Tyrsz/Audio_Processor/Thesis/Report/Figures/Pictures/Aellö Front w.jpg

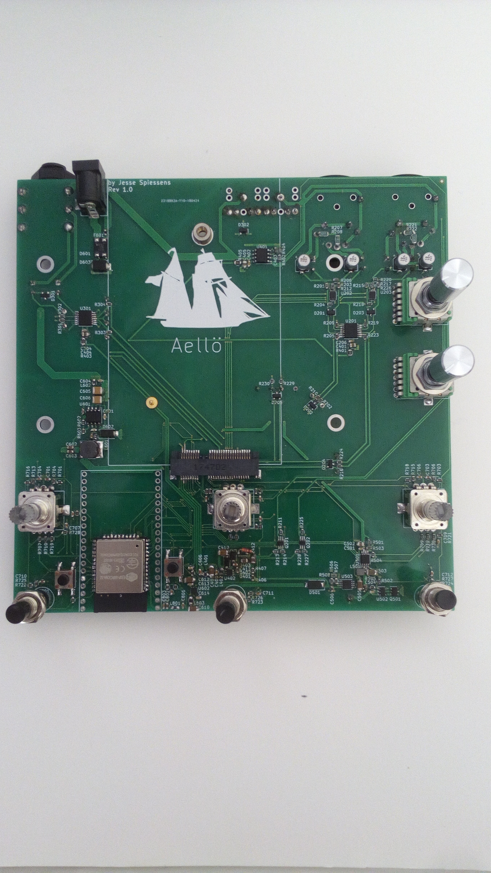
Thesis/Report/Figures/Pictures/Aellö Front w.jpg
