Tyrsz/Audio_Processor/Thesis/Report/Figures/Pictures/MCU.jpg

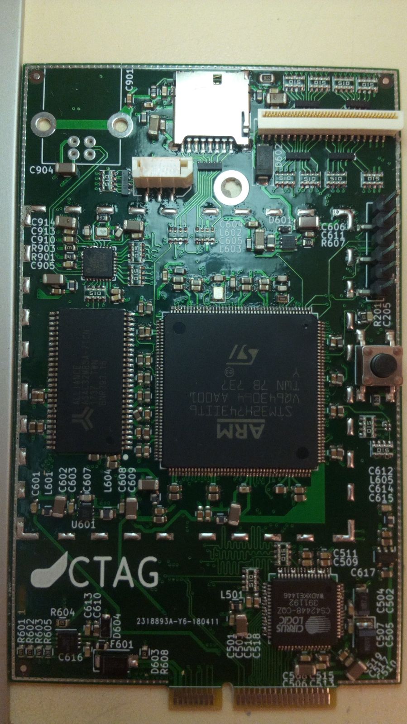
Thesis/Report/Figures/Pictures/MCU.jpg
