Tyrsz/Audio_Processor/Thesis/Report/titelblad eindwerk 2017-2018.docx

Modular Audio Effects Pedal
Door: Jesse Spiessens Promotor hogeschool: Dirk Van Merode Promotor bedrijf: Robert Manzke | Bachelor Electronica-ICT Embedded ICT
| Eindwerk voorgedragen tot het behalen van de graad en het diploma van bachelor Electronica-ICT
| Academiejaar 2017-2018 Campus De Nayer, Jan De Nayerlaan 5, BE-2860 Sint-Katelijne-Waver

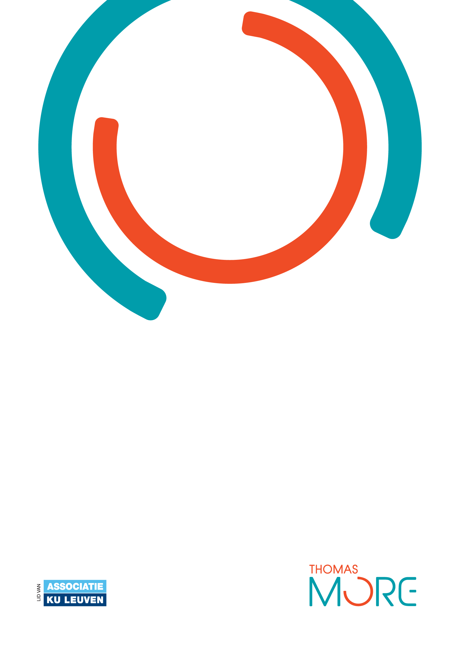
[picture p29: figure]
