Tyrsz/Audio_Processor/Thesis/Cap'n MaGee datasheet/Artwork/Outline/Outline Back.png

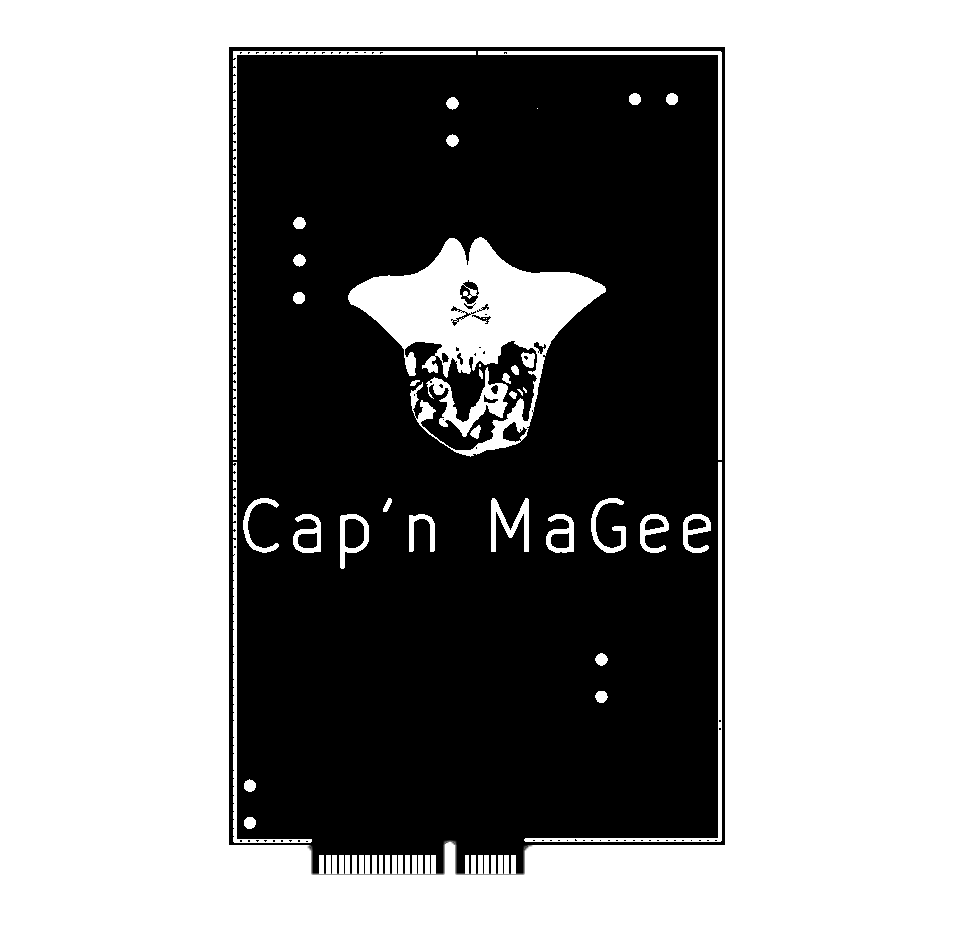
Thesis/Cap'n MaGee datasheet/Artwork/Outline/Outline Back.png
