Tyrsz/Audio_Processor/Thesis/Cap'n MaGee datasheet/Artwork/Outline/Outline Front Connector.png

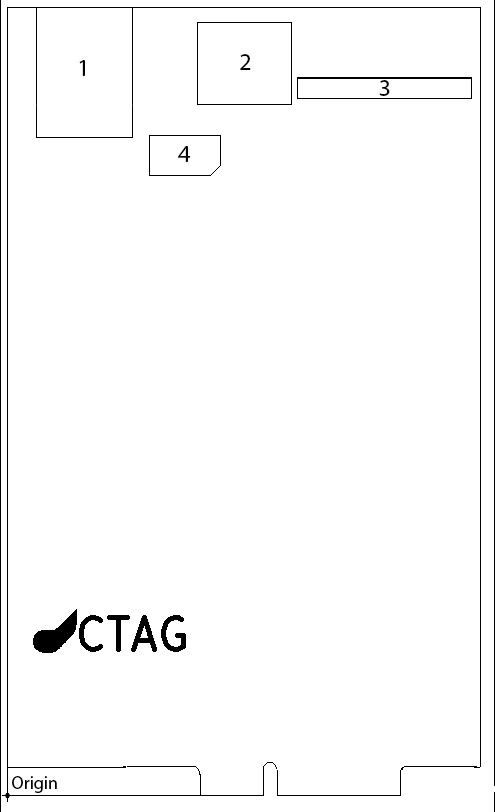
Thesis/Cap'n MaGee datasheet/Artwork/Outline/Outline Front Connector.png
