Tyrsz/Audio_Processor/Thesis/Cap'n MaGee datasheet/Artwork/Outline/Outline Front Dimensions.png

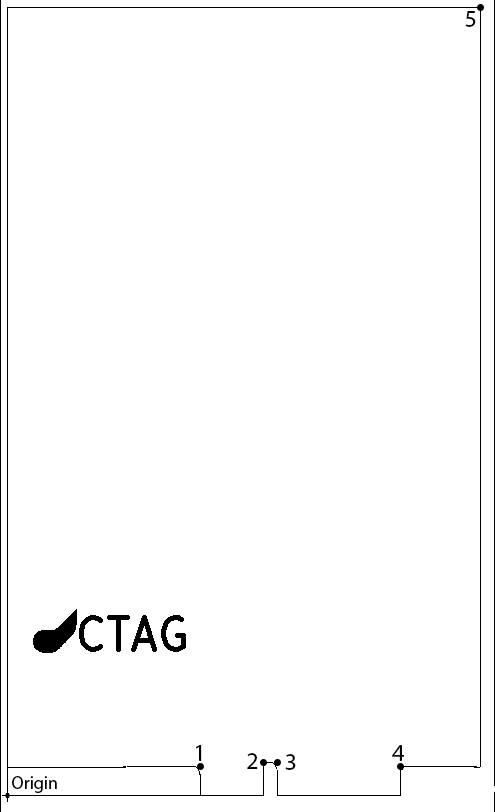
Thesis/Cap'n MaGee datasheet/Artwork/Outline/Outline Front Dimensions.png
