Tyrsz/Audio_Processor/Thesis/Cap'n MaGee datasheet/Artwork/Outline/Outline Front.png

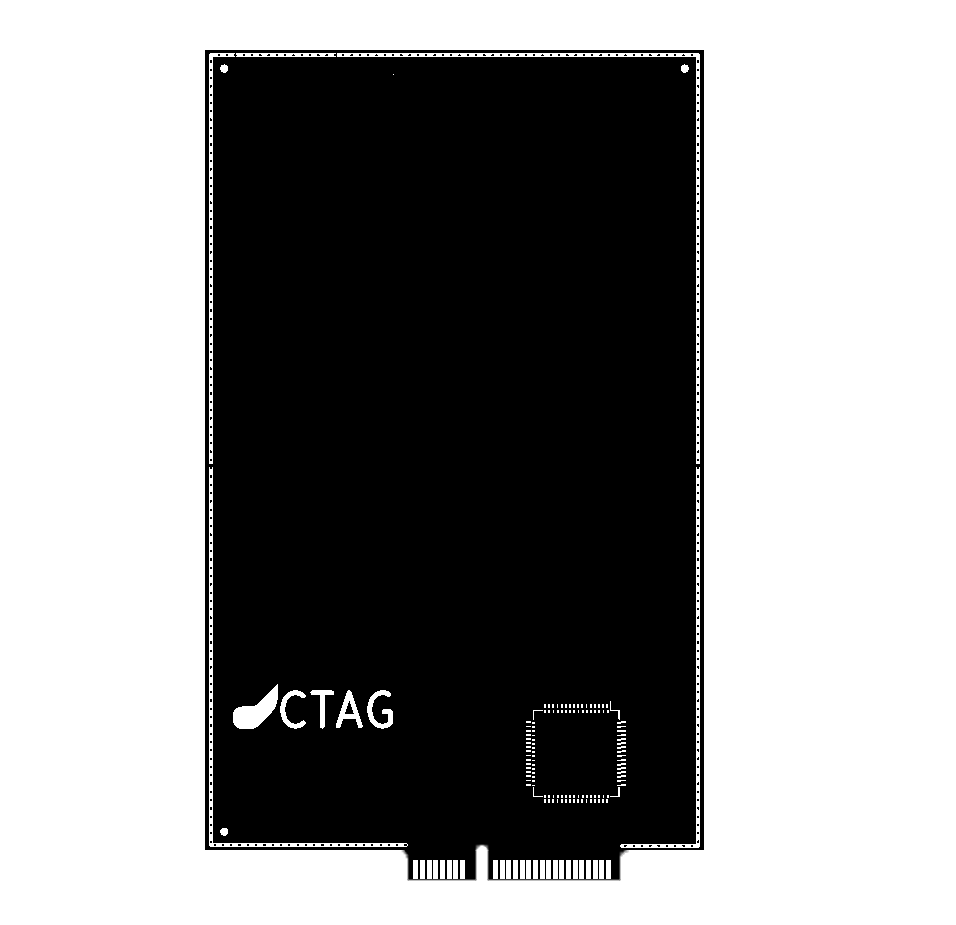
Thesis/Cap'n MaGee datasheet/Artwork/Outline/Outline Front.png
