Tyrsz/Audio_Processor/Thesis/Cap'n MaGee datasheet/Notes/foto's/NewFile1.png

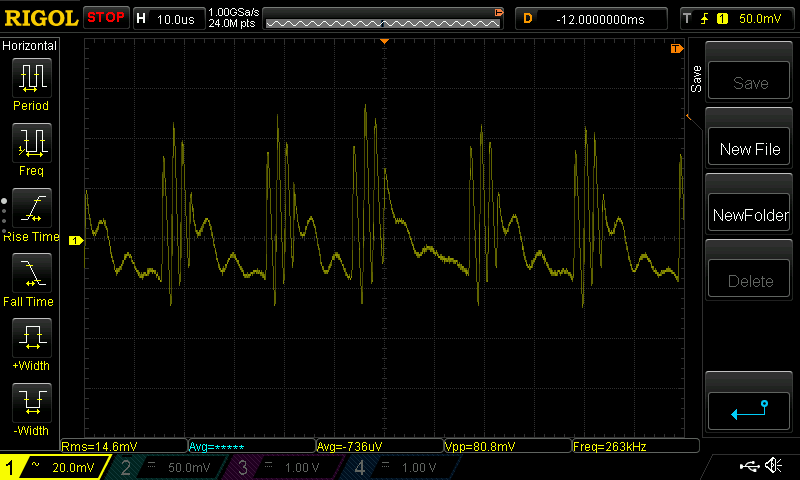
Thesis/Cap'n MaGee datasheet/Notes/foto's/NewFile1.png
