Tyrsz/Audio_Processor/Thesis/Cap'n MaGee datasheet/Notes/foto's/NewFile2.png

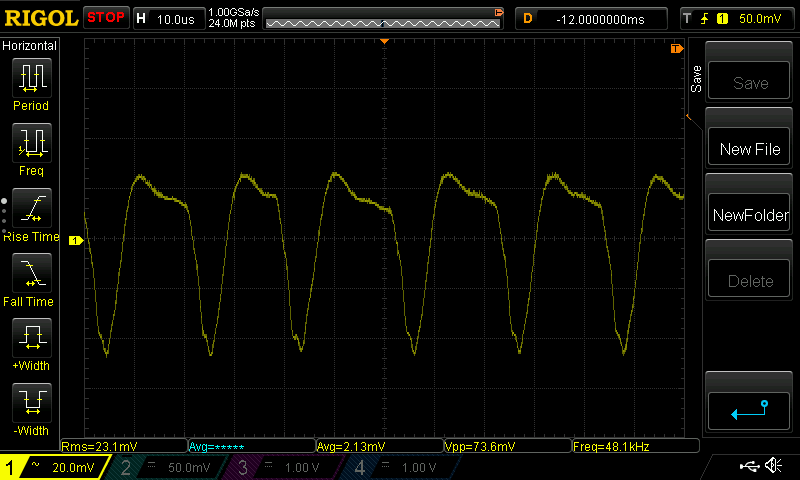
Thesis/Cap'n MaGee datasheet/Notes/foto's/NewFile2.png
