Tyrsz/Audio_Processor/Thesis/Cap'n MaGee datasheet/Notes/foto's/NewFile5.png

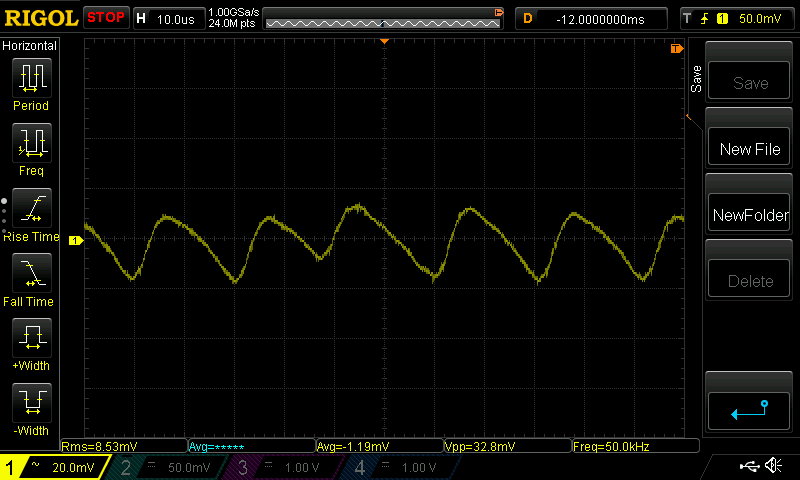
Thesis/Cap'n MaGee datasheet/Notes/foto's/NewFile5.png
