Tyrsz/Audio_Processor/Thesis/Cap'n MaGee datasheet/Notes/foto's/NewFile7.png

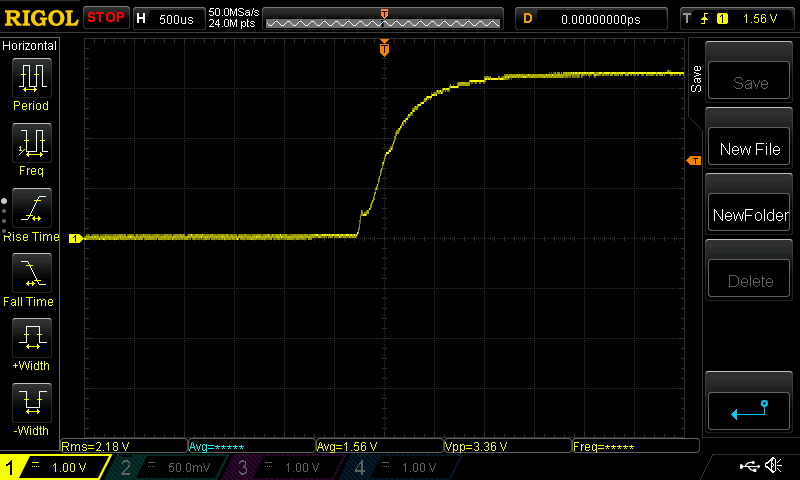
Thesis/Cap'n MaGee datasheet/Notes/foto's/NewFile7.png
