Tyrsz/Audio_Processor/Thesis/Cap'n MaGee datasheet/Notes/foto's/NewFile8.png

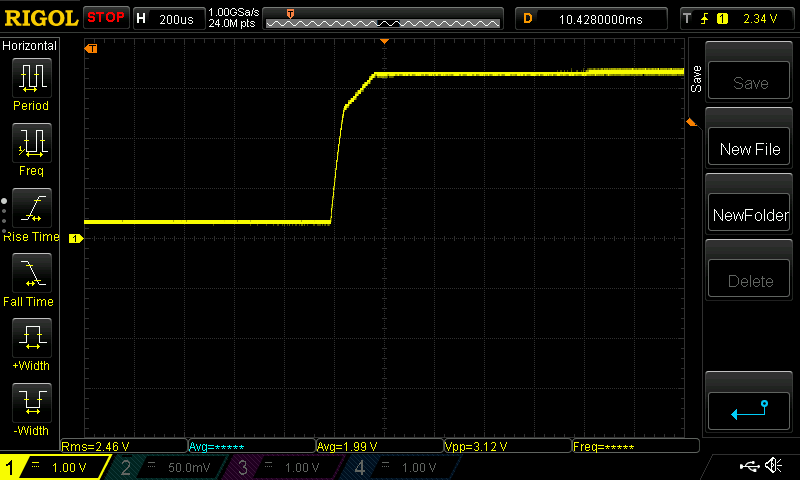
Thesis/Cap'n MaGee datasheet/Notes/foto's/NewFile8.png
