Tyrsz/Audio_Processor/Thesis/Cap'n MaGee datasheet/Notes/foto's/NewFile9.png

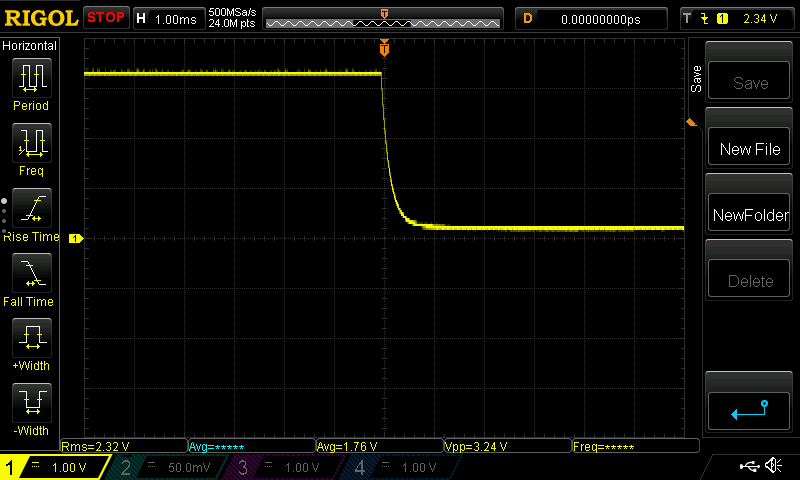
Thesis/Cap'n MaGee datasheet/Notes/foto's/NewFile9.png
