Tyrsz/Audio_Processor/Thesis/Cap'n MaGee datasheet/Notes/foto's/NewFile10.png

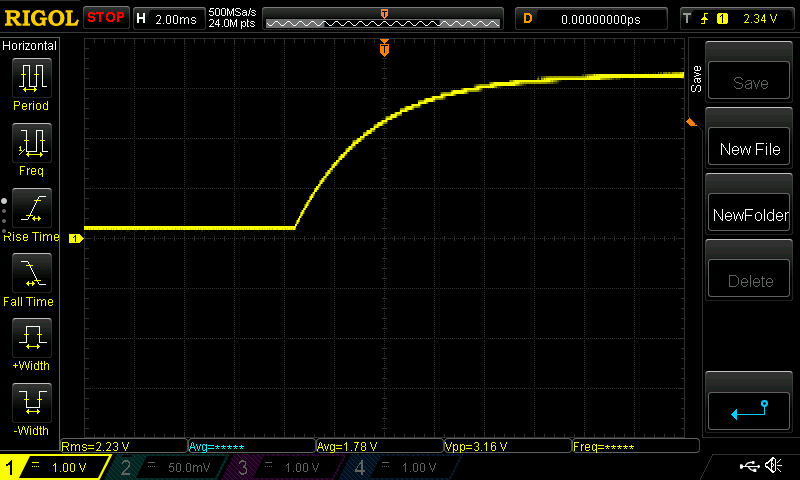
Thesis/Cap'n MaGee datasheet/Notes/foto's/NewFile10.png
