Tyrsz/Audio_Processor/Thesis/Report/Figures/bouncing.png

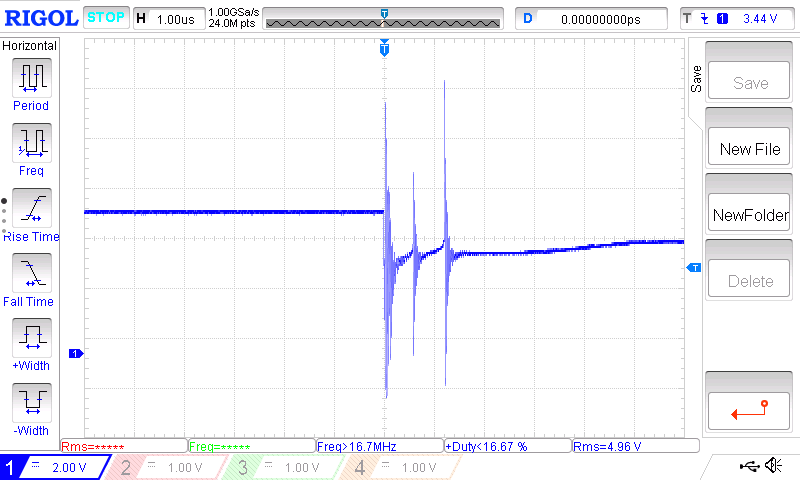
Thesis/Report/Figures/bouncing.png
