Tyrsz/Audio_Processor/Thesis/Report/Figures/Cap'n Magee.jpg

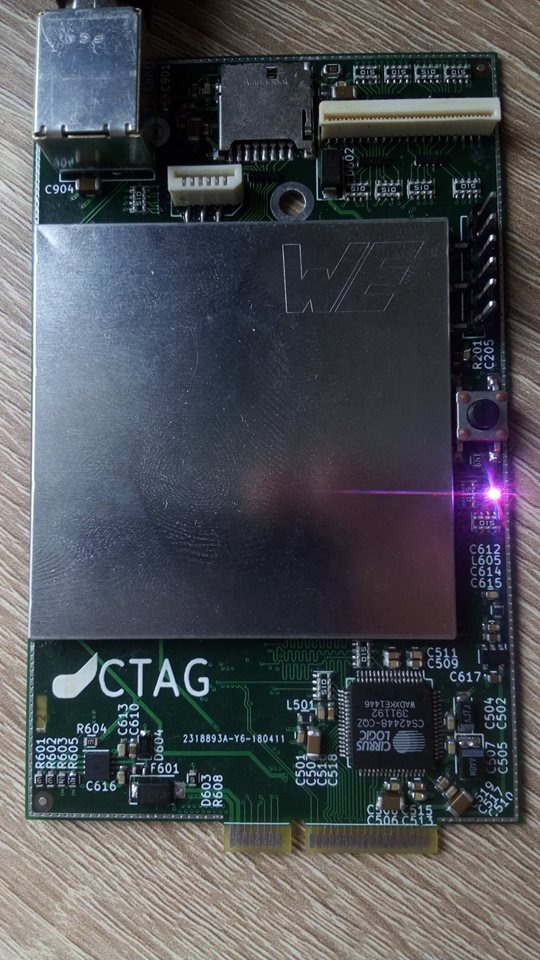
Thesis/Report/Figures/Cap'n Magee.jpg
