Tyrsz/Audio_Processor/Thesis/Report/Figures/Pictures/Cap'n Magee Front.jpg

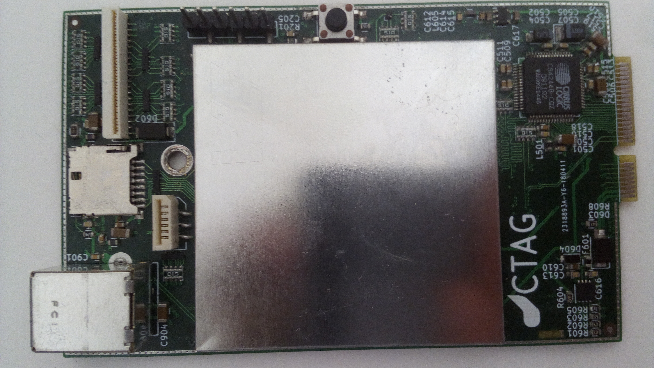
Thesis/Report/Figures/Pictures/Cap'n Magee Front.jpg
