Tyrsz/Audio_Processor/Thesis/Report/Figures/Pictures/IMG_20180526_105409.jpg

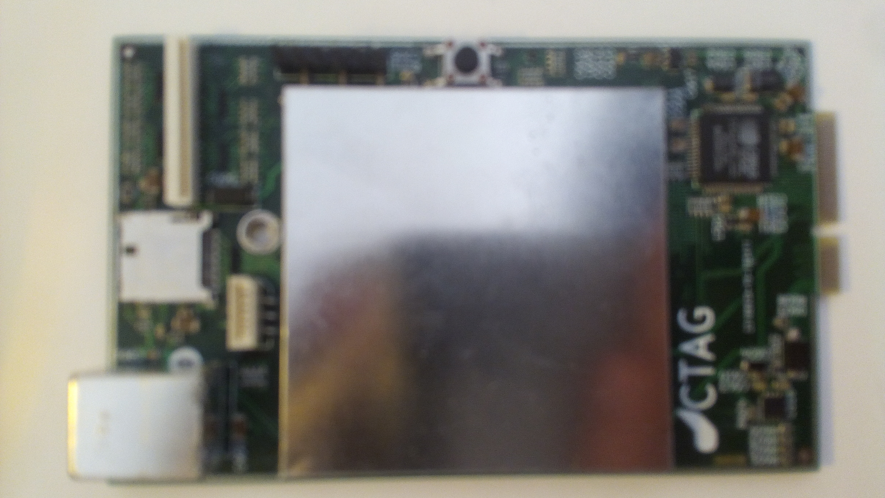
Thesis/Report/Figures/Pictures/IMG_20180526_105409.jpg
