Tyrsz/Audio_Processor/Thesis/Report/Figures/Pictures/IMG_20180526_105412.jpg

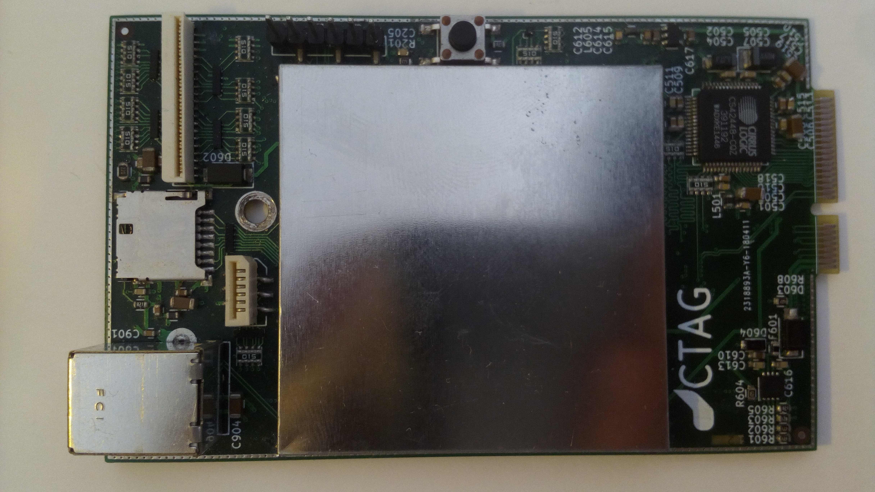
Thesis/Report/Figures/Pictures/IMG_20180526_105412.jpg
