Tyrsz/Audio_Processor/Thesis/Report/Figures/Pictures/IMG_20180526_110501.jpg

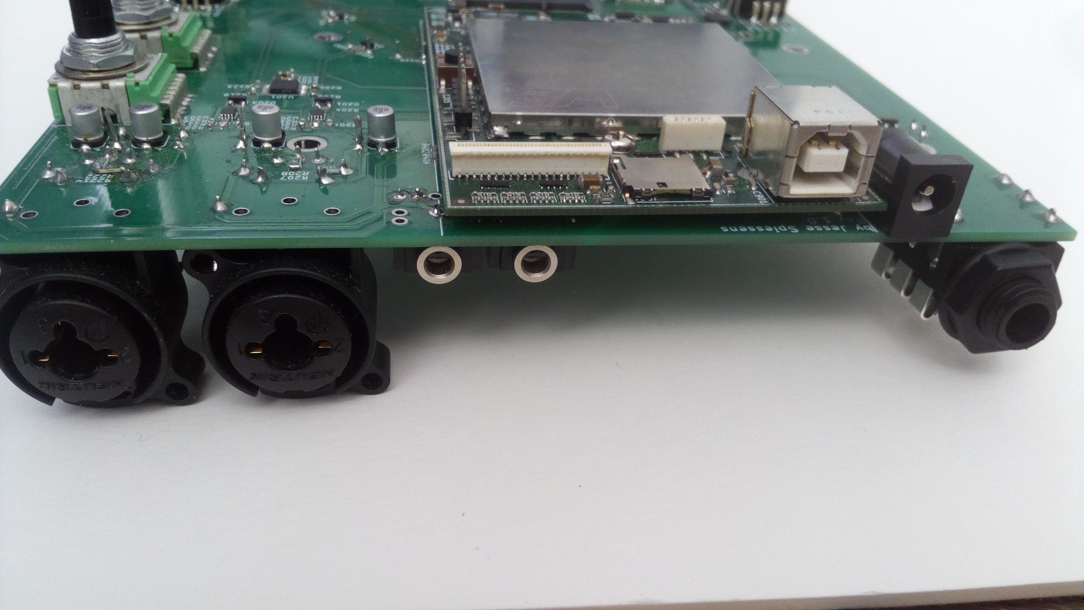
Thesis/Report/Figures/Pictures/IMG_20180526_110501.jpg
