Tyrsz/Audio_Processor/Thesis/Report/Figures/Pictures/IMG_20180526_151601.jpg

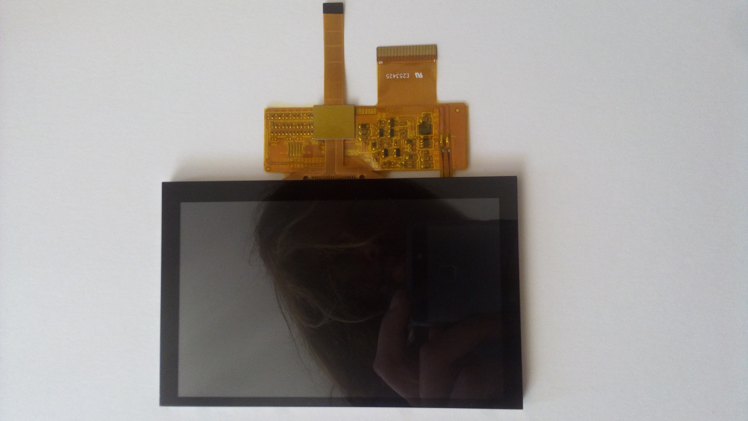
Thesis/Report/Figures/Pictures/IMG_20180526_151601.jpg
