Tyrsz/Audio_Processor/Thesis/Report/Figures/Pictures/Joint connector.jpg

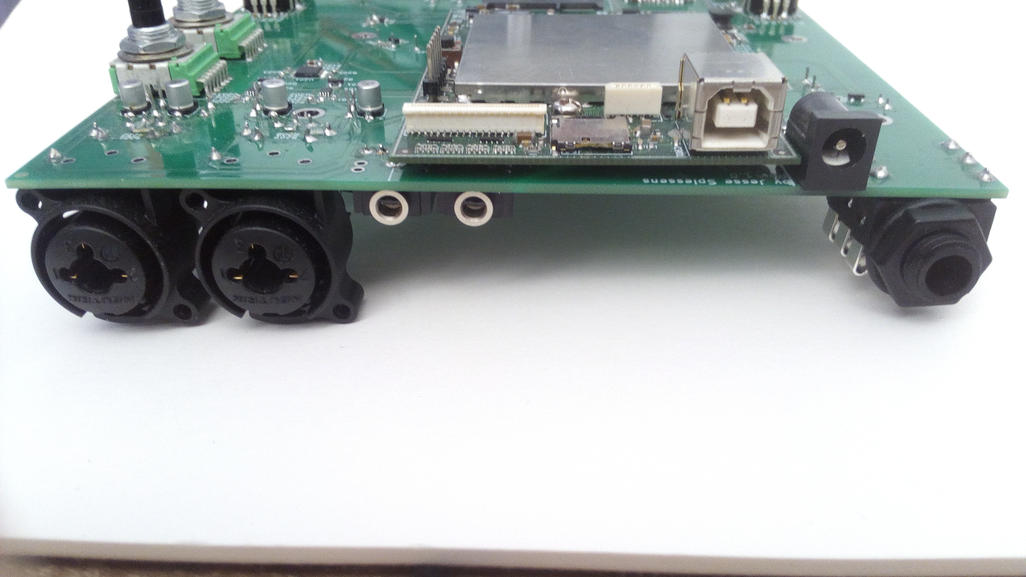
Thesis/Report/Figures/Pictures/Joint connector.jpg
