Tyrsz/Audio_Processor/Thesis/Report/Figures/Pictures/Screen.jpg

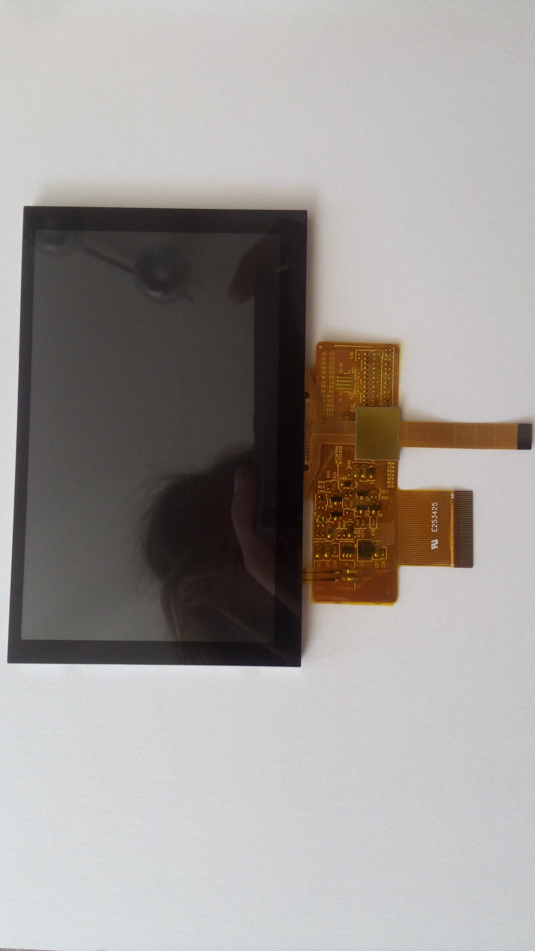
Thesis/Report/Figures/Pictures/Screen.jpg
