Tyrsz/Audio_Processor/Thesis/Report/Figures/program structure (1).png

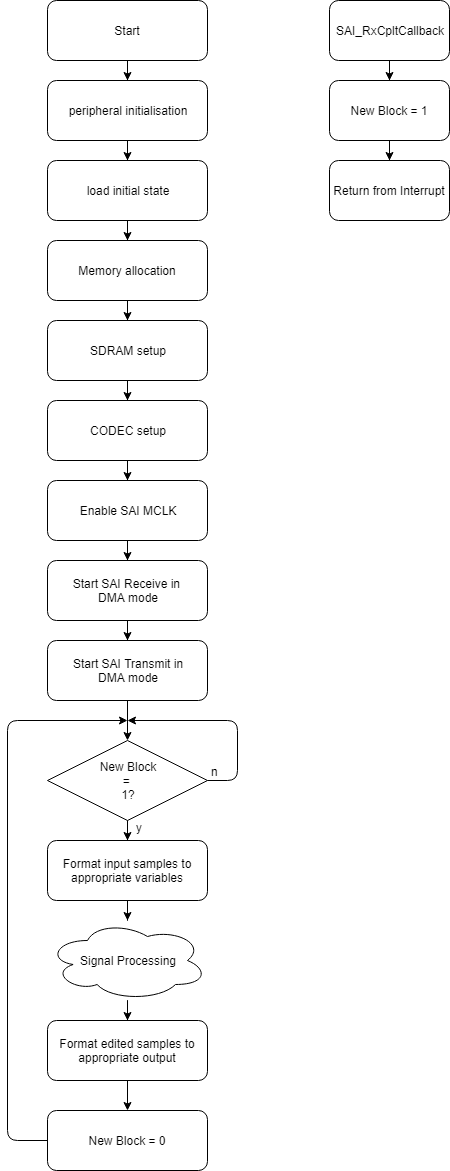
Thesis/Report/Figures/program structure (1).png
