Tyrsz/Audio_Processor/Thesis/Report/Figures/Ringing.png

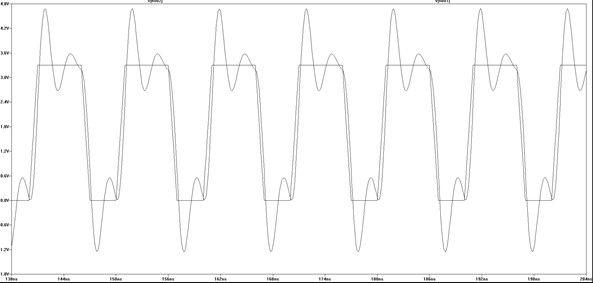
Thesis/Report/Figures/Ringing.png
