Tyrsz/Audio_Processor/PCB/DSP board/BOM/Bachelor PCB.ods

Description | package | Name | Amount | Price | Order number | Link
MCU | LQFP-176 | STM32H743IIT6 | 0 | 0 | 511-STM32H743IIT6 | https://www.mouser.be/ProductDetail/STMicroelectronics/STM32H743IIT6
SDRAM 32MByte | TSSOP-54 | AS4C32M8SA-7TCN | 1 | 3,12 | 913-AS4C32M8SA7TCN | https://www.mouser.be/ProductDetail/Alliance-Memory/AS4C32M8SA-7TCN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
CODEC | LQFP-64 | CS42448-CQZ | 1 | 9,42 | 777-CS42448-CQZ | https://www.mouser.be/ProductDetail/Cirrus-Logic/CS42448-CQZ?qs=sGAEpiMZZMuYaq4aOfOV%252bIuNLgj4vBkq
USB Phy | QFN-32 | USB3300-EZK-TR | 1 | 1,22 | 886-USB3300-EZK-TR | https://www.mouser.be/ProductDetail/Microchip-Technology/USB3300-EZK-TR
Power mux | SON-8 | TPS2113ADRBR | 1 | 1,6 | 595-TPS2113ADRBR | https://www.mouser.be/ProductDetail/Texas-Instruments/TPS2113ADRBR?qs=sGAEpiMZZMsIeRsI8taJiut%252bTnXQ%252bmOX
Buck | MLF-8 | MIC23050-SYML-TR | 1 | 0,385 | 998-MIC23050-SYMLTR | https://www.mouser.be/ProductDetail/Microchip-Technology-Micrel/MIC23050-SYML-TR
low noise LDO | TSOT-5 | ADP150AUJZ-3.3-R7 | 1 |  | 584-ADP150AUJZ-3.3R7 | https://www.mouser.be/ProductDetail/Analog-Devices/ADP150AUJZ-33-R7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
 |  | ADP151AUJZ-3.3-R7 | 1 | 0,877 | 584-ADP151AUJZ-3.3R7 | https://www.mouser.be/ProductDetail/Analog-Devices/ADP151AUJZ-33-R7
Boost | WSON-6 | TPS61170DRVR | 1 | 1,71 | 595-TPS61170DRVR | https://www.mouser.be/productdetail/texas-instruments/tps61170drvr
6 pin header | 2.54mm SMD | M20-8770646 | 1 | 0,361 | 855-M20-8770646 | https://www.mouser.be/ProductDetail/Harwin/M20-8770646
40 pin 0.5mm | 0.5mm vertical | 78127-1408 | 1 | 1,94 | 538-78127-1408 | https://www.mouser.be/ProductDetail/Molex/78127-1408
6 pin 1mm | 1mm vertical | 52808-0671 | 1 | 0,484 | 538-52808-0671 | https://www.mouser.be/ProductDetail/Molex/52808-0671?qs=sGAEpiMZZMs7i6cT6ogu4152O94naRbpkoChlag4gQ4=
SD Holder | 1140084168 | SMD | 1 | 1,23 | 523-114-00841-68 | https://www.mouser.be/ProductDetail/Amphenol-Commercial-Products/1140084168
USB connector Mini | UJ2-BH-1-TH | Type B | 1 | 0,525 | 490-UJ2-BH-1-TH | https://www.mouser.be/ProductDetail/CUI/UJ2-BH-1-TH
Button | 6x6mm smd | FSM4JSMATR | 1 | 0,139 | 506-FSM4JSMATR | https://www.mouser.be/ProductDetail/TE-Connectivity-Alcoswitch/FSM4JSMATR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
32KHz crystal | 1.6x1mm | ABS05-32.768KHZ-9-T | 1 | 0,64 | 815-ABS05-32.768K9T | https://www.mouser.be/ProductDetail/ABRACON/ABS05-32768KHZ-9-T
16MHz crystal | 2x1.6mm | CX2016DB16000H0FLJC1 | 1 |  | 581-CX2016DB16000HLJ | https://www.mouser.be/ProductDetail/AVX-Kyocera/CX2016DB16000H0FLJC1
 | 2x1.6mm | FW1600008 | 1 | 1,15 | 729-FW1600008 | https://www.mouser.be/ProductDetail/Diodes-Inc-Pericom/FW1600008?qs=Rp3RbKSfAt3lER%252bb%252byb4eQ%3d%3d
24MHz crystal | 2x1.6mm | XRCGB24M000F1H02R0 | 1 | 0,41 | 81-XRCGB24M000F1H02R | https://www.mouser.be/ProductDetail/Murata-Electronics/XRCGB24M000F1H02R0
1.25A fuse | 0603 | F0603E1R25FSTR | 1 | 0,23 | 581-F0603E1R25FSTR | https://www.mouser.be/ProductDetail/AVX/F0603E1R25FSTR
EMI gasket | 50x50mm | 36103505S | 1 | 1,73 | 710-36103505S | https://www.mouser.be/ProductDetail/Wurth-Electronics/36103505S
EMI hat | 50x50mm | 36003500S | 1 | 1,22 | 710-36003500S | https://www.mouser.be/ProductDetail/Wurth-Electronics/36003500S
3mm mounting screw | 4mm M3-0.5 | 481-0263 | 1 | 0,162 | 481-0263 | https://www.mouser.be/ProductDetail/Eagle-Plastic-Devices/481-0263
Caps
100nF 10V X7R | 0603 | 8,85012E+11 | 26 | 1,04 | 710-885012206020 | https://www.mouser.be/ProductDetail/Wurth-Electronics/885012206020
2.2uF 10V X7R | 0603 | C1608X7R1A225M080AC | 2 | 0,394 | 810-C1608X7R1A225M | https://www.mouser.be/ProductDetail/TDK/C1608X7R1A225M080AC
1uF 25V X7R | 0603 | TMK107B7105MA-T | 28 |  | 963-TMK107B7105MA-T | https://www.mouser.be/ProductDetail/Taiyo-Yuden/TMK107B7105MA-T
10V | 0603 | LMK107B7105MA-T | 28 | 0,588 | 963-LMK107B7105MA-T | https://www.mouser.be/ProductDetail/Taiyo-Yuden/LMK107B7105MA-T
10nF 50V X7R | 0603 | 8,85012E+11 | 38 |  | 710-885012206089 | https://www.mouser.be/ProductDetail/Wurth-Electronics/885012206089
 | 0603 | C0603C103J5RACTU | 38 | 0,608 | 80-C0603C103J5R | https://www.mouser.be/ProductDetail/KEMET/C0603C103J5RACTU?qs=sGAEpiMZZMvsSlwiRhF8quIsB1QHp5lf6wge94WzHBg%3d
4.7uF 10V X7R | 0805 | GRM21BR71A475ME51L | 12 |  | 81-GRM21BR71A475ME1L | https://www.mouser.be/ProductDetail/Murata-Electronics/GRM21BR71A475ME51L
 | 0805 | GRM21BR71A475KE51L | 12 | 1,248 | 81-GRM21BR71A475KE1L | https://www.mouser.be/ProductDetail/Murata-Electronics/GRM21BR71A475KE51L
18pf C0G | 0603 | C0603C180J5GACTU | 6 |  | 80-C0603C180J5G | https://www.mouser.be/ProductDetail/KEMET/C0603C180J5GACTU?qs=sGAEpiMZZMs0AnBnWHyRQJIiGvDVk92VyAyEaQH0tQM%3d
 | 0603 | C0603C180J5GAC7867 | 6 | 0,492 | 80-C0603C180J5G7867 | https://www.mouser.be/ProductDetail/KEMET/C0603C180J5GAC7867
22uF 10V tantalum | 1206 | TMCMA1A226MTRF | 1 | 0,197 | 74-TMCMA1A226MTRF | https://www.mouser.be/ProductDetail/Vishay-Sprague/TMCMA1A226MTRF
100uF 10V tantalum | 1311 | TMCMB1A107MTRF | 1 | 0,41 | 74-TMCMB1A107MTRF | https://www.mouser.be/ProductDetail/Vishay-Sprague/TMCMB1A107MTRF
560pF C0G | 0603 | VJ0603A561GXXCW1BC | 1 | 0,082 | 77-VJ0603A561GXXCBC | https://www.mouser.be/ProductDetail/Vishay-Vitramon/VJ0603A561GXXCW1BC
4.7uF 50V X7R | 1206 | UMK316AB7475ML-T | 1 |  | 963-UMK316AB7475ML-T | https://www.mouser.be/ProductDetail/Taiyo-Yuden/UMK316AB7475ML-T
 | 1206 | C3216X7R1H475M160AE | 1 | 0,689 | 810-C3216X7R1H475M1E | https://www.mouser.be/ProductDetail/TDK/C3216X7R1H475M160AE
Ferrites & inductors
220R ferrite 2.2A | 0603 | KPZ1608SHR221ATD25 | 7 | 0,805 | 810-KPZ1608SHR221ATD | https://www.mouser.be/ProductDetail/TDK/KPZ1608SHR221ATD25
1k ferrite 400mA | 0603 | MMZ1608S102ATD25 | 3 | 0,246 | 810-MMZ1608S102ATD25 | https://www.mouser.be/ProductDetail/TDK/MMZ1608S102ATD25
1uH 1.15A | 0805 | MLZ2012N1R0L | 1 | 0,107 | 810-MLZ2012N1R0L | https://www.mouser.be/ProductDetail/TDK/MLZ2012N1R0L
15uH 350mA | 0805 | MLZ2012N150L | 1 | 0,107 | 810-MLZ2012N150L | https://www.mouser.be/ProductDetail/TDK/MLZ2012N150L
Resistors
12k | 0603 | CR0603-FX-1202ELF | 6 | 0,492 | 652-CR0603FX-1202ELF | https://www.mouser.be/ProductDetail/Bourns/CR0603-FX-1202ELF
820R | 0603 | RC0603FR-07820RL | 5 | 0,41 | 603-RC0603FR-07820RL | https://www.mouser.be/ProductDetail/Yageo/RC0603FR-07820RL?qs=sGAEpiMZZMvdGkrng054t8AJgcdMkx7x9jKvOIkYsDs%3d
51R 4x network | 0603 | 742C083510JP | 25 | 1,6 | 774-742C083510JP | https://www.mouser.be/ProductDetail/CTS-Electronic-Components/742C083510JP
22R | 0805 | ESR10EZPJ220 | 1 | 0,082 | 755-ESR10EZPJ220 | https://www.mouser.be/ProductDetail/ROHM-Semiconductor/ESR10EZPJ220
1Meg | 0603 | RC0603FR-071ML | 1 | 0,082 | 603-RC0603FR-071ML | https://www.mouser.be/ProductDetail/Yageo/RC0603FR-071ML
Discrete Semi
50V 3A diode | DO-221AC-2 | VSSAF3N50-M3/6A | 1 | 0,451 | 78-VSSAF3N50-M36A | https://www.mouser.be/ProductDetail/Vishay-Semiconductors/VSSAF3N50-M3-6A
5V 30KV 15A TVS | SOD-323F-2 | CPDF5V0U | 1 | 0,328 | 750-CPDF5V0U | https://www.mouser.be/ProductDetail/Comchip-Technology/CPDF5V0U
30V 0.2A diode | SOD-523 | RB521S30T1G | 1 | 0,148 | 863-RB521S30T1G | https://www.mouser.be/ProductDetail/ON-Semiconductor/RB521S30T1G
22V zener | DO214AC-2 | SMAJ5933B-TP | 1 | 0,344 | 833-SMAJ5933B-TP | https://www.mouser.be/ProductDetail/Micro-Commercial-Components-MCC/SMAJ5933B-TP
3V3 ESD 8 channel | 3.8x1mm | DT1240A-08LP3810-7 | 6 | 1,872 | 621-DT1240A08LP38107 | https://www.mouser.be/ProductDetail/Diodes-Incorporated/DT1240A-08LP3810-7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
RGB led | PLCC-4 | UHD1110-FKA | 1 | 0,082 | 941-UHD0FKAC11BQFMF3 | https://www.mouser.be/ProductDetail/Cree-Inc/UHD1110-FKA-CL1A13r3q1BBQFMF3
 |  |  |  | 41,457
