Tyrsz/Audio_Processor/PCB/DSP board/Main board.pdf

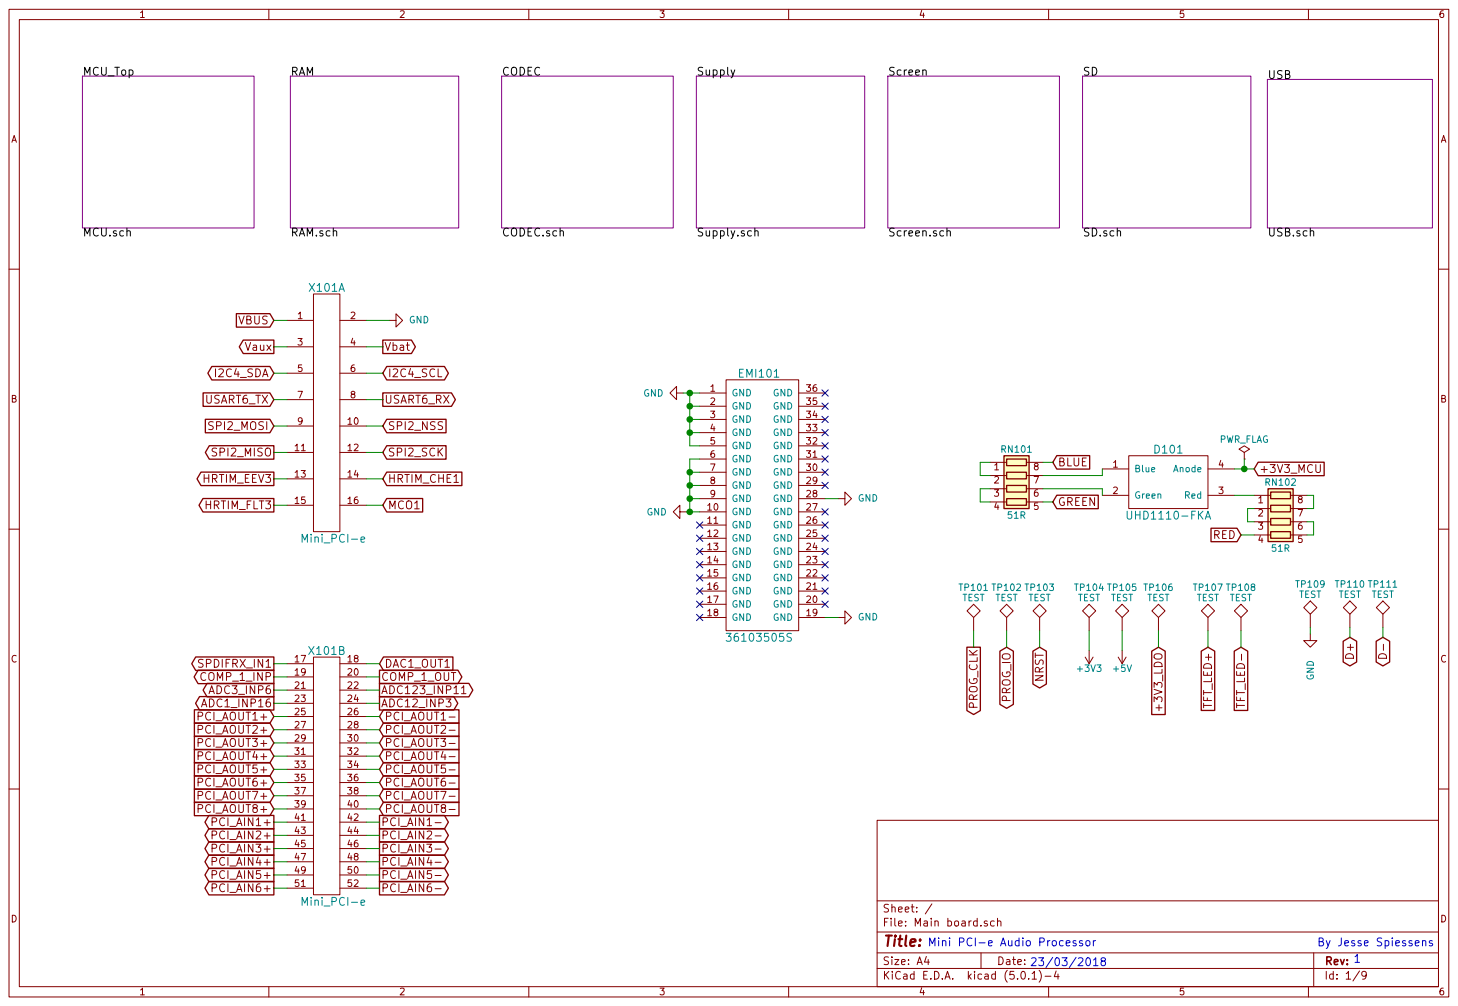
[picture p61: page 1]

Id: 1/9 Title: File: Main board.sch Sheet: /

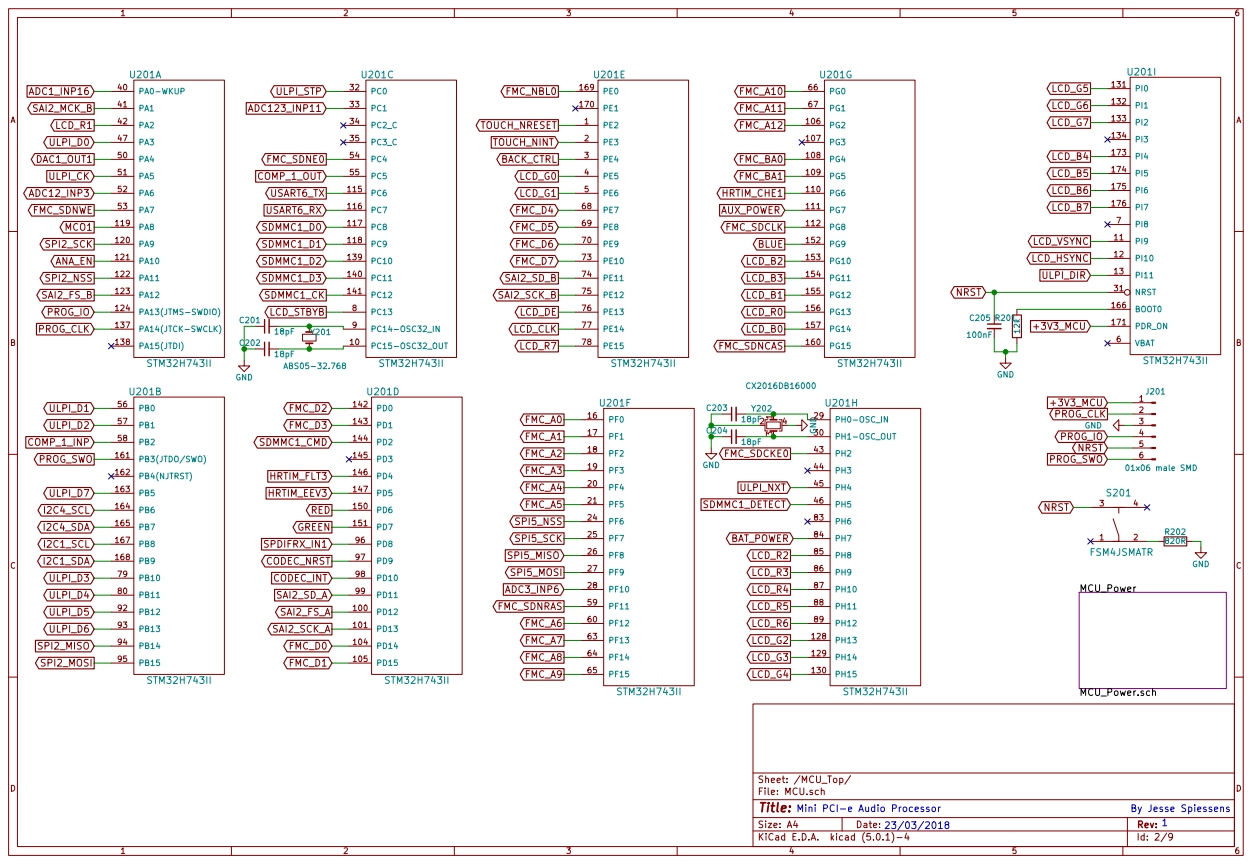
[picture p62: page 2]

Id: 2/9 Title: File: MCU.sch Sheet: /MCU_Top/

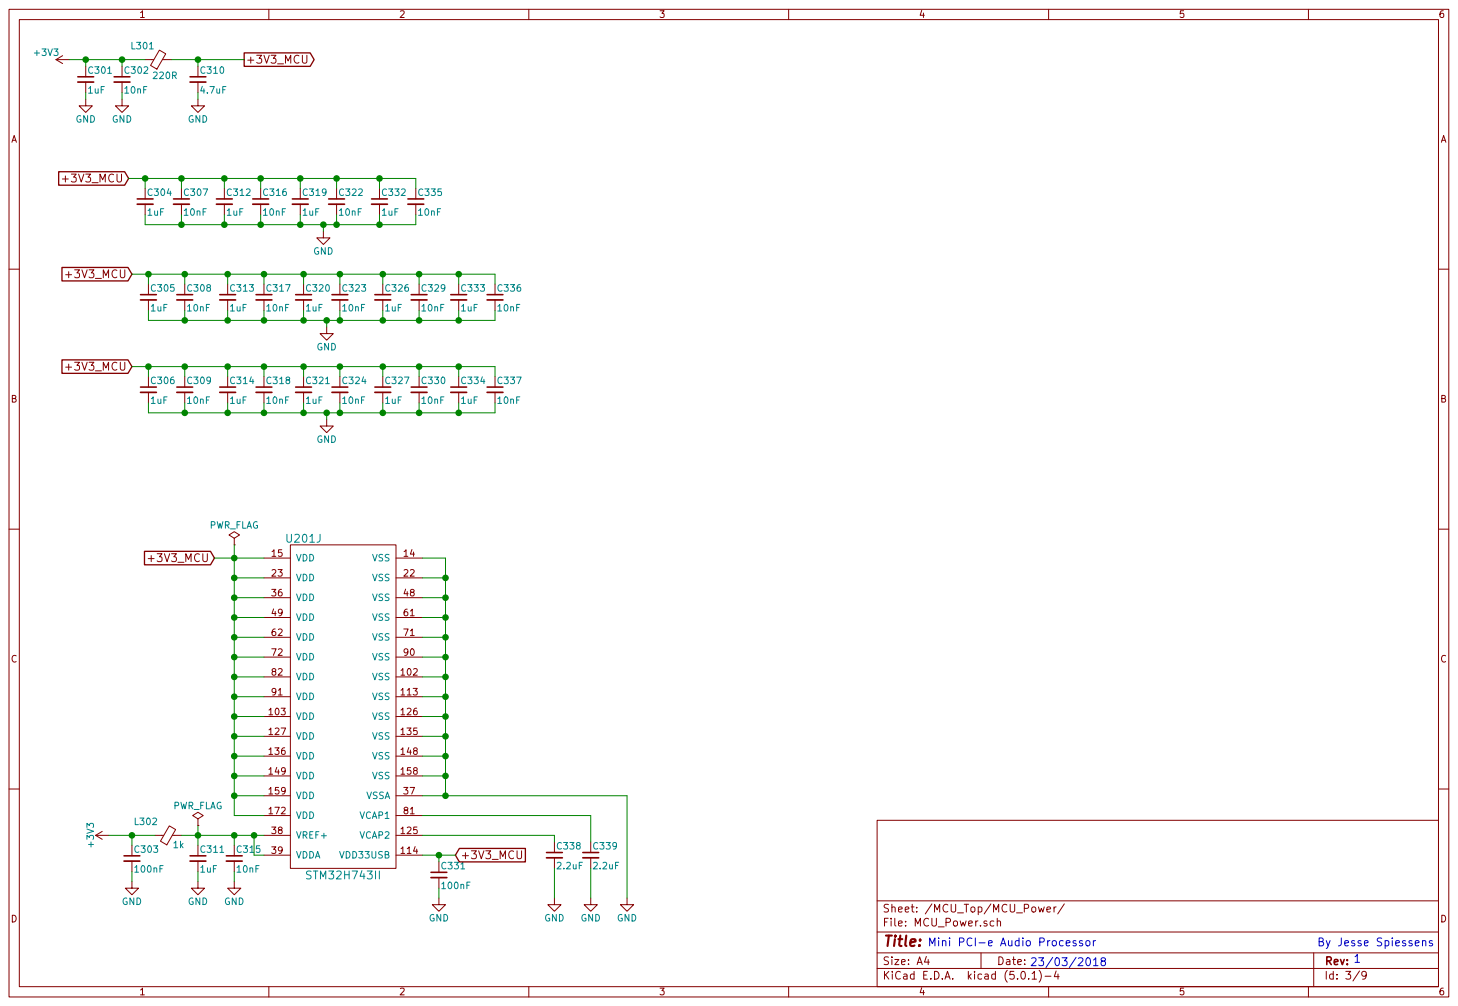
[picture p63: page 3]

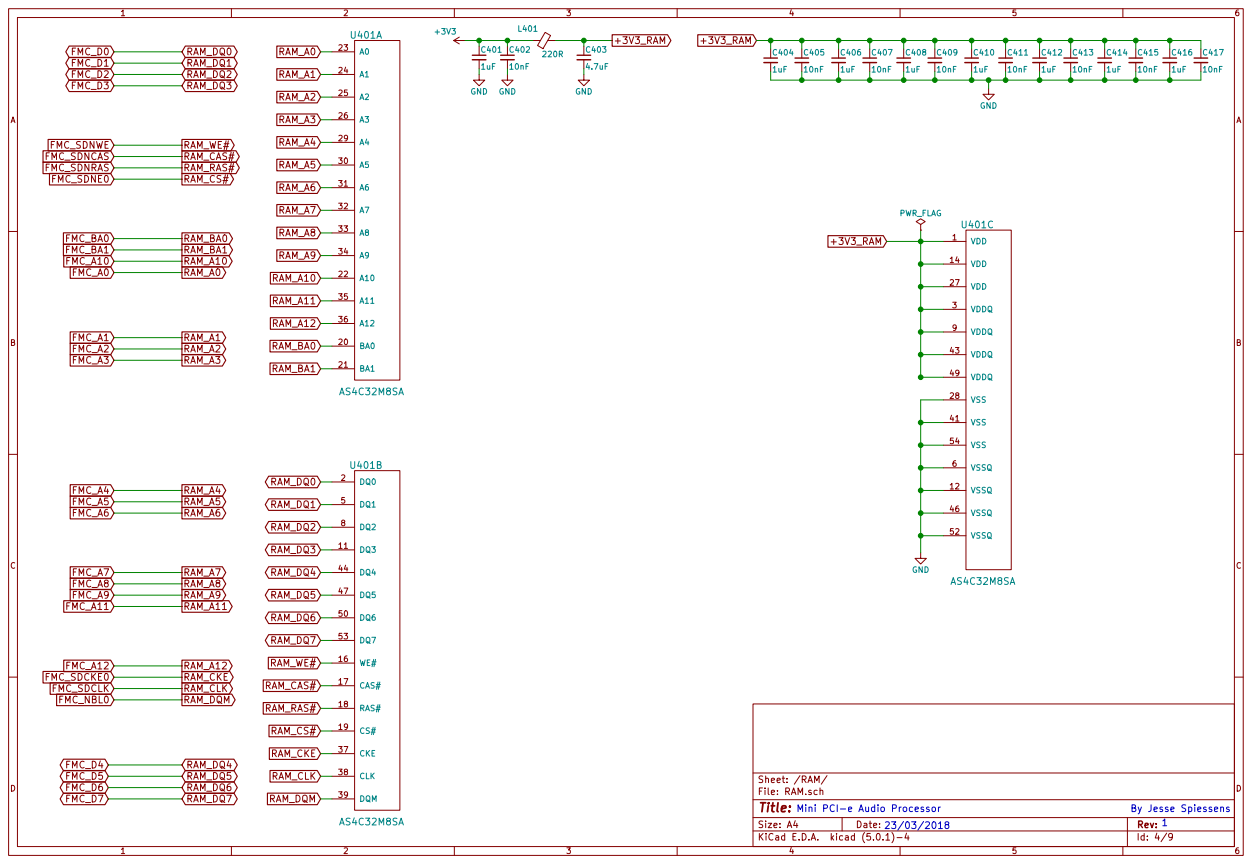
[picture p64: page 4]

Id: 4/9 Title: File: RAM.sch Sheet: /RAM/

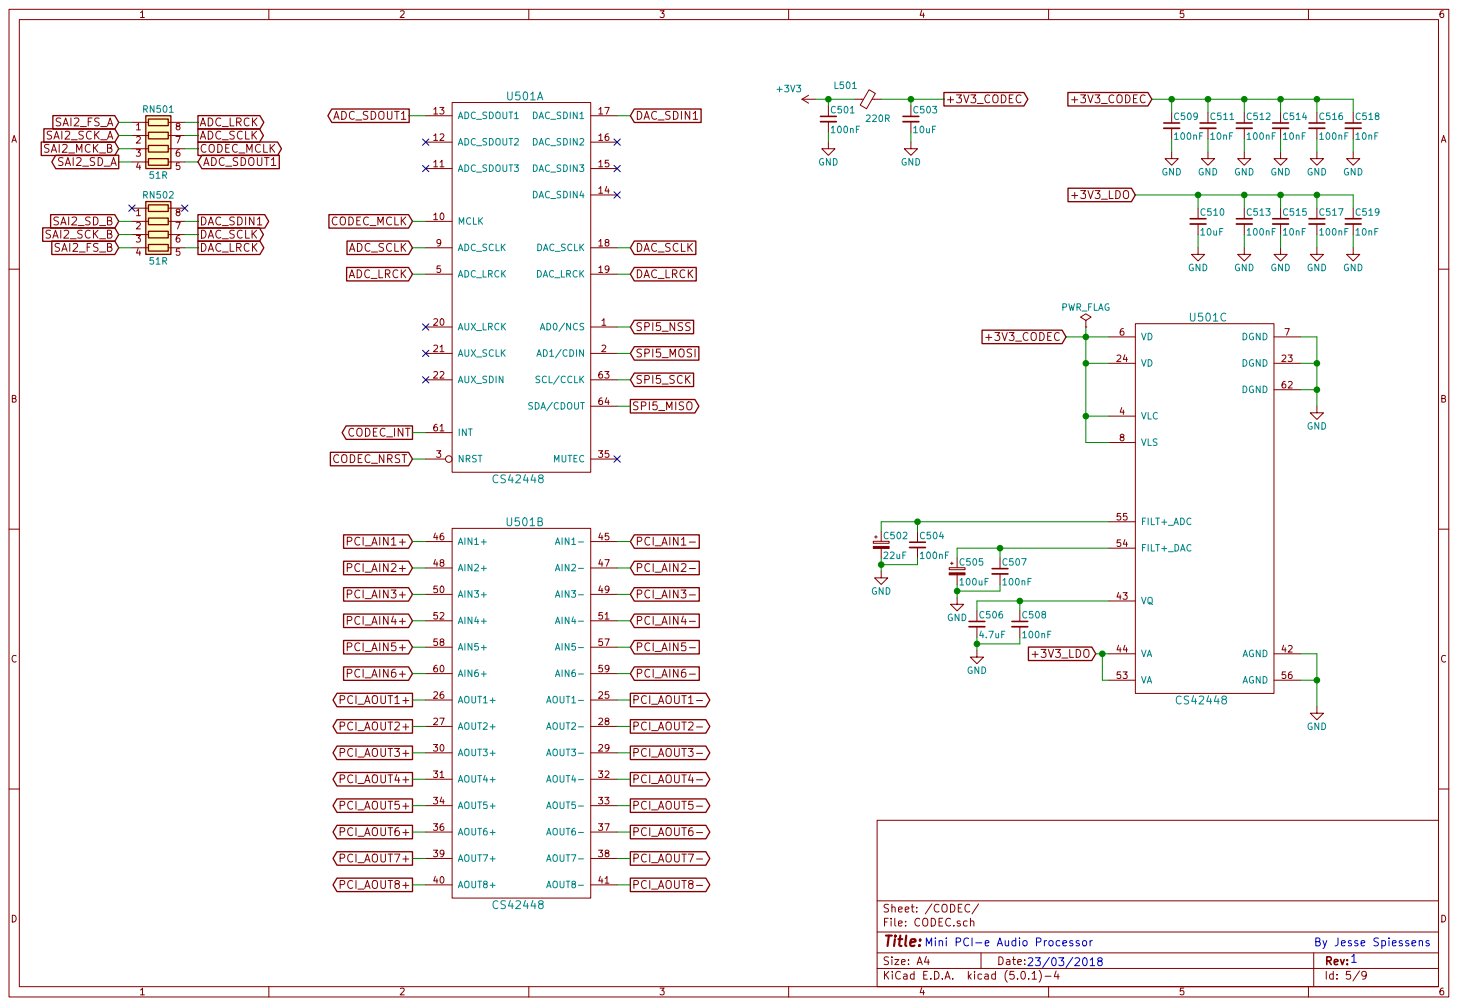
[picture p65: page 5]

Id: 5/9 Title: File: CODEC.sch Sheet: /CODEC/

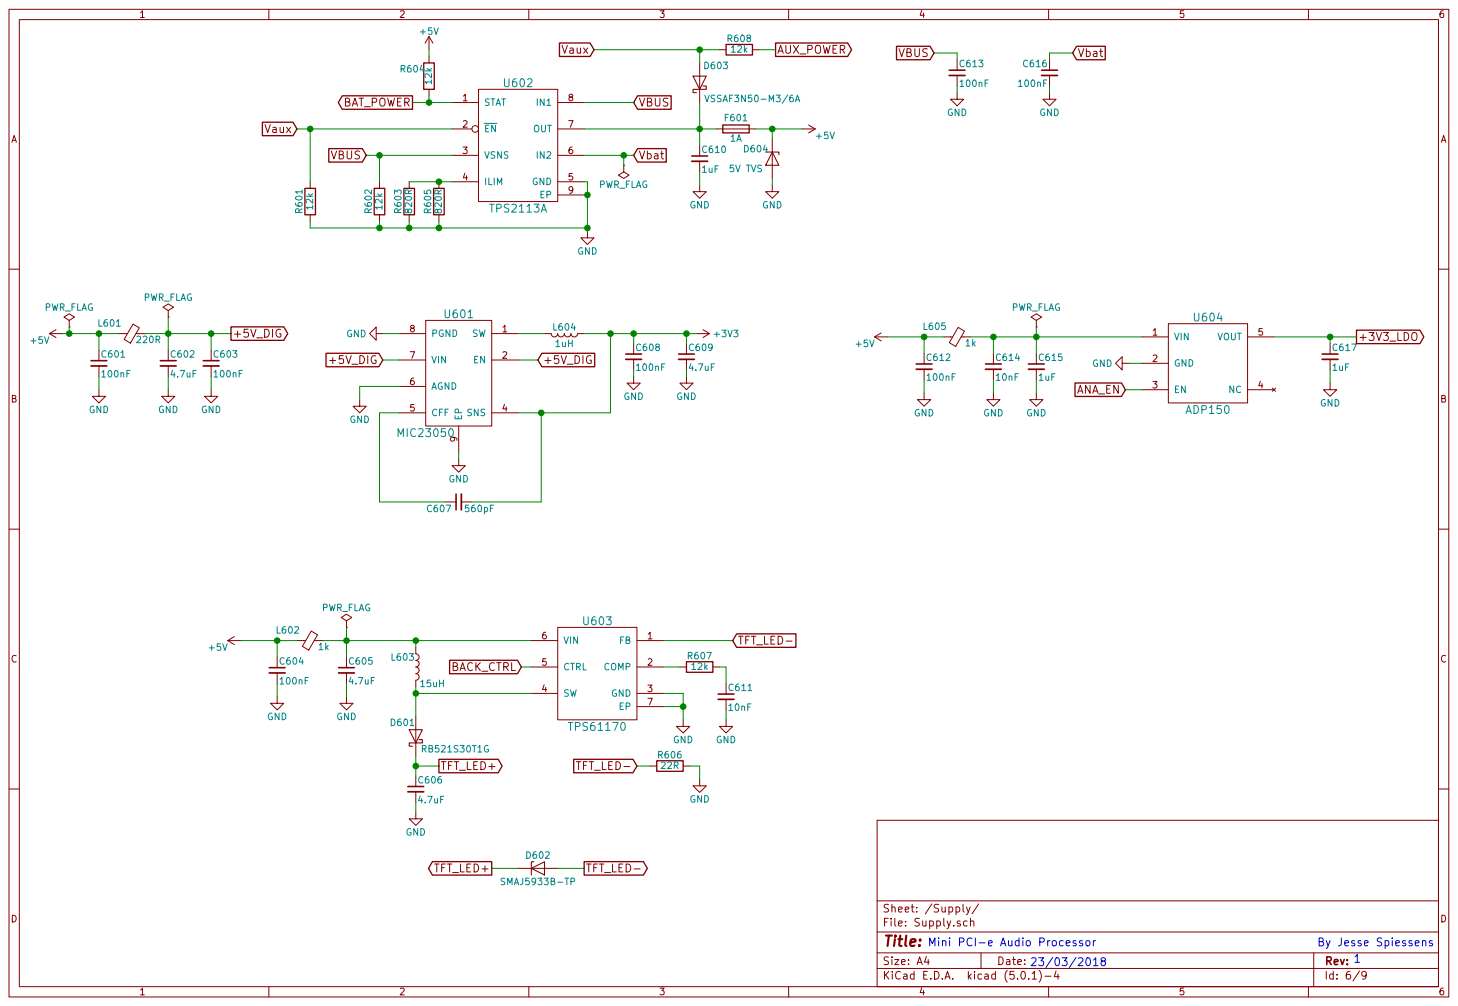
[picture p66: page 6]

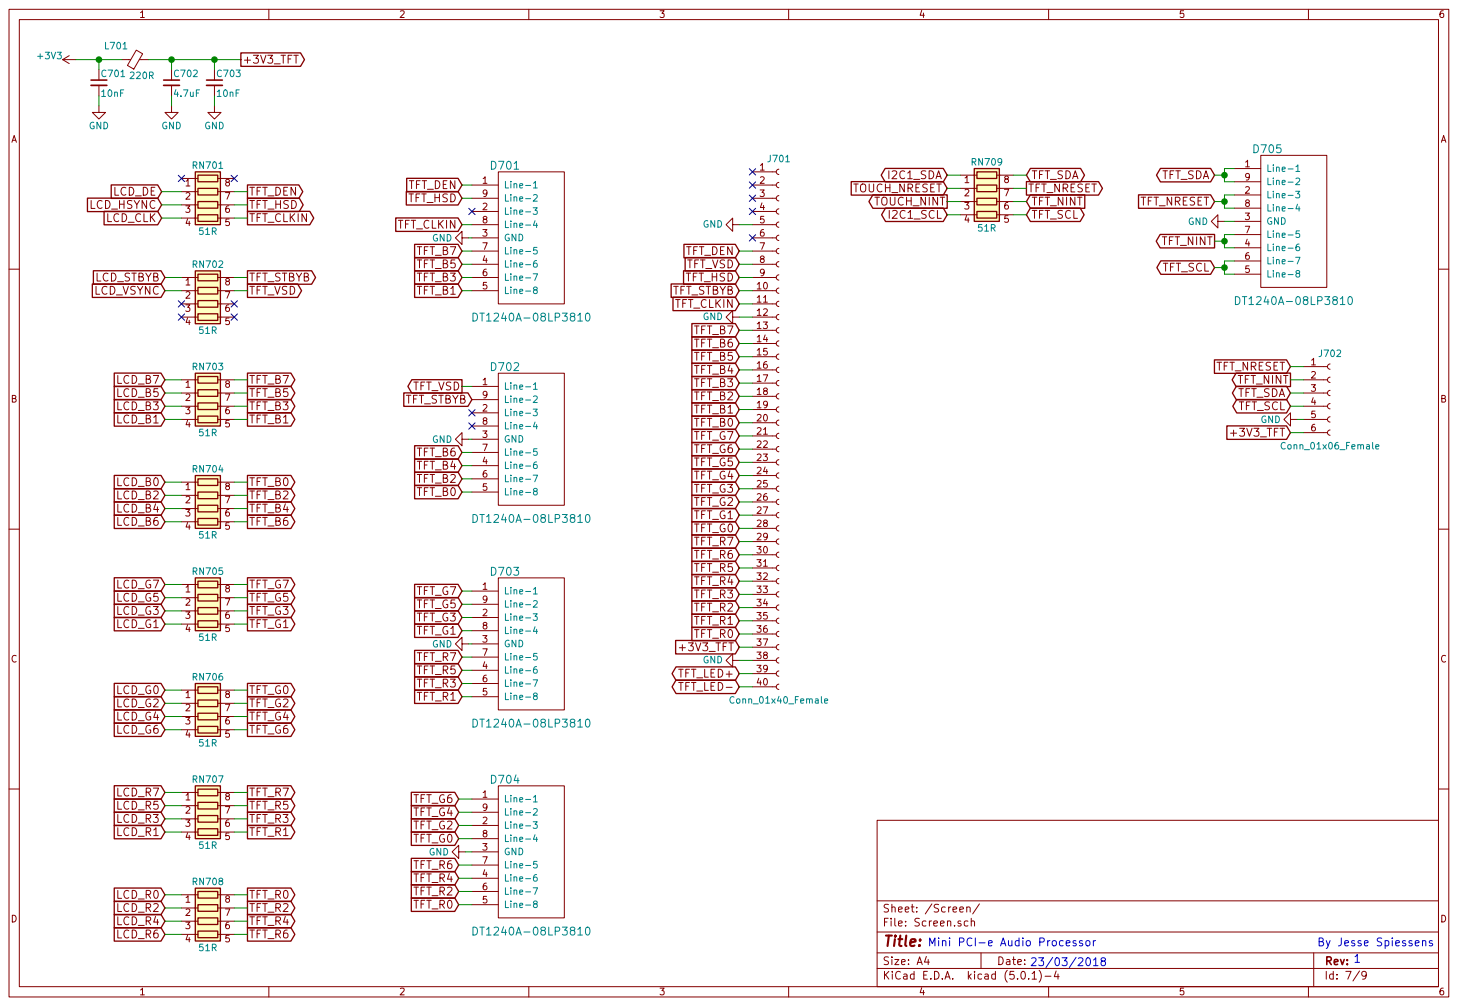
[picture p67: page 7]

Id: 7/9 Title: File: Screen.sch Sheet: /Screen/ 123456789

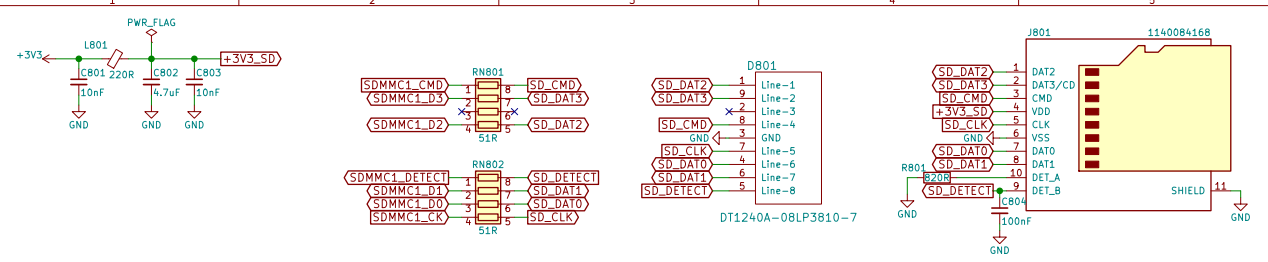
[picture p68: page 8]

Id: 8/9 Title: File: SD.sch Sheet: /SD/

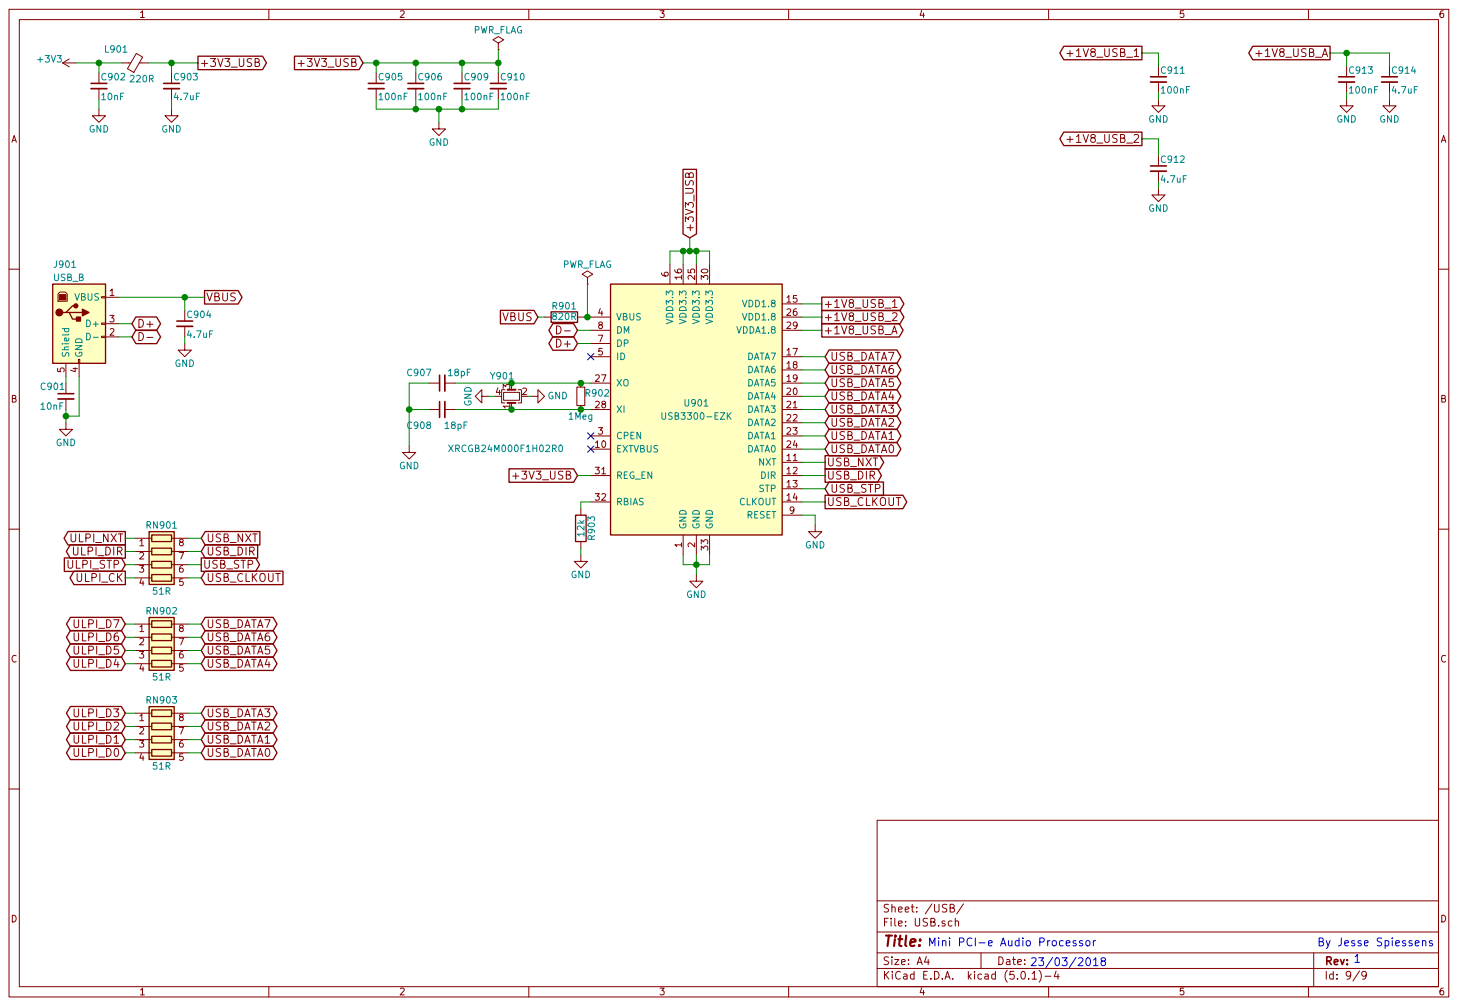
[picture p69: page 9]

6 DP 7 DM 8 RESET 9 EXTVBUS 10 DATA4 20 VDD3.3 30 NXT 11 DATA3 21 REG_EN 31 DIR 12 DATA2 22 RBIAS 32 STP 13 DATA1 23 GND 33 CLKOUT 14 DATA0 24 VDD1.8 15 VDD3.3 25 VDD3.3 16 VDD1.8 26 DATA7 17 XO 27 DATA6 18 XI 28 DATA5 19 VDDA1.8 29 U901 USB3300-EZK

Id: 9/9 Title: File: USB.sch Sheet: /USB/ GND
