Tyrsz/Audio_Processor/PCB/IO board/Audio board.pdf

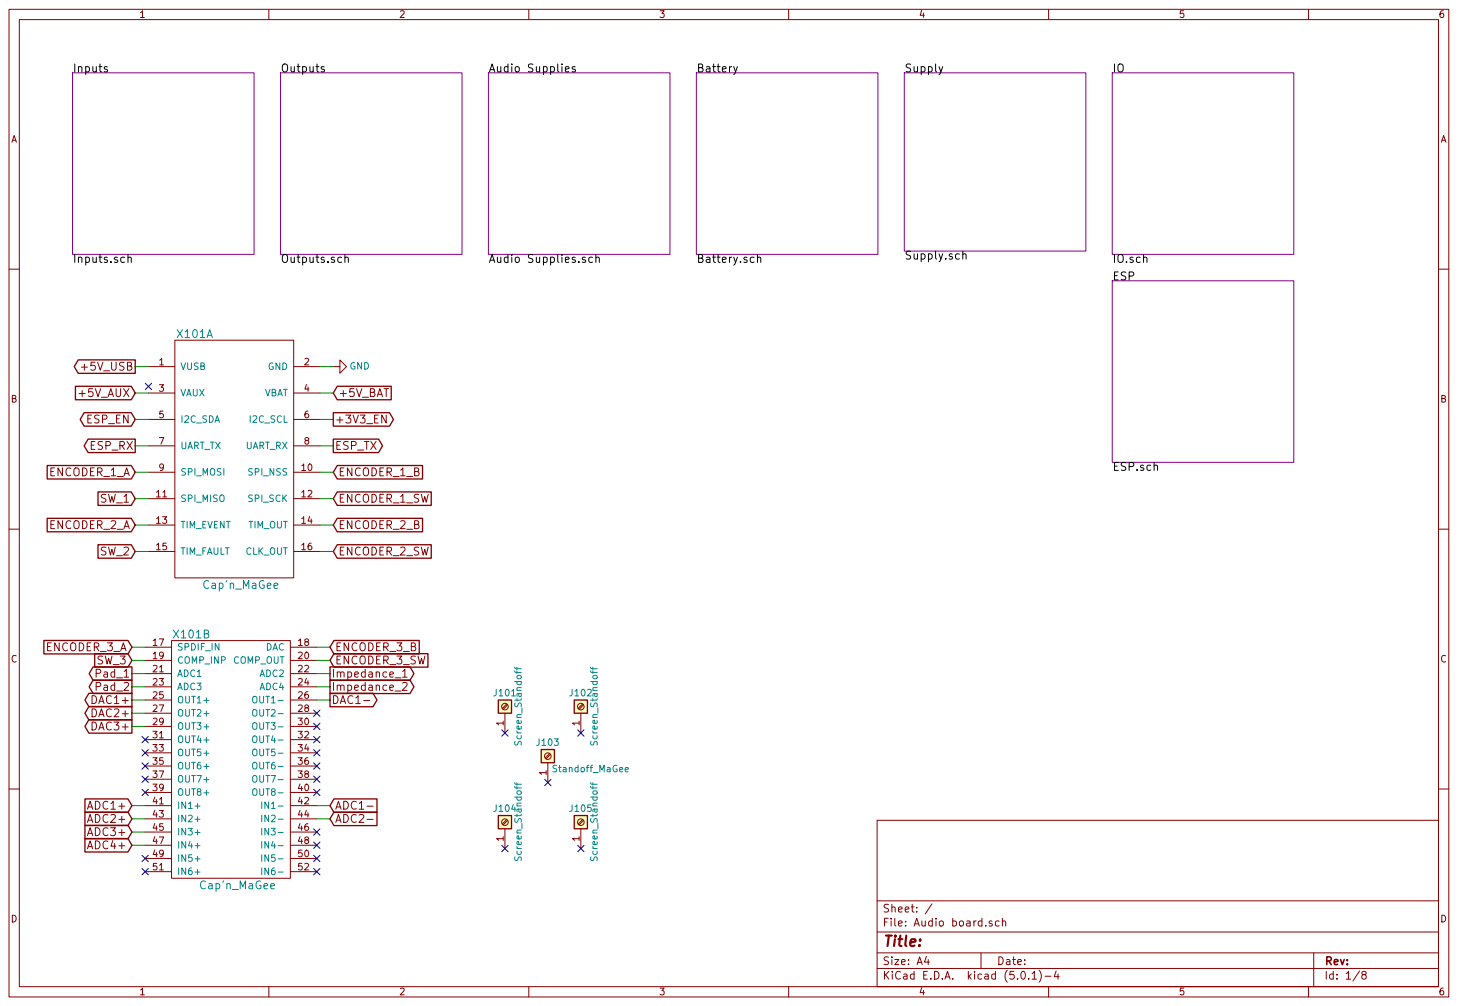
[picture p70: page 1]

Id: 1/8 Title: File: Audio board.sch Sheet: /

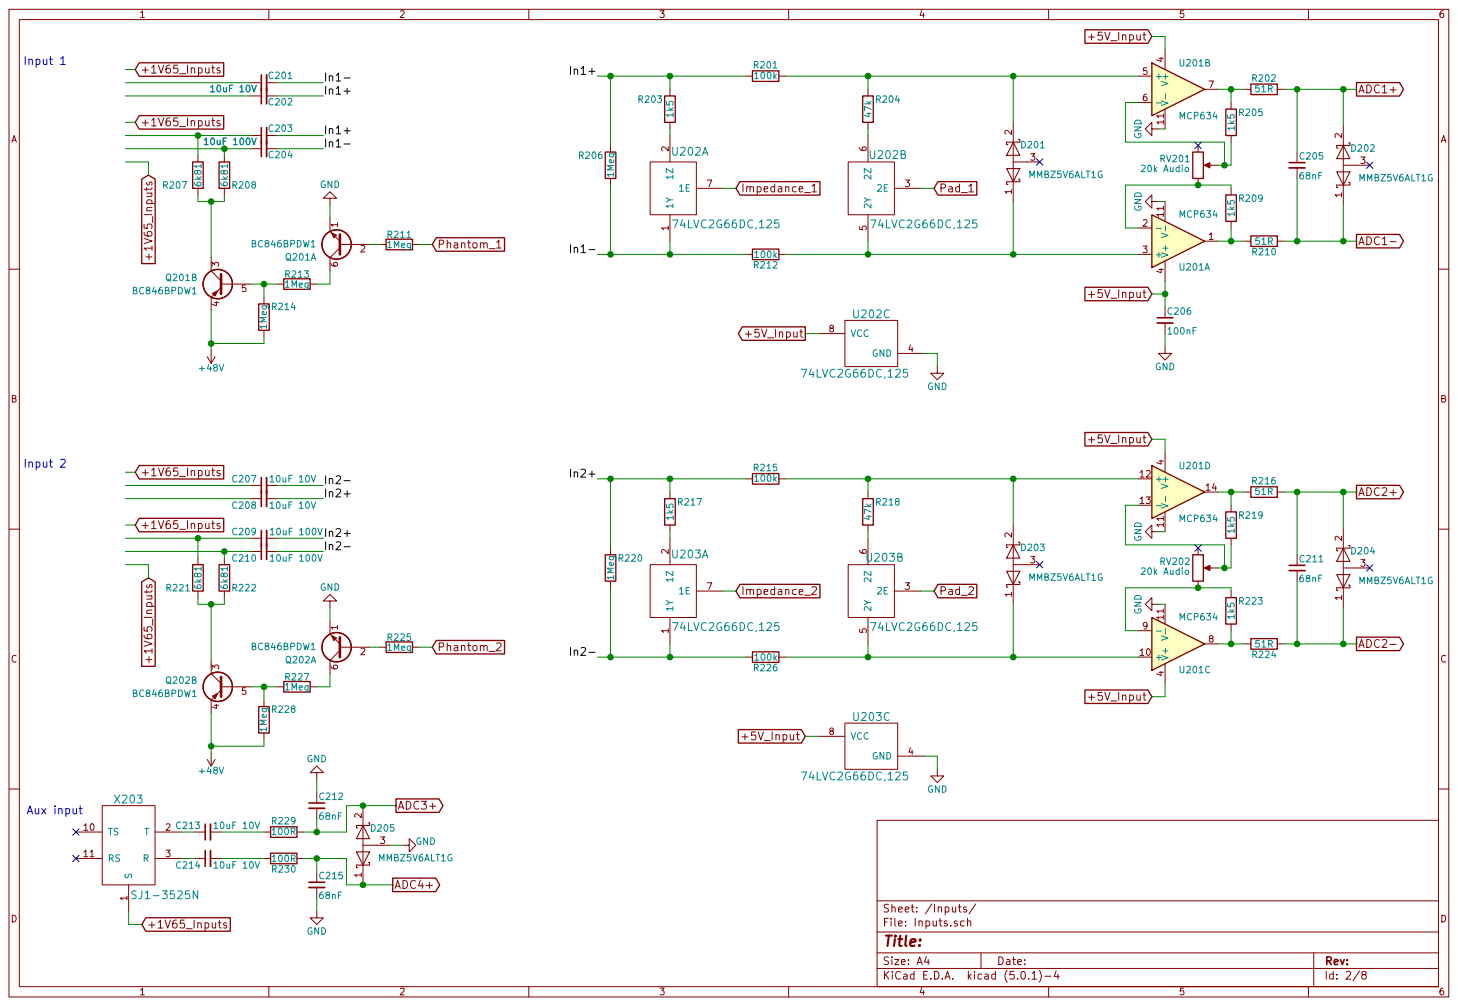
[picture p71: page 2]

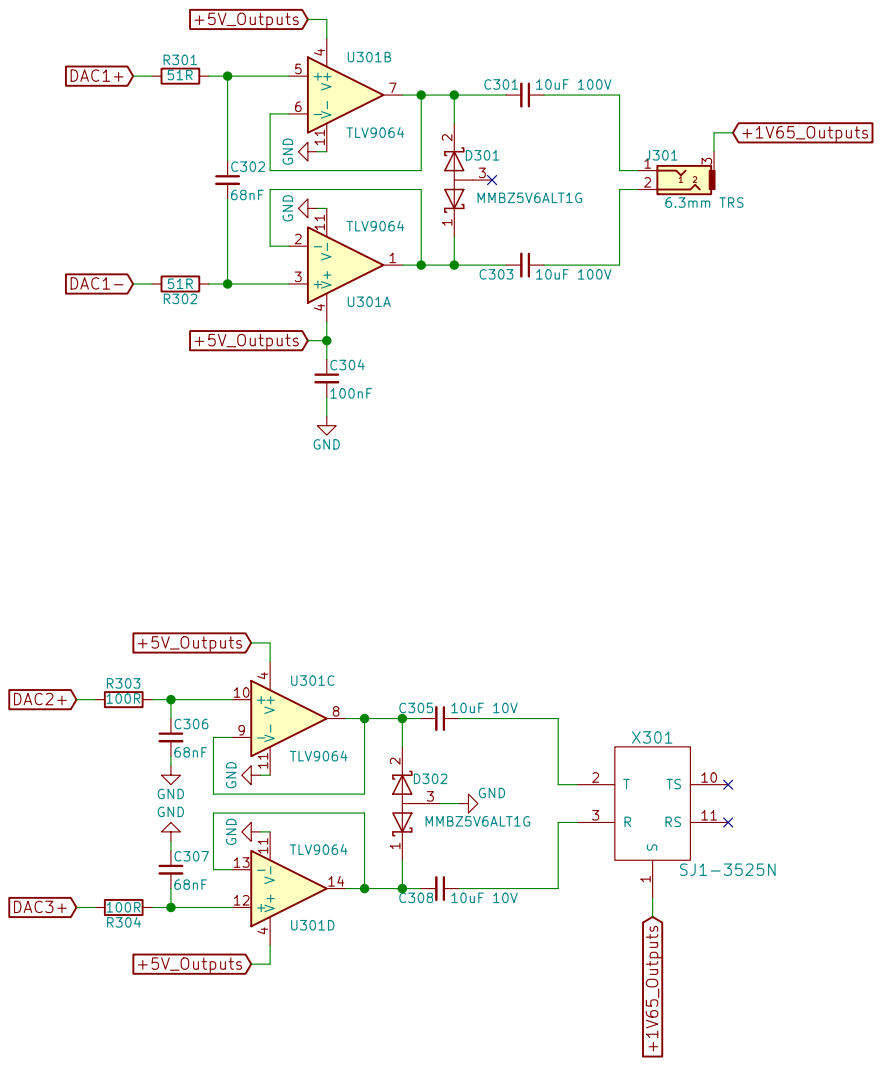
[picture p72: page 3]

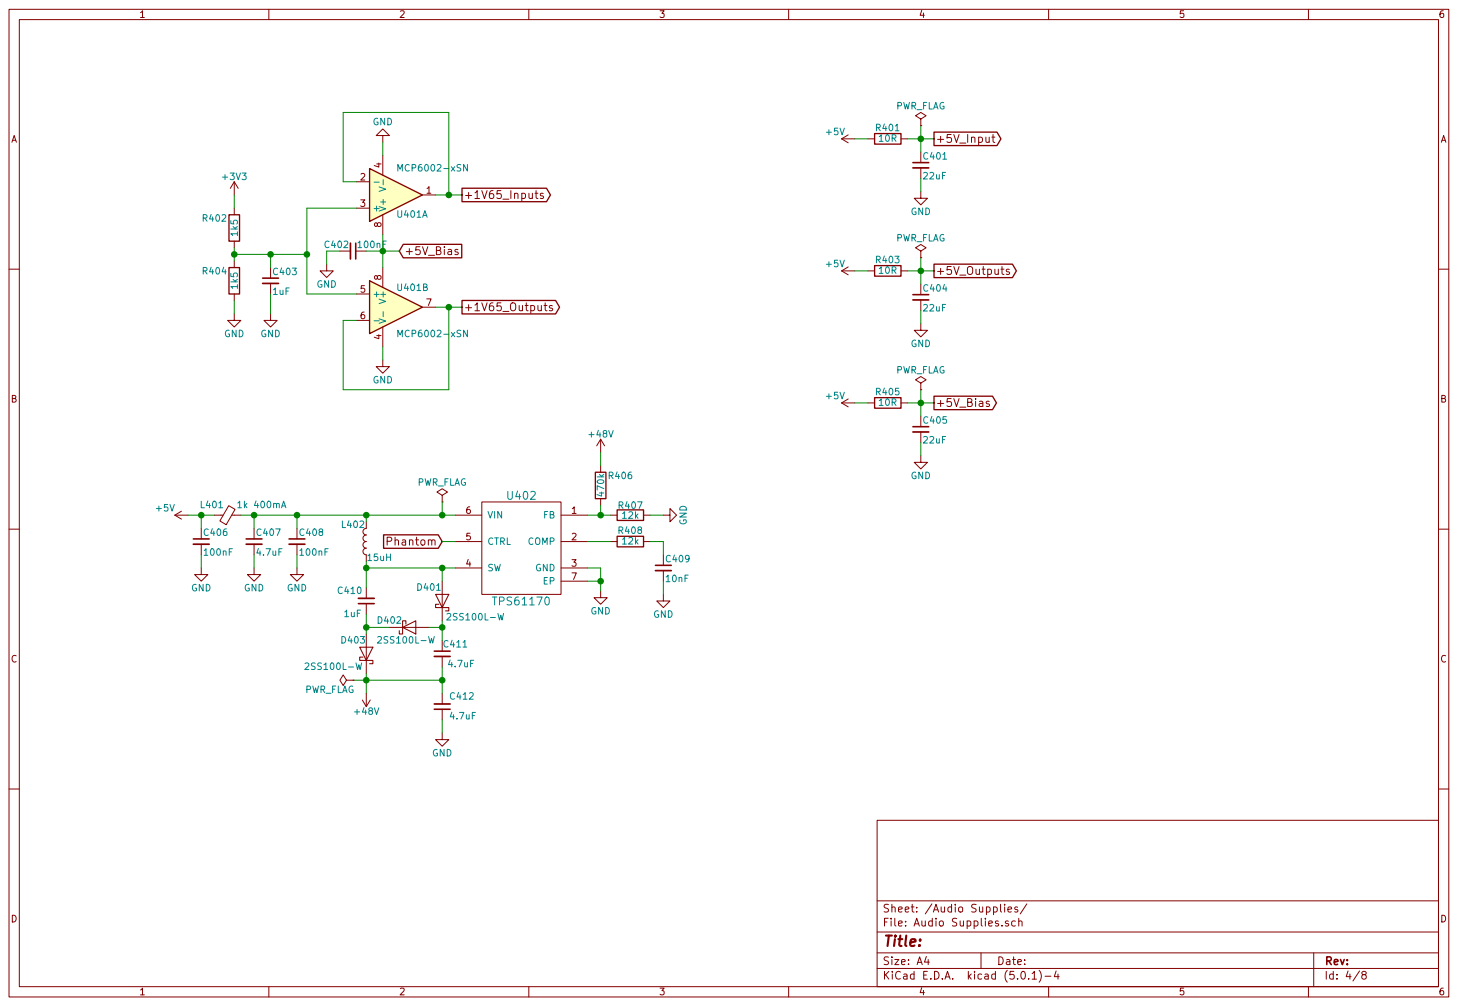
[picture p73: page 4]

File: Audio Supplies.sch
Id: 4/8 Title:

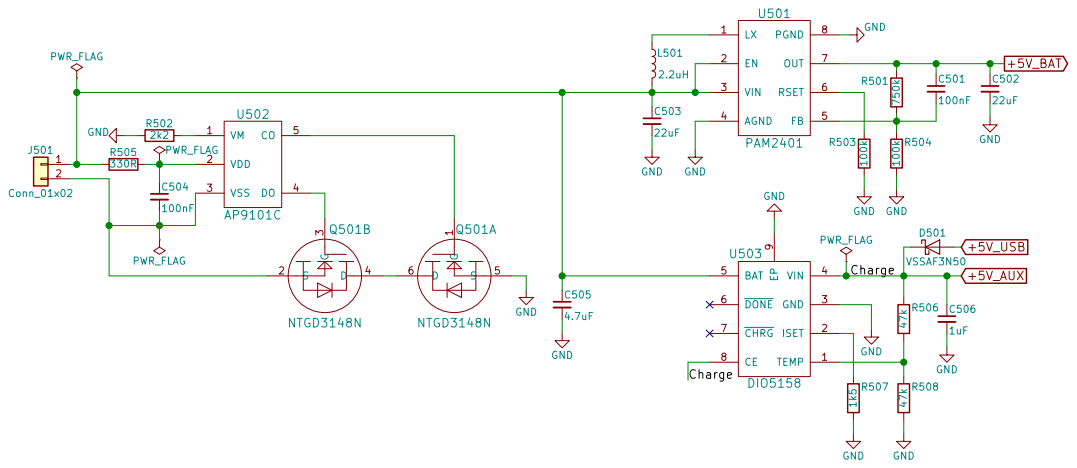
[picture p74: page 5]

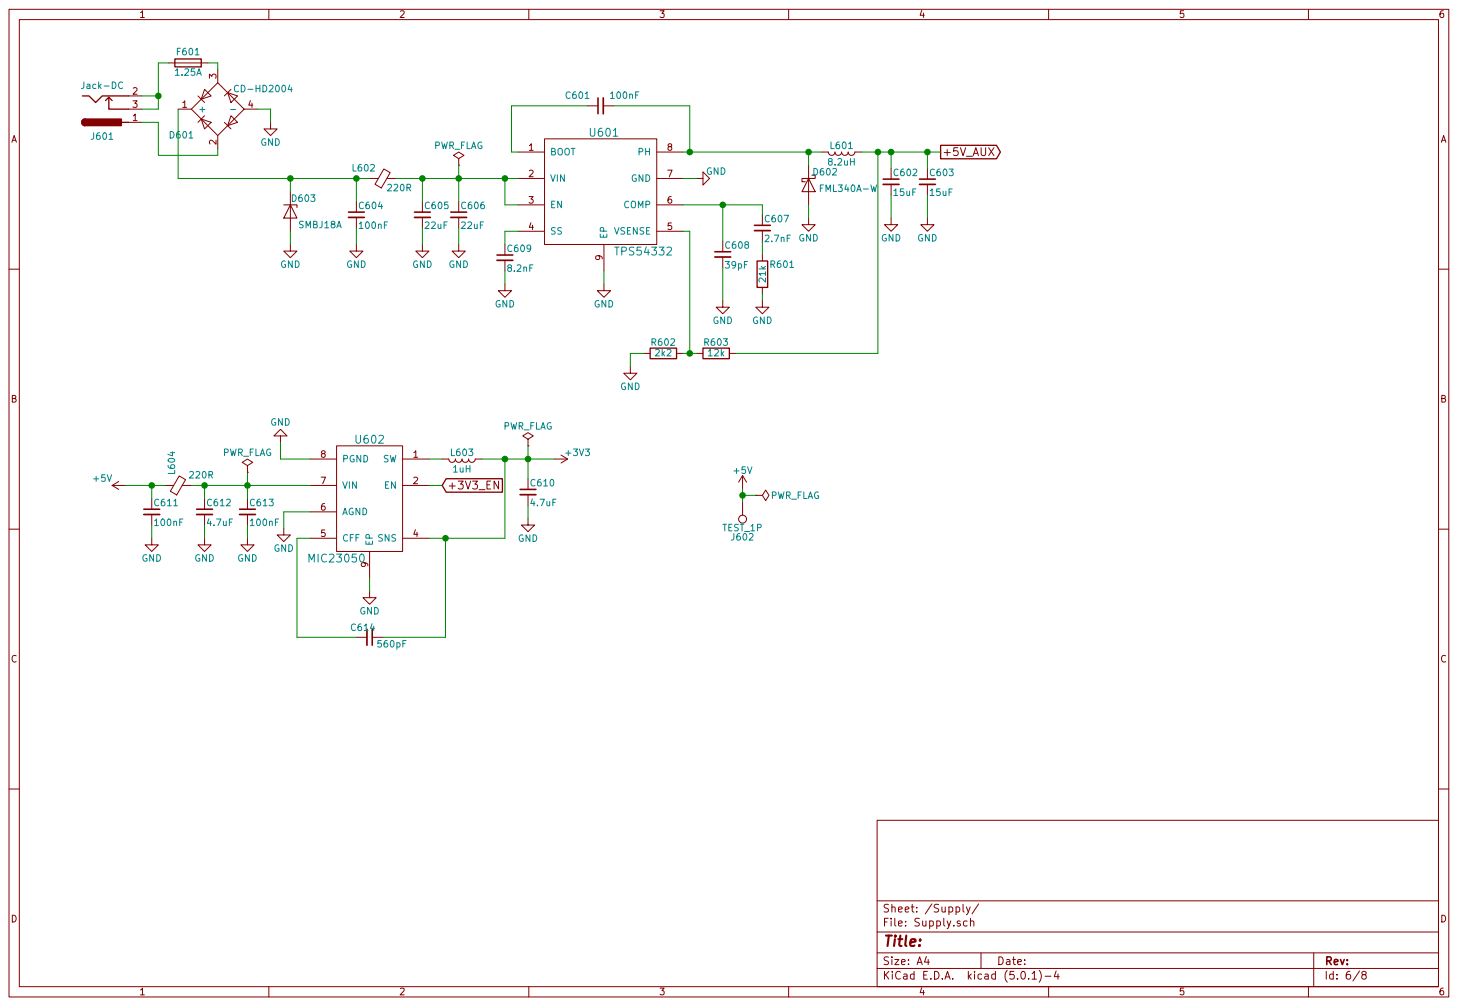
[picture p75: page 6]

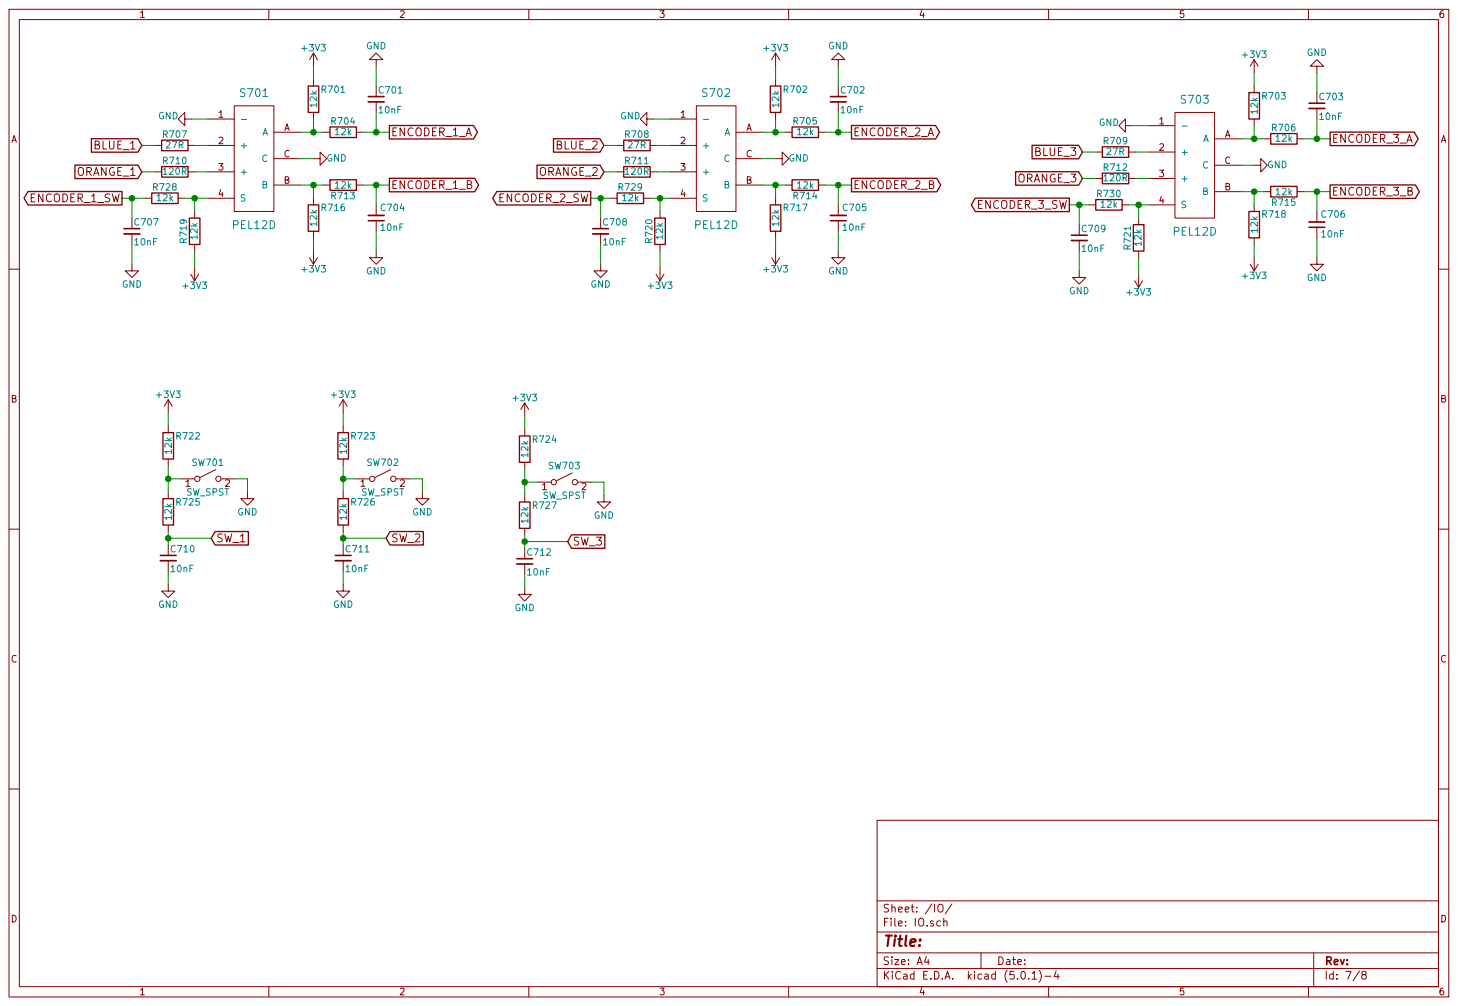
[picture p76: page 7]

Id: 7/8 Title: File: IO.sch Sheet: /IO/

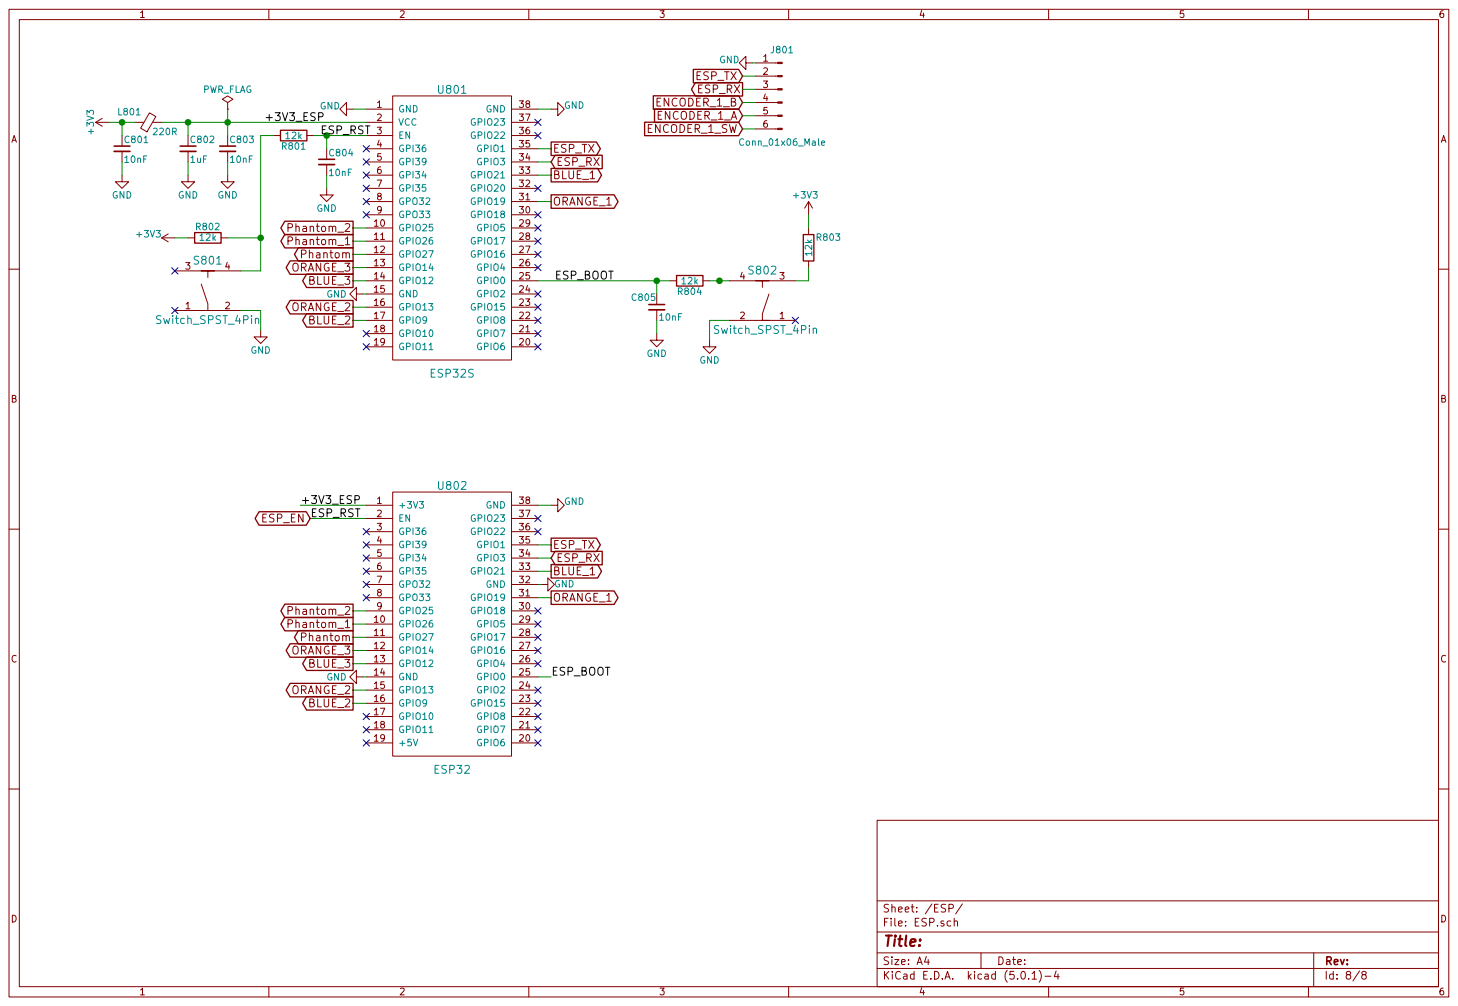
[picture p77: page 8]

Id: 8/8 Title: File: ESP.sch Sheet: /ESP/
