Tyrsz/Audio_Processor/PCB/DSP board/Schematic.pdf

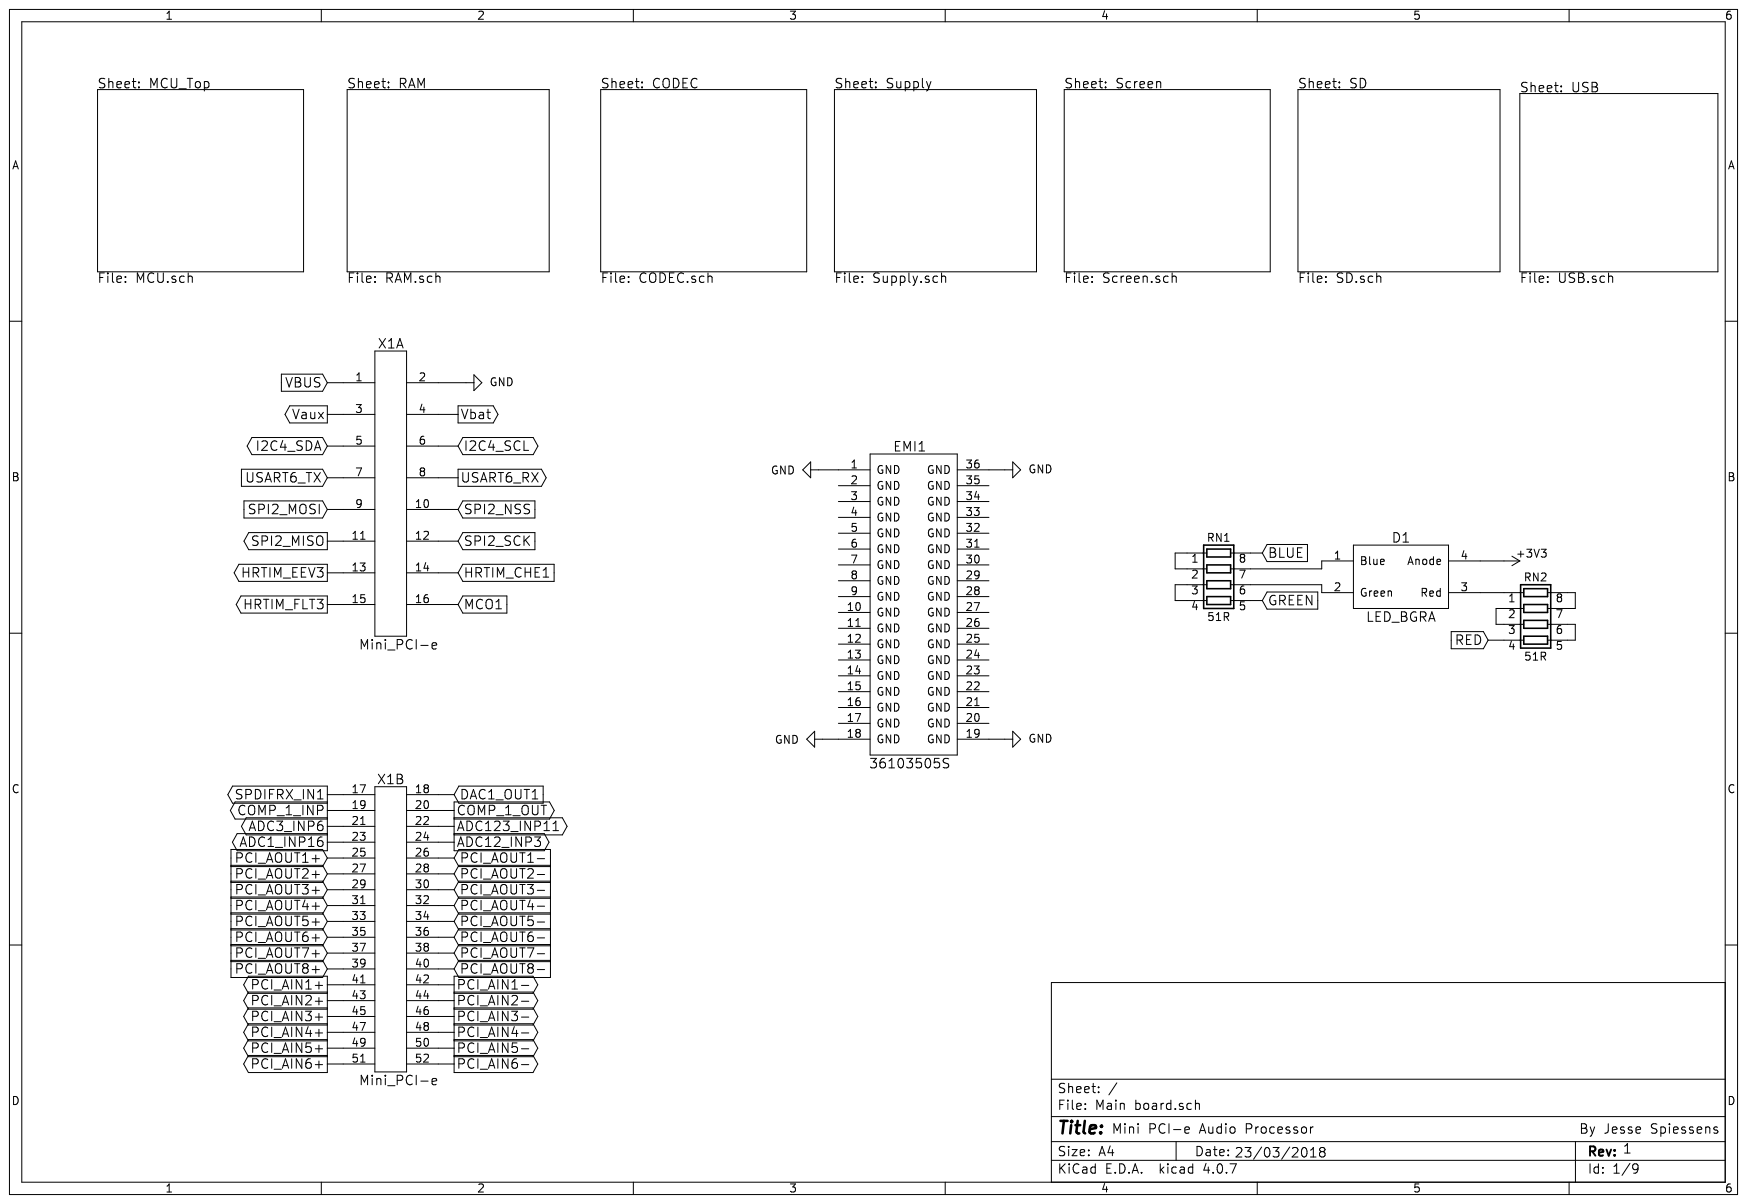
[picture p85: page 1]

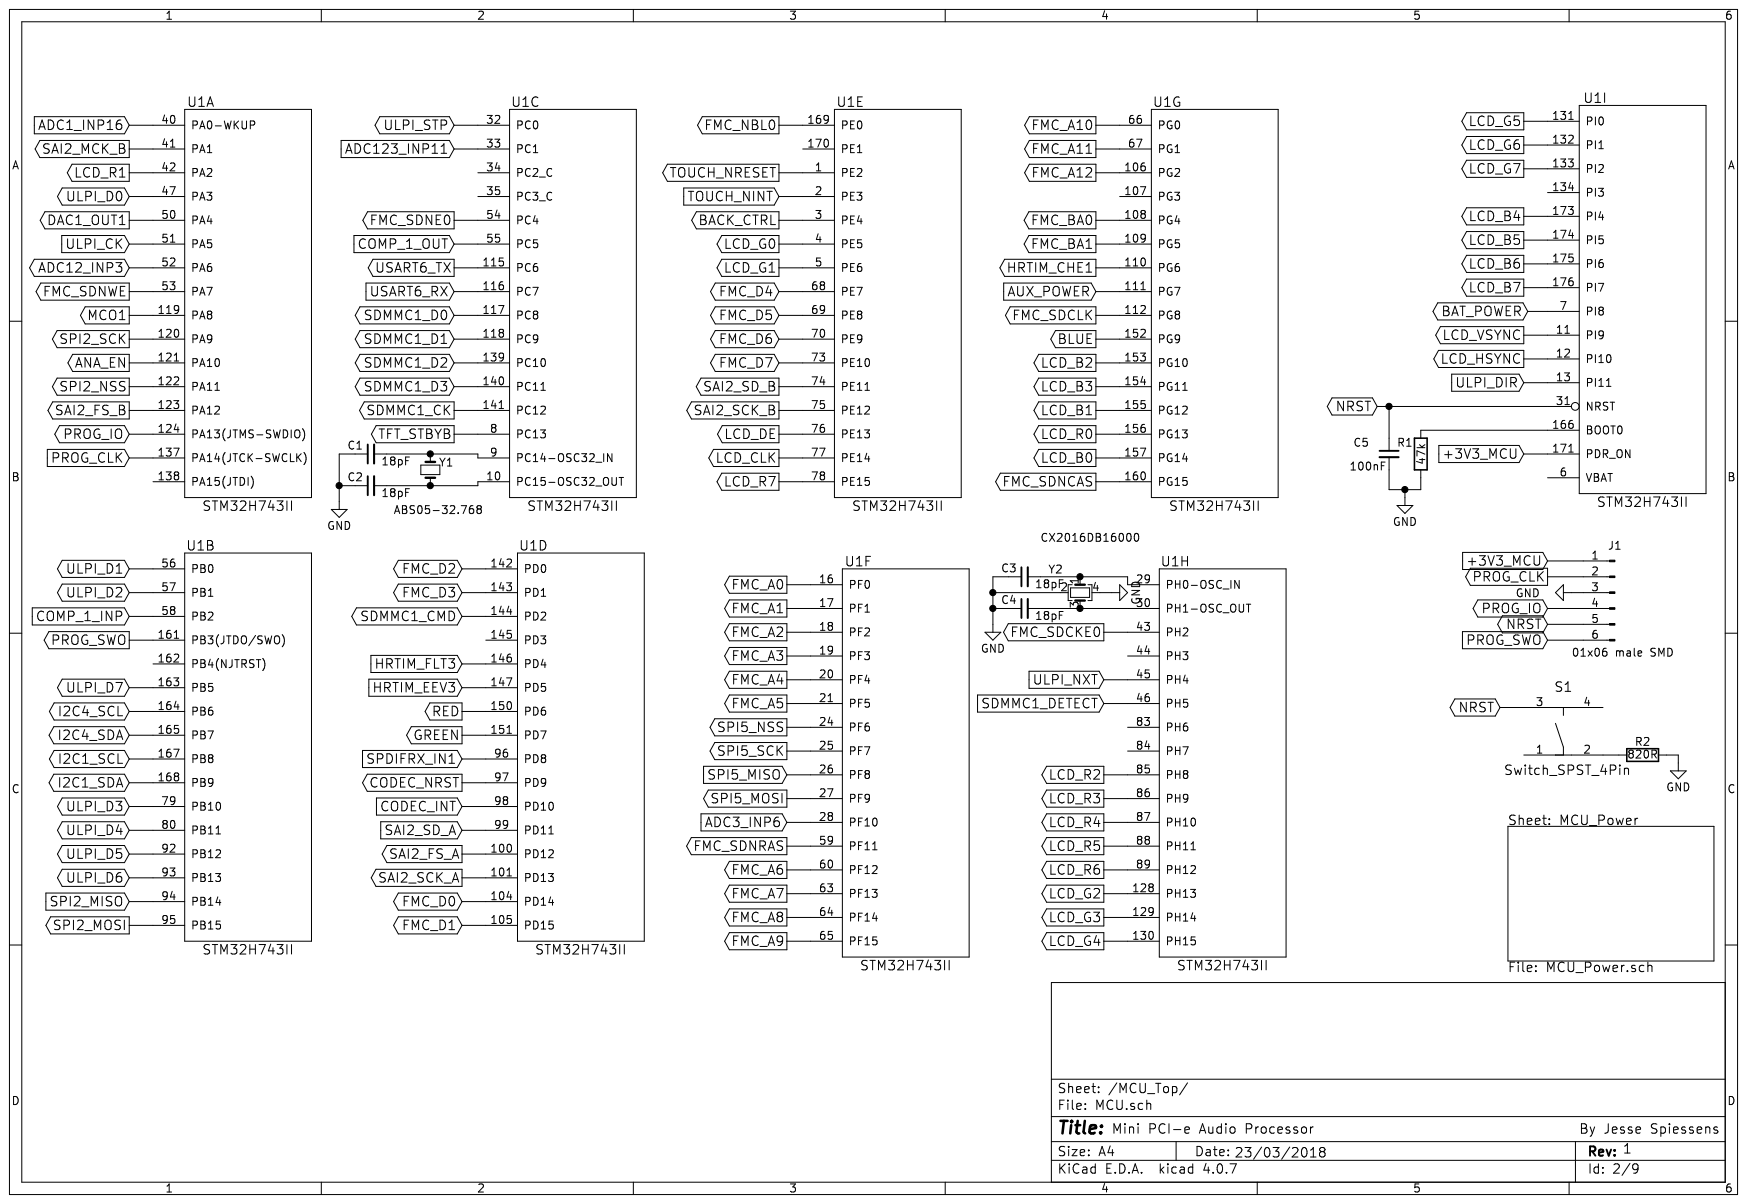
[picture p86: page 2]

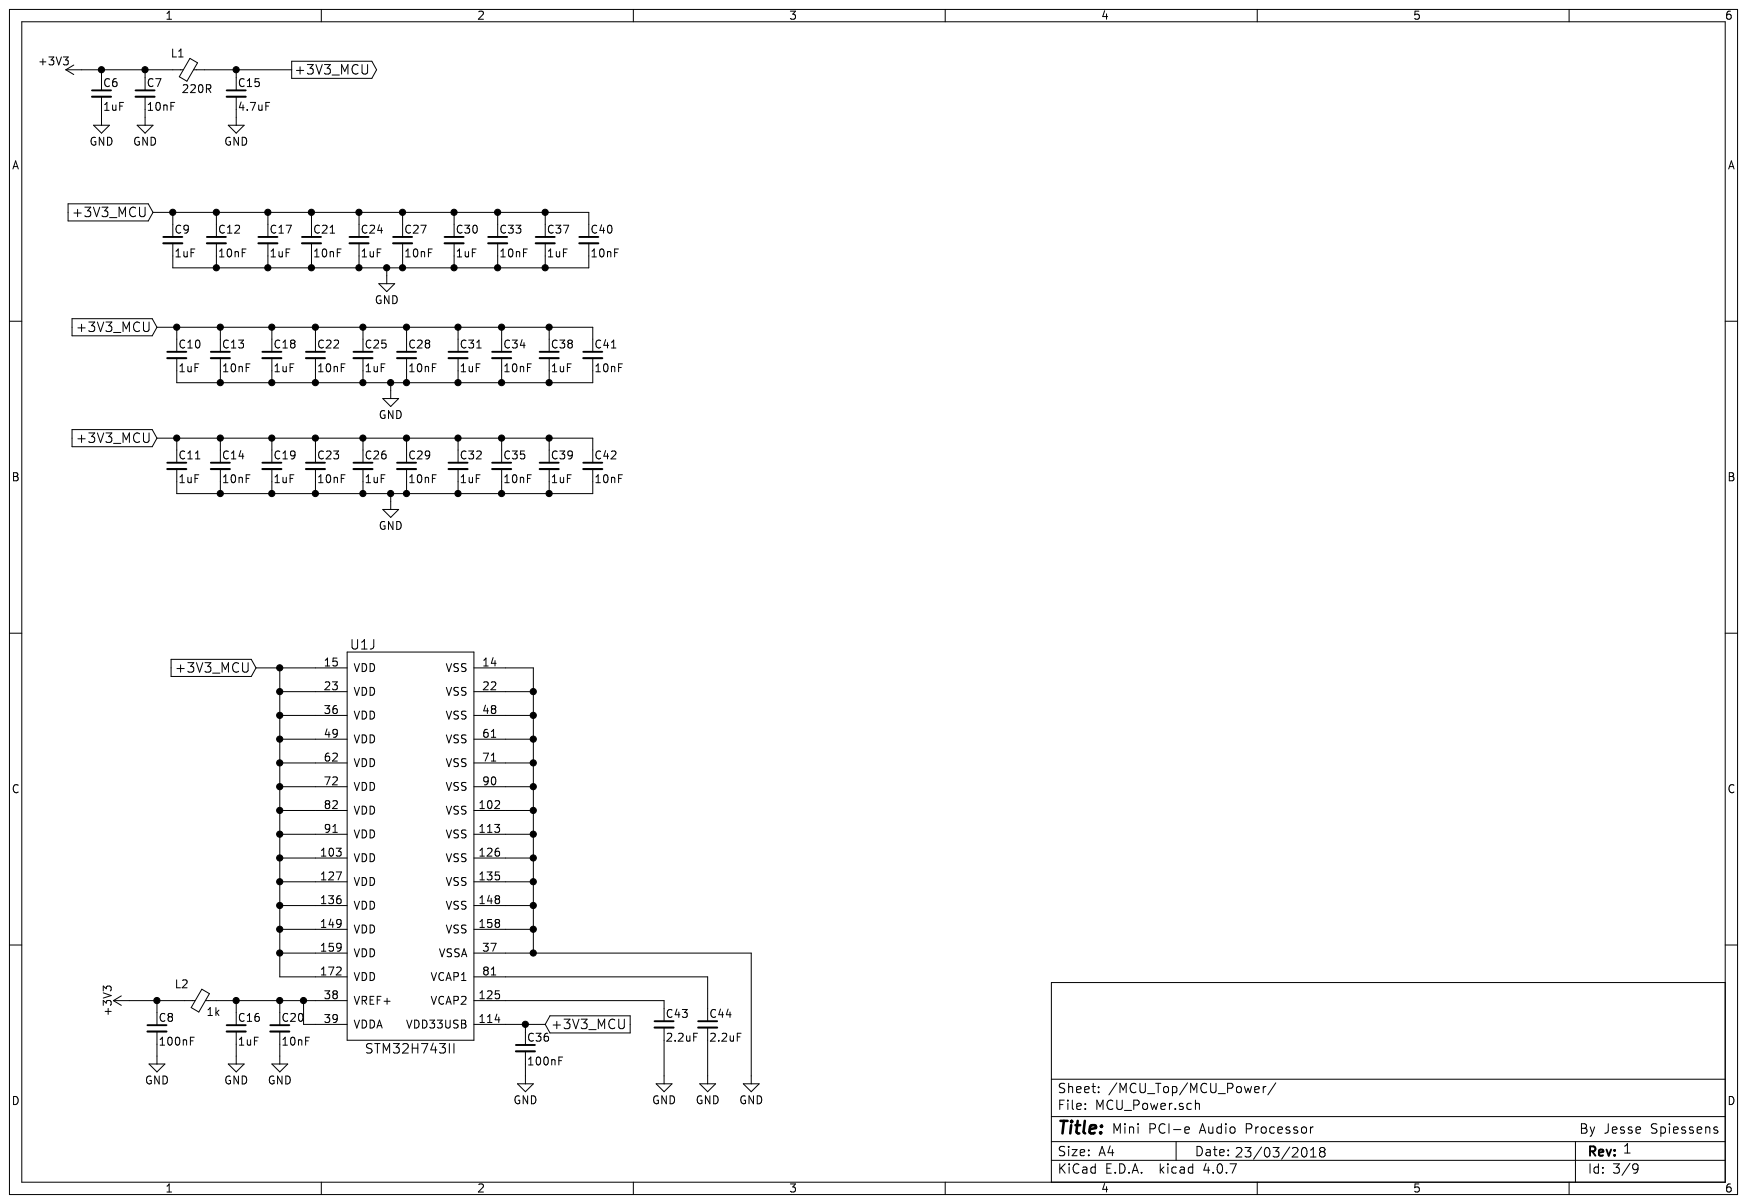
[picture p87: page 3]

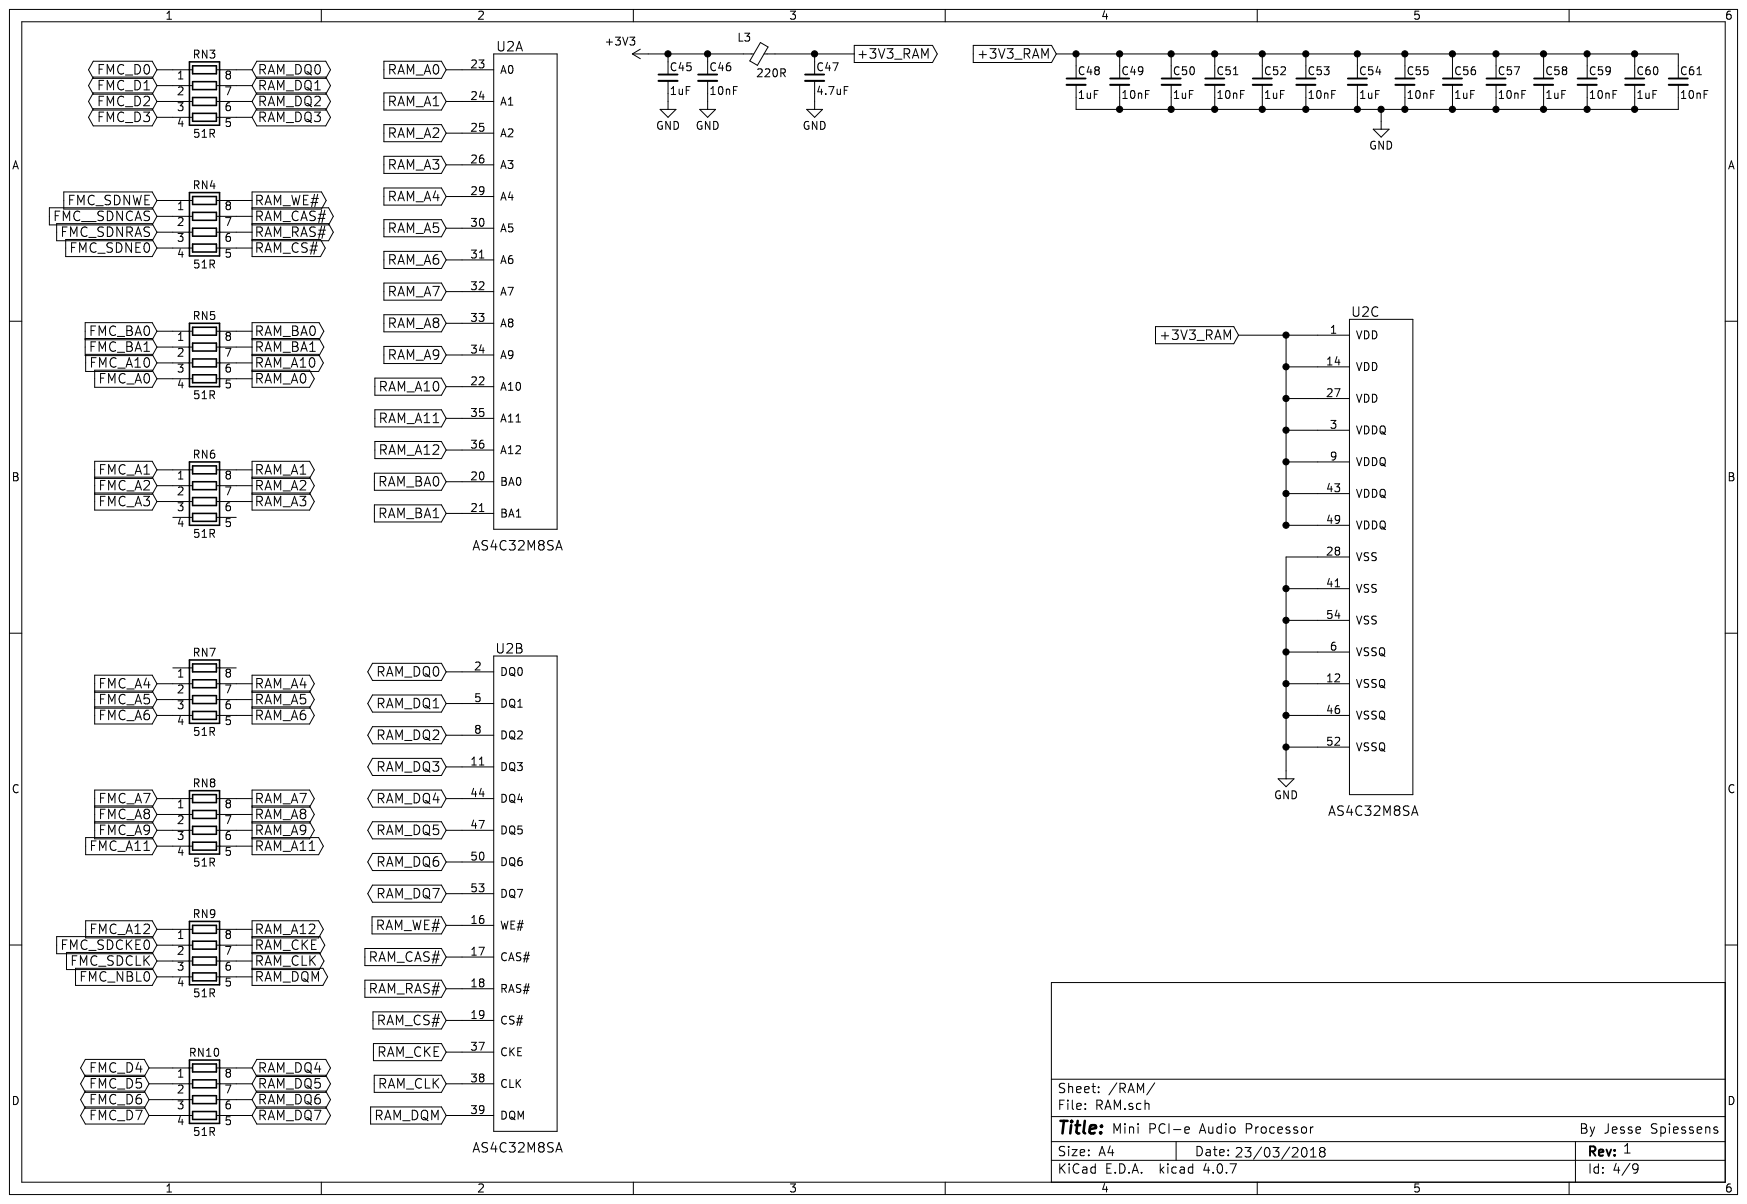
[picture p88: page 4]

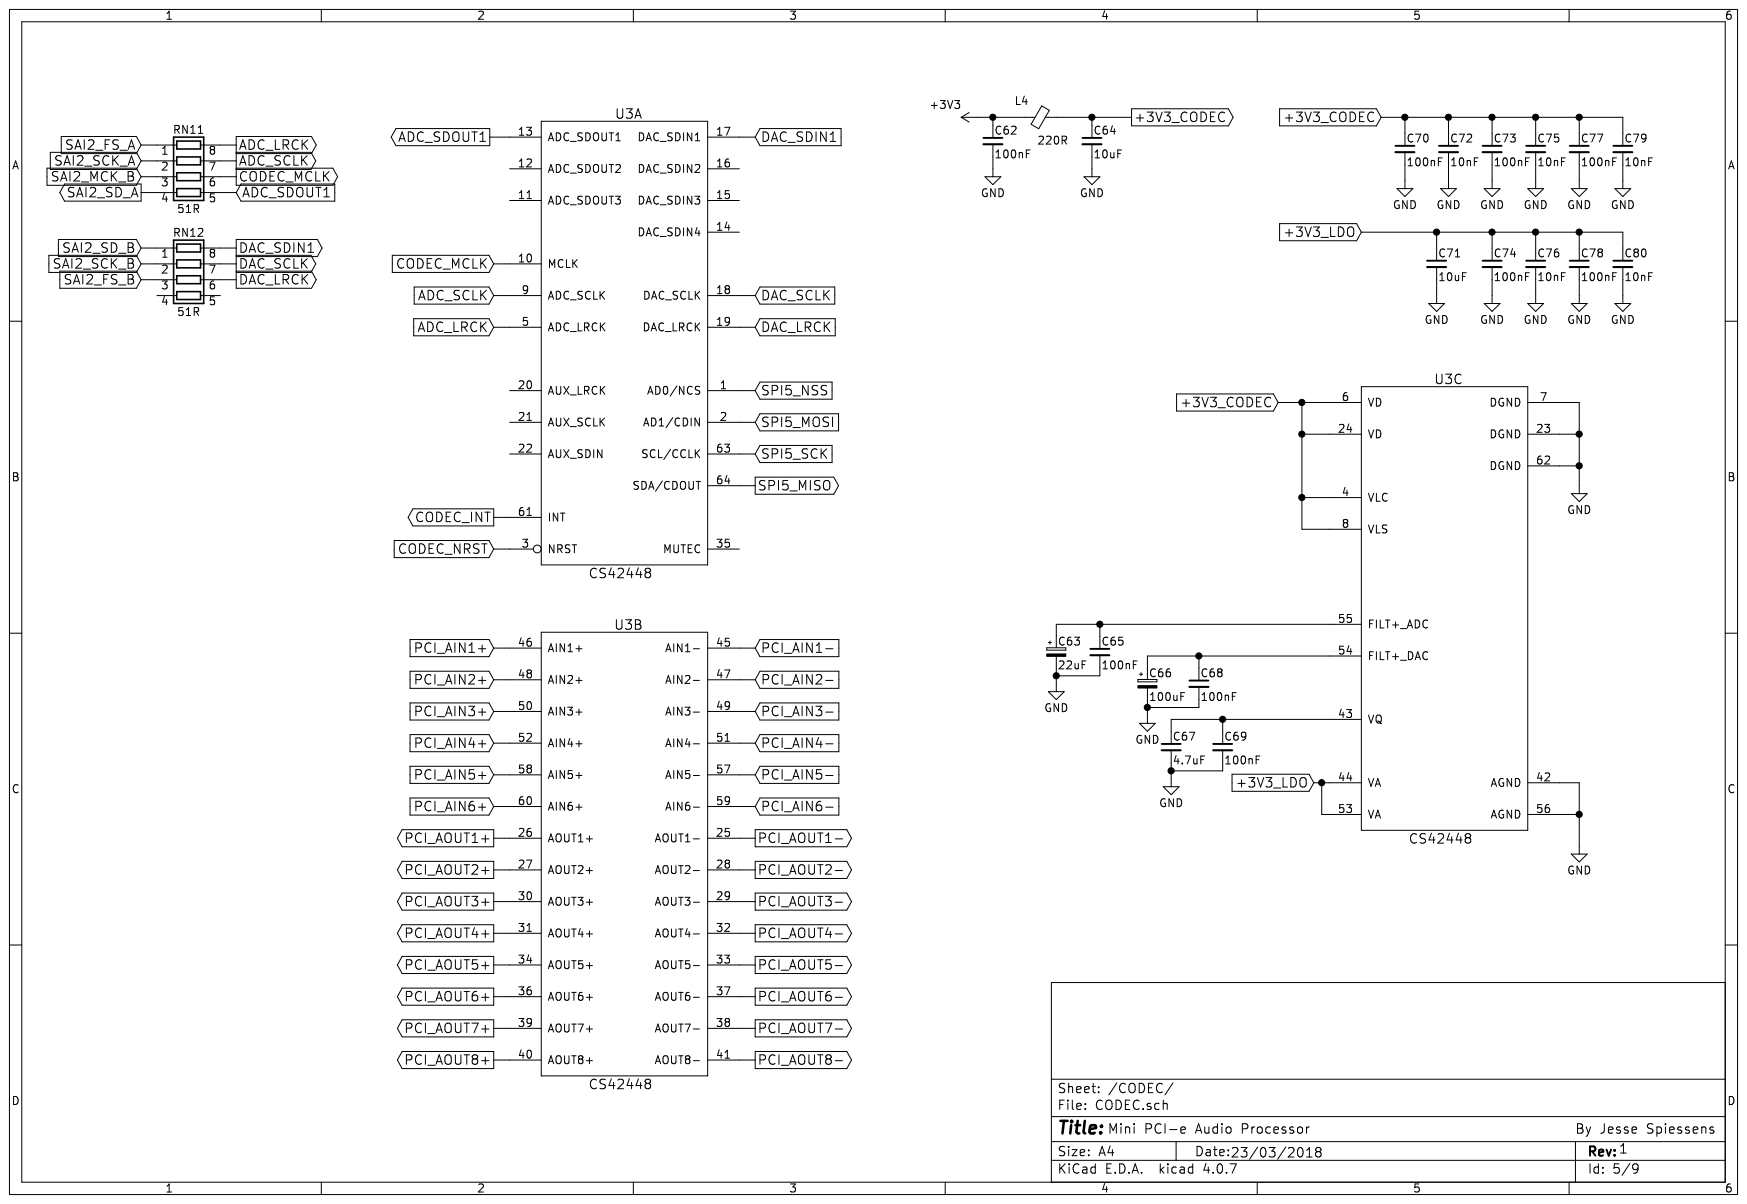
[picture p89: page 5]

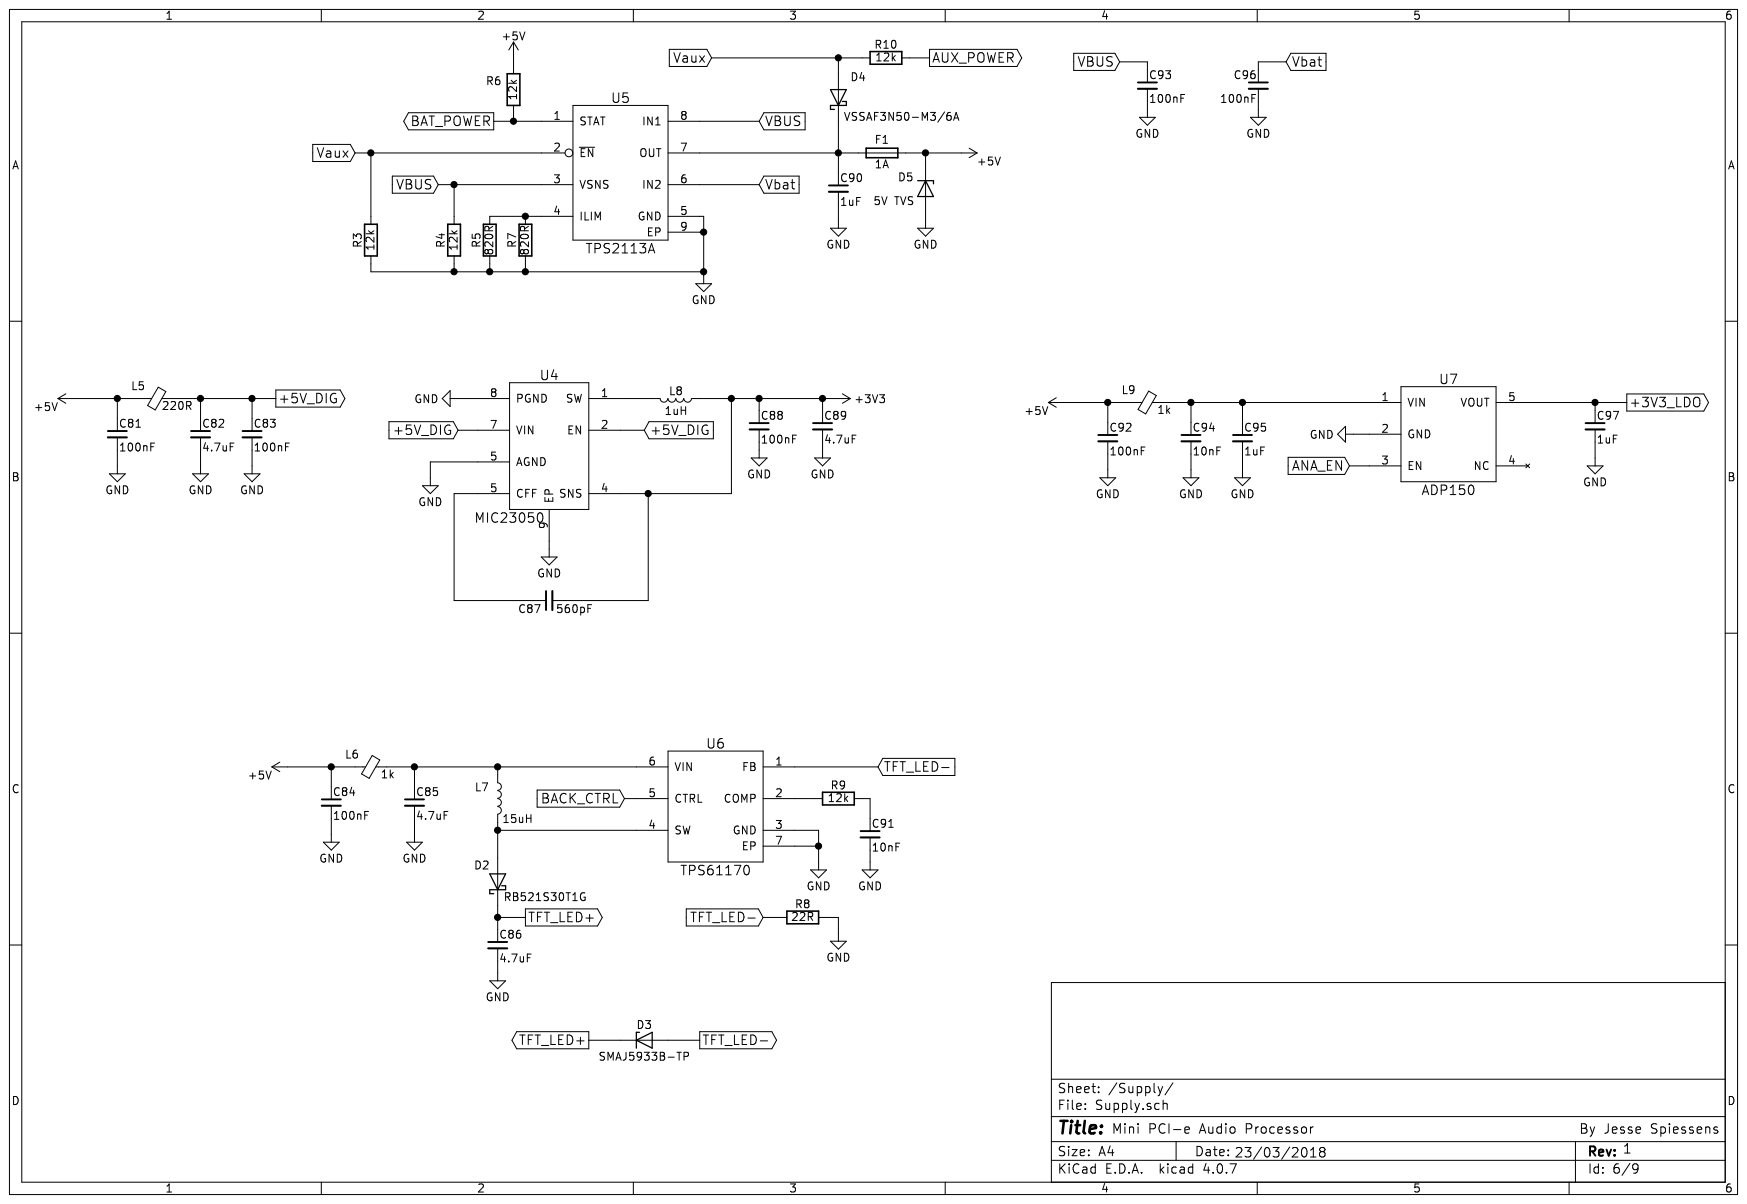
[picture p90: page 6]

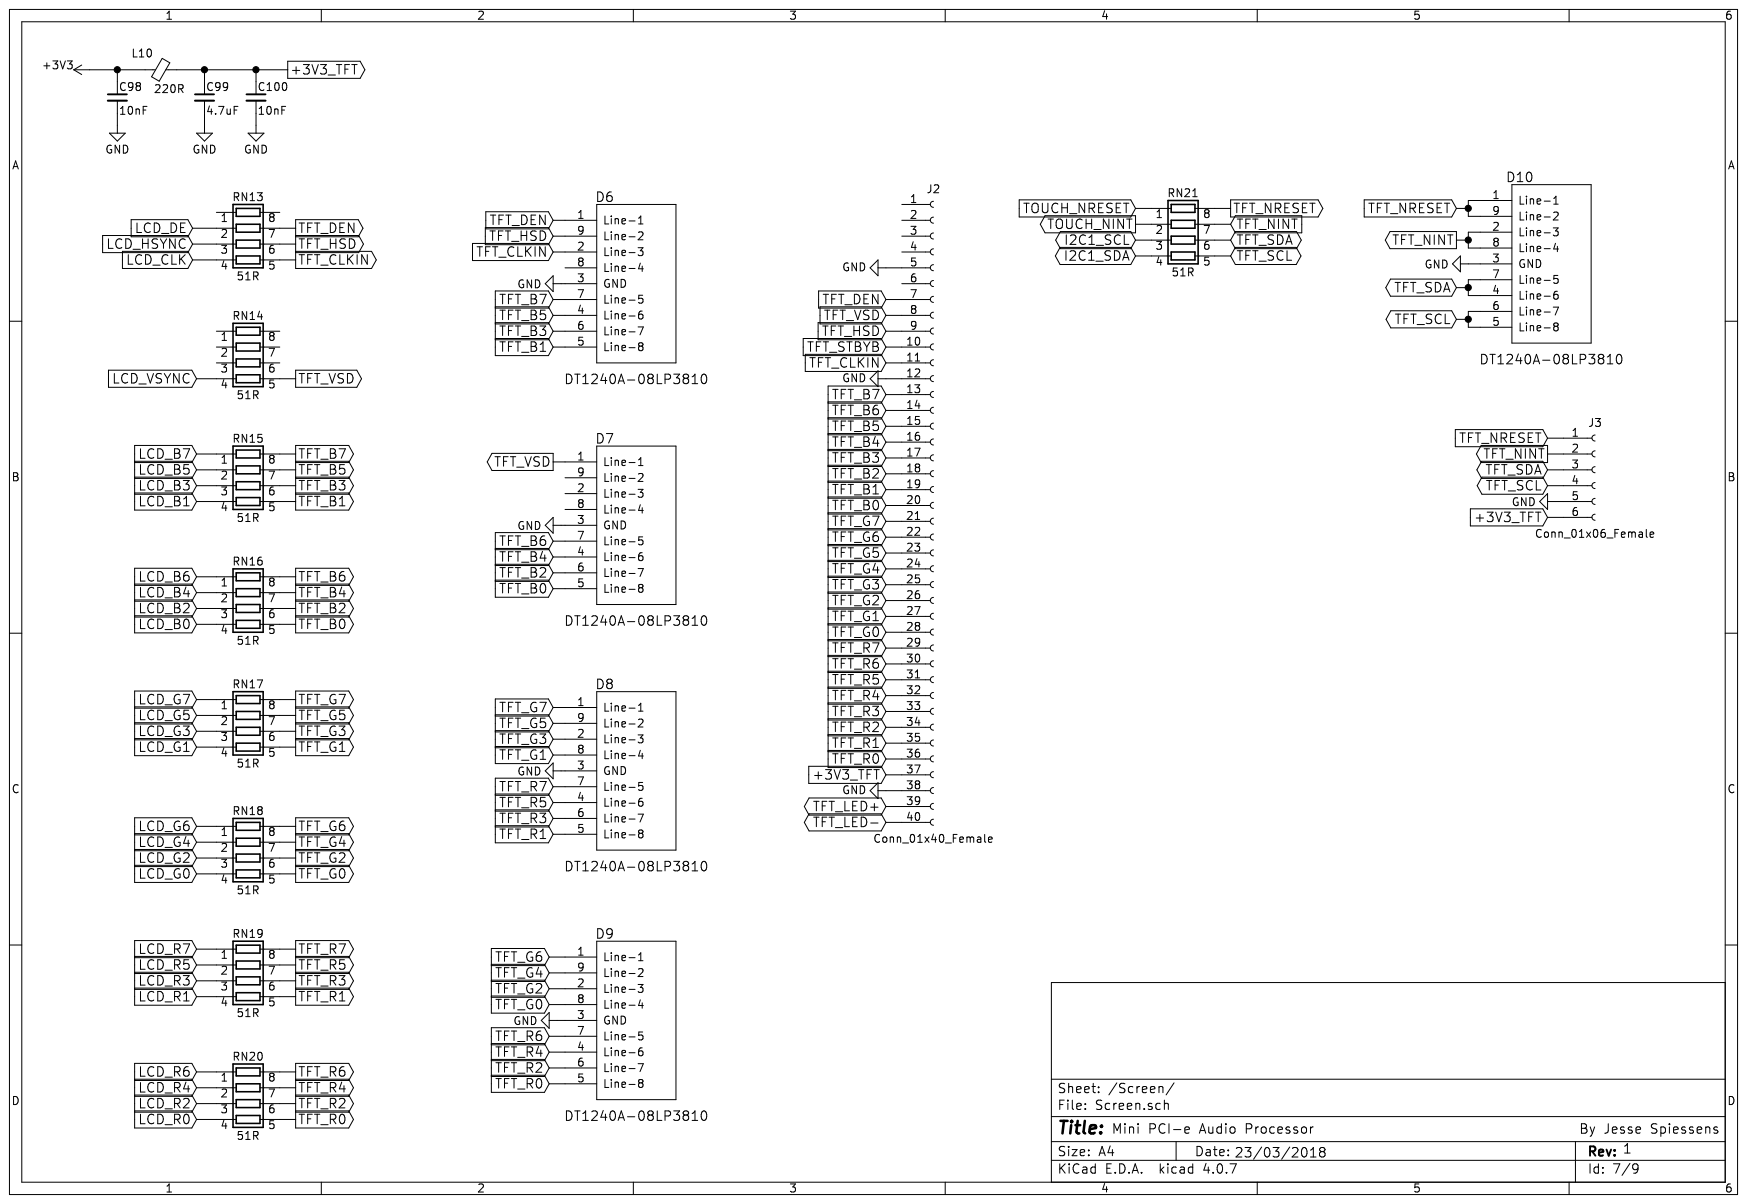
[picture p91: page 7]

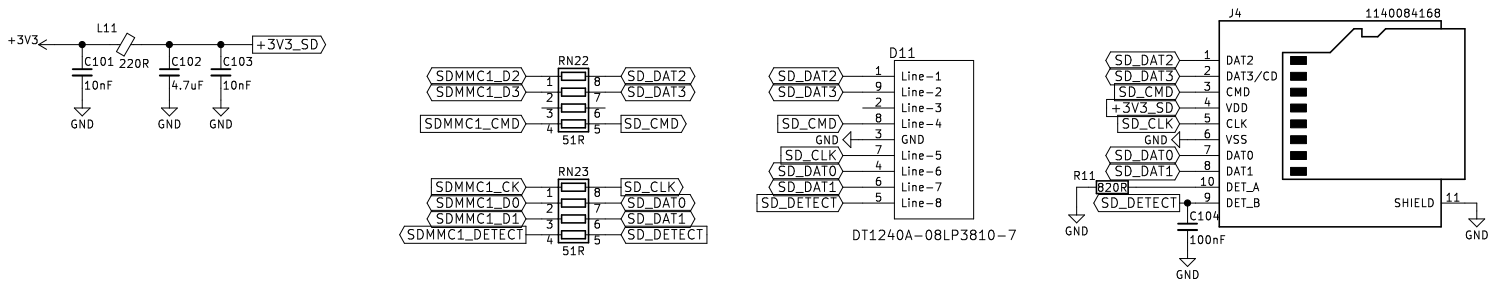
[picture p92: page 8]

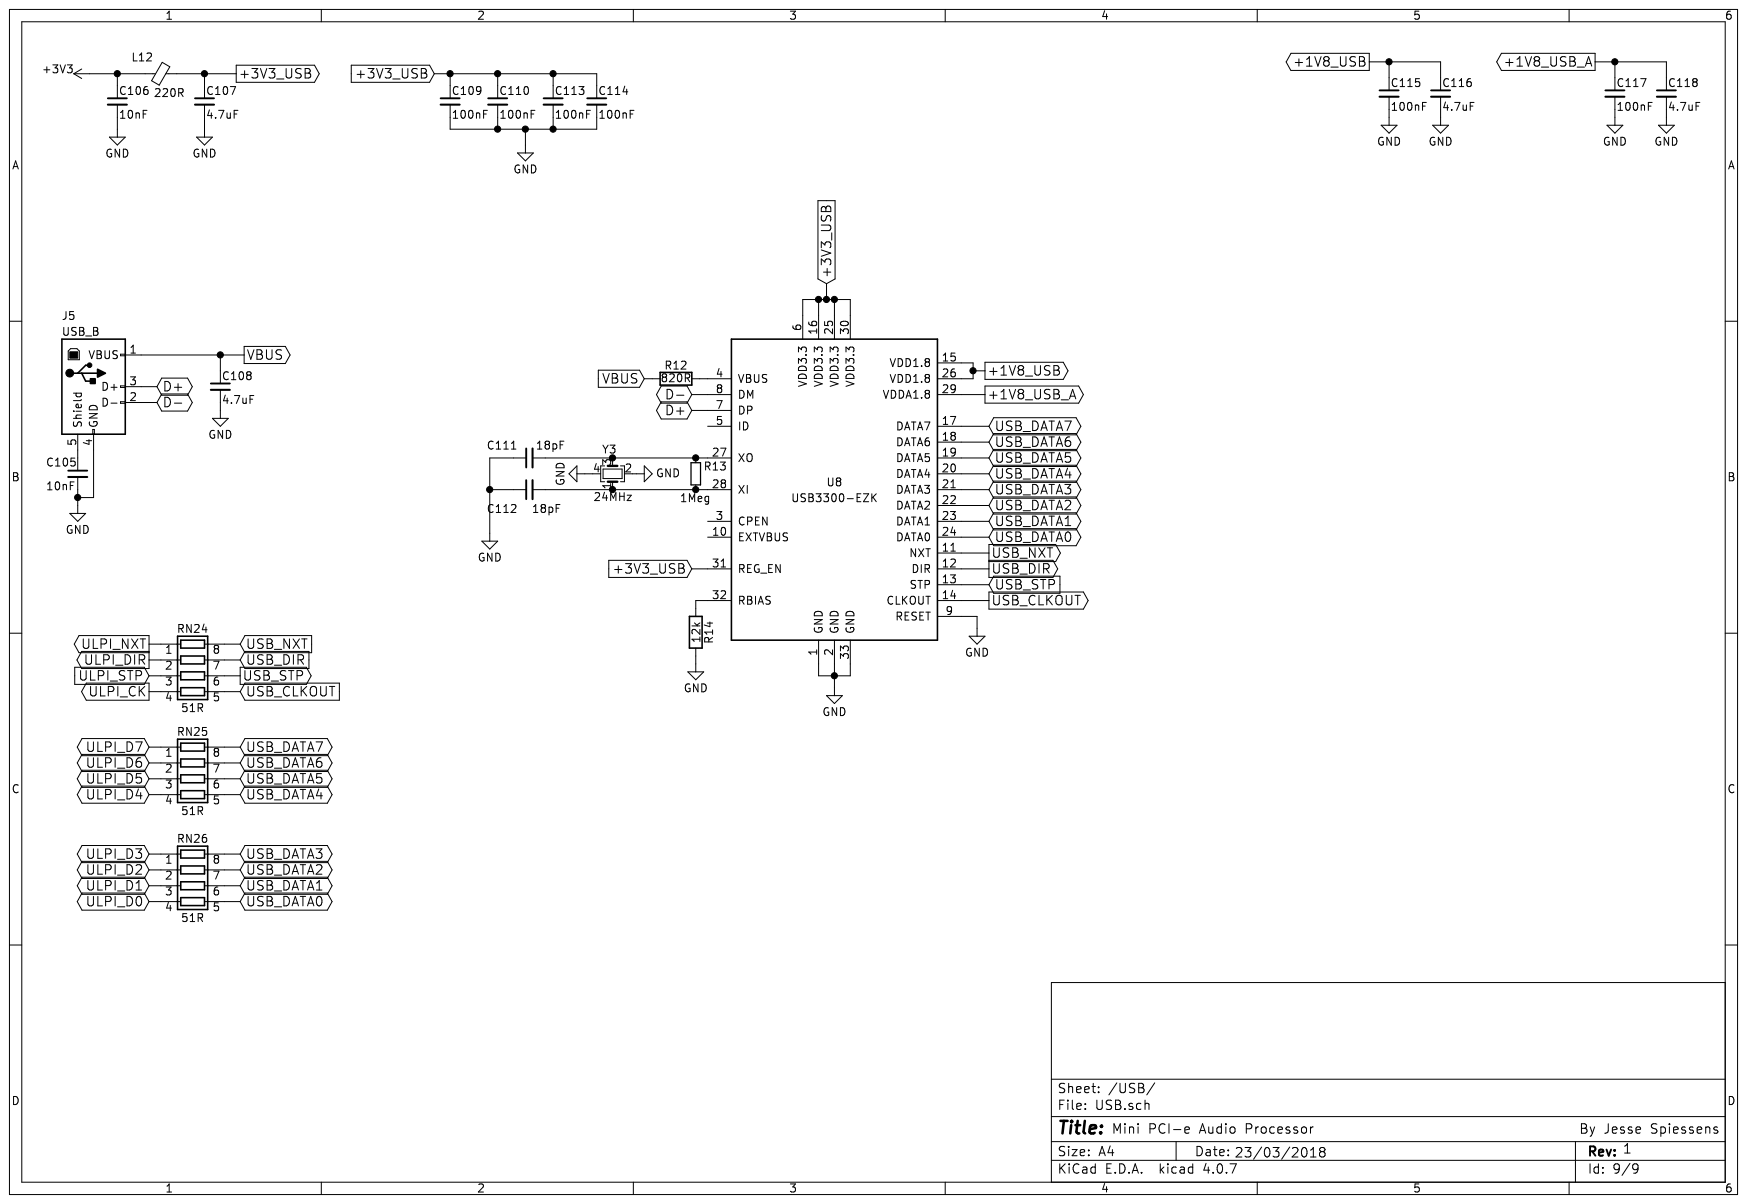
[picture p93: page 9]
