Tyrsz/Audio_Processor/PCB/DSP board/MCU.pdf

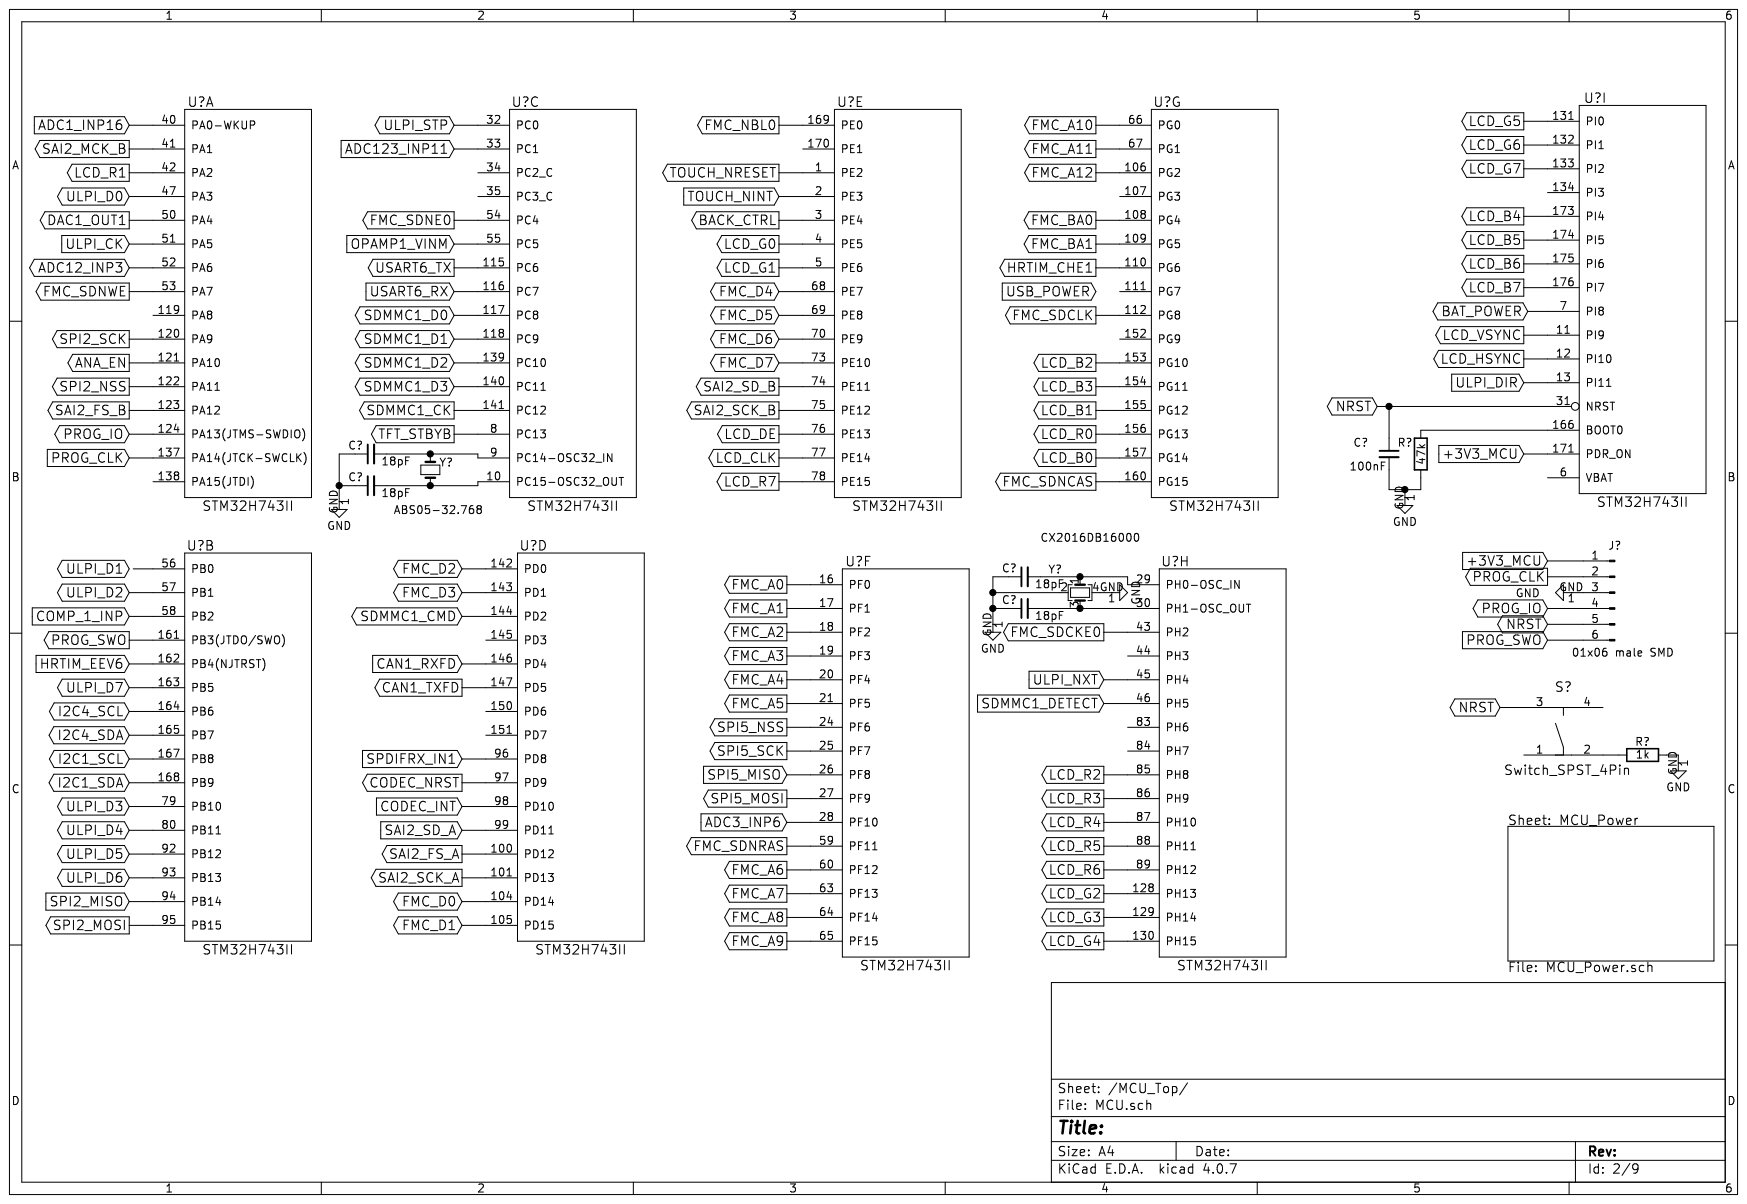
[picture p94: page 1]
