Tyrsz/Audio_Processor/PCB/DSP board/Main board.kicad_pcb

## KiCad design PCB/DSP board/Main board.kicad_pcb (2018-05-18)

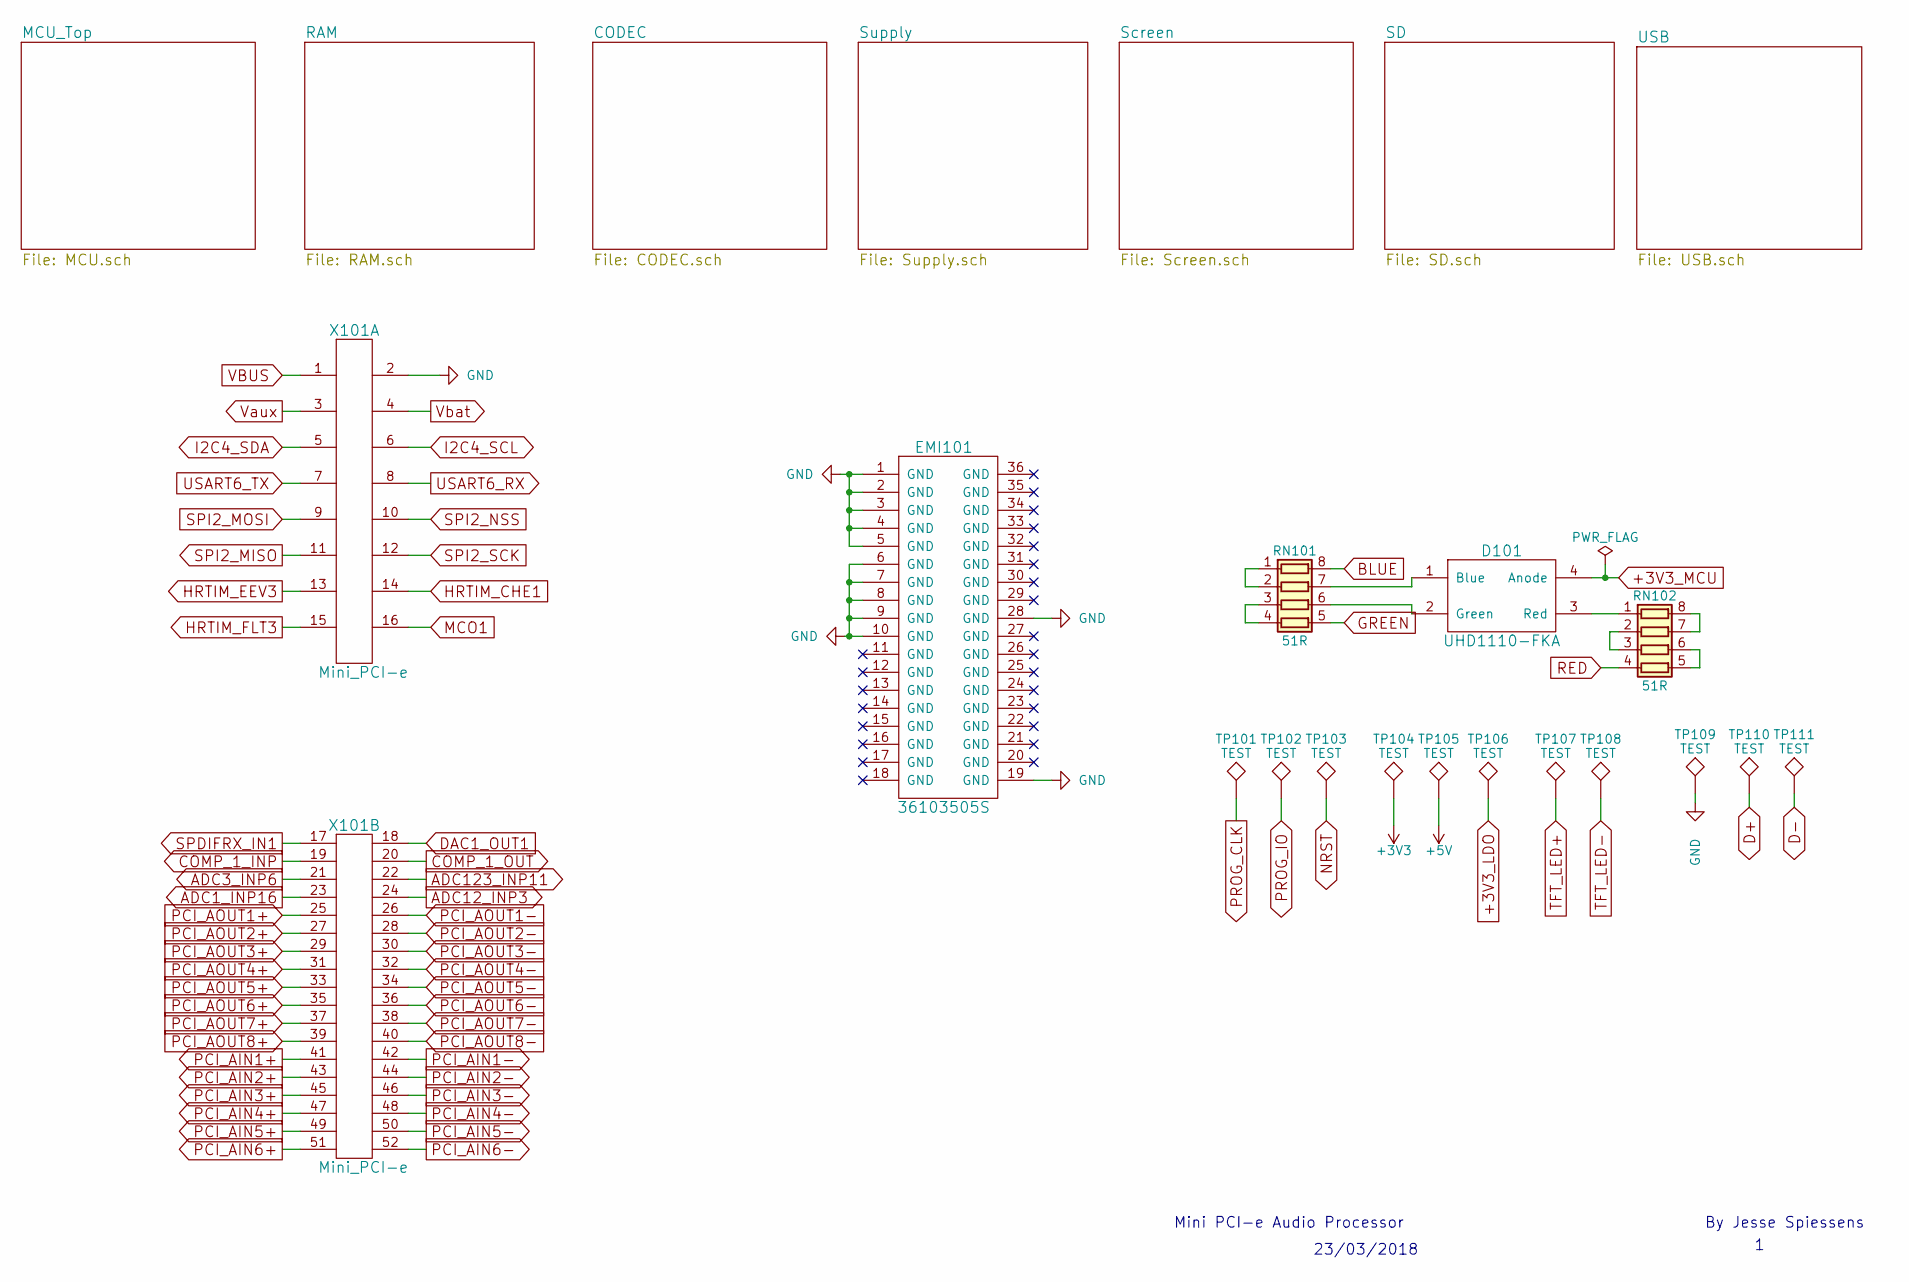
[picture p95: schematic Main board.sch]

Parts:
D101: UHD1110-FKA; PLCC-4_1x1mm
EMI101: 36103505S
RN101, RN102: 51R; 0603_RN4
TP101, TP102, TP103, TP104, TP105, TP106, TP107, TP108, TP109, TP110, TP111: TEST; Measurement_Point_Round-SMD-Pad_Small
X101: Mini_PCI-e

Connections:
+3V3: TP104.1; also elsewhere on the board
+3V3_LDO: TP106.1; also elsewhere on the board
+3V3_MCU: D101.4 (Anode); also elsewhere on the board
+5V: TP105.1; also elsewhere on the board
ADC1_INP16: X101.23; also elsewhere on the board
ADC3_INP6: X101.21; also elsewhere on the board
ADC12_INP3: X101.24; also elsewhere on the board
ADC123_INP11: X101.22; also elsewhere on the board
BLUE: RN101.8 (R1.2); also elsewhere on the board
COMP_1_INP: X101.19; also elsewhere on the board
COMP_1_OUT: X101.20; also elsewhere on the board
D+: TP110.1; also elsewhere on the board
D-: TP111.1; also elsewhere on the board
DAC1_OUT1: X101.18; also elsewhere on the board
GND: EMI101.1, EMI101.2, EMI101.3, EMI101.4, EMI101.5, EMI101.6, EMI101.7, EMI101.8, EMI101.9, EMI101.10, EMI101.19, EMI101.28, TP109.1, X101.2; also elsewhere on the board
GREEN: RN101.5 (R4.2); also elsewhere on the board
HRTIM_CHE1: X101.14; also elsewhere on the board
HRTIM_EEV3: X101.13; also elsewhere on the board
HRTIM_FLT3: X101.15; also elsewhere on the board
I2C4_SCL: X101.6; also elsewhere on the board
I2C4_SDA: X101.5; also elsewhere on the board
MCO1: X101.16; also elsewhere on the board
NRST: TP103.1; also elsewhere on the board
unnamed: D101.1 (Blue), RN101.7 (R2.2)
unnamed: D101.2 (Green), RN101.6 (R3.2)
unnamed: D101.3 (Red), RN102.1 (R1.1)
unnamed: RN101.1 (R1.1), RN101.2 (R2.1)
unnamed: RN101.3 (R3.1), RN101.4 (R4.1)
unnamed: RN102.2 (R2.1), RN102.3 (R3.1)
unnamed: RN102.5 (R4.2), RN102.6 (R3.2)
unnamed: RN102.7 (R2.2), RN102.8 (R1.2)
PCI_AIN1+: X101.41; also elsewhere on the board
PCI_AIN1-: X101.42; also elsewhere on the board
PCI_AIN2+: X101.43; also elsewhere on the board
PCI_AIN2-: X101.44; also elsewhere on the board
PCI_AIN3+: X101.45; also elsewhere on the board
PCI_AIN3-: X101.46; also elsewhere on the board
PCI_AIN4+: X101.47; also elsewhere on the board
PCI_AIN4-: X101.48; also elsewhere on the board
PCI_AIN5+: X101.49; also elsewhere on the board
PCI_AIN5-: X101.50; also elsewhere on the board
PCI_AIN6+: X101.51; also elsewhere on the board
PCI_AIN6-: X101.52; also elsewhere on the board
PCI_AOUT1+: X101.25; also elsewhere on the board
PCI_AOUT1-: X101.26; also elsewhere on the board
PCI_AOUT2+: X101.27; also elsewhere on the board
PCI_AOUT2-: X101.28; also elsewhere on the board
PCI_AOUT3+: X101.29; also elsewhere on the board
PCI_AOUT3-: X101.30; also elsewhere on the board
PCI_AOUT4+: X101.31; also elsewhere on the board
PCI_AOUT4-: X101.32; also elsewhere on the board
PCI_AOUT5+: X101.33; also elsewhere on the board
PCI_AOUT5-: X101.34; also elsewhere on the board
PCI_AOUT6+: X101.35; also elsewhere on the board
PCI_AOUT6-: X101.36; also elsewhere on the board
PCI_AOUT7+: X101.37; also elsewhere on the board
PCI_AOUT7-: X101.38; also elsewhere on the board
PCI_AOUT8+: X101.39; also elsewhere on the board
PCI_AOUT8-: X101.40; also elsewhere on the board
PROG_CLK: TP101.1; also elsewhere on the board
PROG_IO: TP102.1; also elsewhere on the board
RED: RN102.4 (R4.1); also elsewhere on the board
SPDIFRX_IN1: X101.17; also elsewhere on the board
SPI2_MISO: X101.11; also elsewhere on the board
SPI2_MOSI: X101.9; also elsewhere on the board
SPI2_NSS: X101.10; also elsewhere on the board
SPI2_SCK: X101.12; also elsewhere on the board
TFT_LED+: TP107.1; also elsewhere on the board
TFT_LED-: TP108.1; also elsewhere on the board
USART6_RX: X101.8; also elsewhere on the board
USART6_TX: X101.7; also elsewhere on the board
VBUS: X101.1; also elsewhere on the board
Vaux: X101.3; also elsewhere on the board
Vbat: X101.4; also elsewhere on the board

Notes on the sheet:
23/03/2018
Mini PCI-e Audio Processor
By Jesse Spiessens

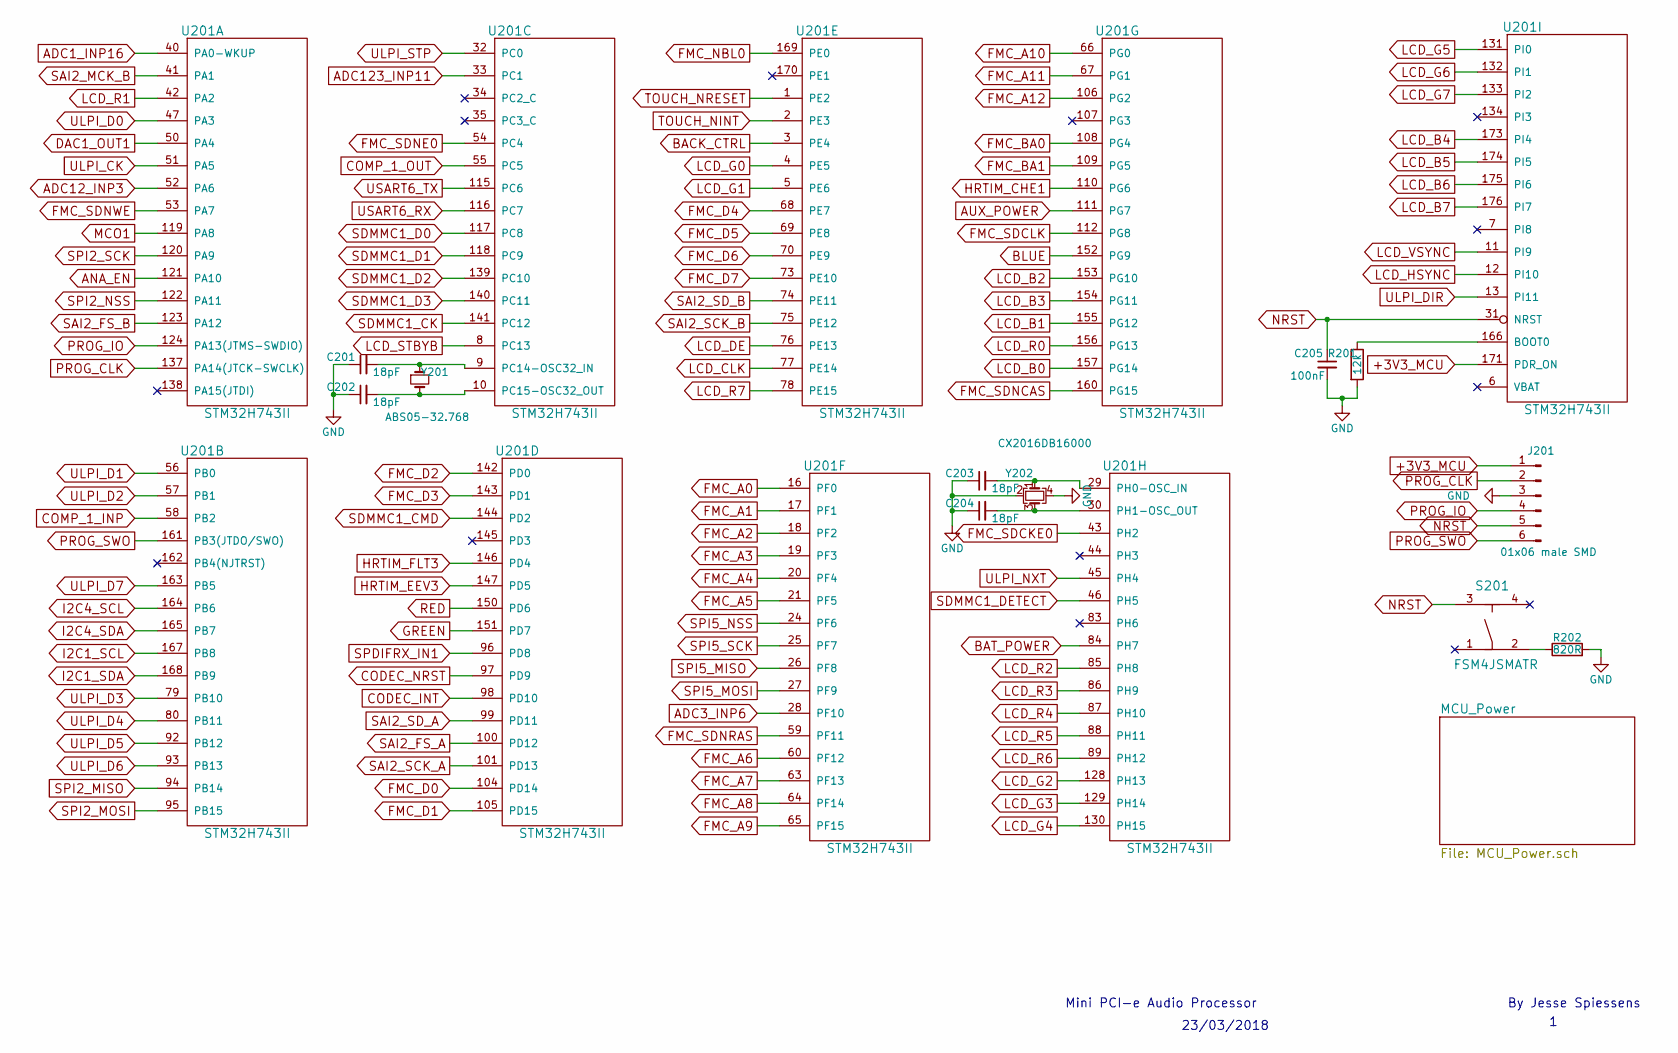
[picture p96: schematic MCU.sch]

Parts:
C201, C202, C203, C204: 18pF; C_0603
C205: 100nF; C_0603
J201: 01x06 male SMD; Pin_Header_Straight_1x06_Pitch2.54mm_SMD_Pin1Right
R201: 12k; R_0603
R202: 820R; R_0603
S201: FSM4JSMATR
U201: STM32H743II; LQFP-176_24x24mm_Pitch0.5mm
Y201: ABS05-32.768; Crystal_SMD_MicroCrystal_CM9V-T1A-2pin_1.6x1.0mm
Y202: CX2016DB16000; Crystal_SMD_2016-4pin_2.0x1.6mm

Connections:
+3V3_MCU: J201.1, U201.171 (PDR_ON); also elsewhere on the board
ADC1_INP16: U201.40 (PA0-WKUP); also elsewhere on the board
ADC3_INP6: U201.28 (PF10); also elsewhere on the board
ADC12_INP3: U201.52 (PA6); also elsewhere on the board
ADC123_INP11: U201.33 (PC1); also elsewhere on the board
ANA_EN: U201.121 (PA10); also elsewhere on the board
AUX_POWER: U201.111 (PG7); also elsewhere on the board
BACK_CTRL: U201.3 (PE4); also elsewhere on the board
BAT_POWER: U201.84 (PH7); also elsewhere on the board
BLUE: U201.152 (PG9); also elsewhere on the board
CODEC_INT: U201.98 (PD10); also elsewhere on the board
CODEC_NRST: U201.97 (PD9); also elsewhere on the board
COMP_1_INP: U201.58 (PB2); also elsewhere on the board
COMP_1_OUT: U201.55 (PC5); also elsewhere on the board
DAC1_OUT1: U201.50 (PA4); also elsewhere on the board
FMC_A0: U201.16 (PF0); also elsewhere on the board
FMC_A1: U201.17 (PF1); also elsewhere on the board
FMC_A2: U201.18 (PF2); also elsewhere on the board
FMC_A3: U201.19 (PF3); also elsewhere on the board
FMC_A4: U201.20 (PF4); also elsewhere on the board
FMC_A5: U201.21 (PF5); also elsewhere on the board
FMC_A6: U201.60 (PF12); also elsewhere on the board
FMC_A7: U201.63 (PF13); also elsewhere on the board
FMC_A8: U201.64 (PF14); also elsewhere on the board
FMC_A9: U201.65 (PF15); also elsewhere on the board
FMC_A10: U201.66 (PG0); also elsewhere on the board
FMC_A11: U201.67 (PG1); also elsewhere on the board
FMC_A12: U201.106 (PG2); also elsewhere on the board
FMC_BA0: U201.108 (PG4); also elsewhere on the board
FMC_BA1: U201.109 (PG5); also elsewhere on the board
FMC_D0: U201.104 (PD14); also elsewhere on the board
FMC_D1: U201.105 (PD15); also elsewhere on the board
FMC_D2: U201.142 (PD0); also elsewhere on the board
FMC_D3: U201.143 (PD1); also elsewhere on the board
FMC_D4: U201.68 (PE7); also elsewhere on the board
FMC_D5: U201.69 (PE8); also elsewhere on the board
FMC_D6: U201.70 (PE9); also elsewhere on the board
FMC_D7: U201.73 (PE10); also elsewhere on the board
FMC_NBL0: U201.169 (PE0); also elsewhere on the board
FMC_SDCKE0: U201.43 (PH2); also elsewhere on the board
FMC_SDCLK: U201.112 (PG8); also elsewhere on the board
FMC_SDNCAS: U201.160 (PG15); also elsewhere on the board
FMC_SDNE0: U201.54 (PC4); also elsewhere on the board
FMC_SDNRAS: U201.59 (PF11); also elsewhere on the board
FMC_SDNWE: U201.53 (PA7); also elsewhere on the board
GND: C201.1, C202.1, C203.1, C204.1, C205.2, J201.3, R201.2, R202.2, Y202.2, Y202.4; also elsewhere on the board
GREEN: U201.151 (PD7); also elsewhere on the board
HRTIM_CHE1: U201.110 (PG6); also elsewhere on the board
HRTIM_EEV3: U201.147 (PD5); also elsewhere on the board
HRTIM_FLT3: U201.146 (PD4); also elsewhere on the board
I2C1_SCL: U201.167 (PB8); also elsewhere on the board
I2C1_SDA: U201.168 (PB9); also elsewhere on the board
I2C4_SCL: U201.164 (PB6); also elsewhere on the board
I2C4_SDA: U201.165 (PB7); also elsewhere on the board
LCD_B0: U201.157 (PG14); also elsewhere on the board
LCD_B1: U201.155 (PG12); also elsewhere on the board
LCD_B2: U201.153 (PG10); also elsewhere on the board
LCD_B3: U201.154 (PG11); also elsewhere on the board
LCD_B4: U201.173 (PI4); also elsewhere on the board
LCD_B5: U201.174 (PI5); also elsewhere on the board
LCD_B6: U201.175 (PI6); also elsewhere on the board
LCD_B7: U201.176 (PI7); also elsewhere on the board
LCD_CLK: U201.77 (PE14); also elsewhere on the board
LCD_DE: U201.76 (PE13); also elsewhere on the board
LCD_G0: U201.4 (PE5); also elsewhere on the board
LCD_G1: U201.5 (PE6); also elsewhere on the board
LCD_G2: U201.128 (PH13); also elsewhere on the board
LCD_G3: U201.129 (PH14); also elsewhere on the board
LCD_G4: U201.130 (PH15); also elsewhere on the board
LCD_G5: U201.131 (PI0); also elsewhere on the board
LCD_G6: U201.132 (PI1); also elsewhere on the board
LCD_G7: U201.133 (PI2); also elsewhere on the board
LCD_HSYNC: U201.12 (PI10); also elsewhere on the board
LCD_R0: U201.156 (PG13); also elsewhere on the board
LCD_R1: U201.42 (PA2); also elsewhere on the board
LCD_R2: U201.85 (PH8); also elsewhere on the board
LCD_R3: U201.86 (PH9); also elsewhere on the board
LCD_R4: U201.87 (PH10); also elsewhere on the board
LCD_R5: U201.88 (PH11); also elsewhere on the board
LCD_R6: U201.89 (PH12); also elsewhere on the board
LCD_R7: U201.78 (PE15); also elsewhere on the board
LCD_STBYB: U201.8 (PC13); also elsewhere on the board
LCD_VSYNC: U201.11 (PI9); also elsewhere on the board
MCO1: U201.119 (PA8); also elsewhere on the board
NRST: C205.1, J201.5, S201.3, U201.31 (NRST); also elsewhere on the board
unnamed: C201.2, U201.9 (PC14-OSC32_IN), Y201.1
unnamed: C202.2, U201.10 (PC15-OSC32_OUT), Y201.2
unnamed: C203.2, U201.29 (PH0-OSC_IN), Y202.1
unnamed: C204.2, U201.30 (PH1-OSC_OUT), Y202.3
unnamed: R201.1, U201.166 (BOOT0)
unnamed: R202.1, S201.2
PROG_CLK: J201.2, U201.137 (PA14(JTCK-SWCLK)); also elsewhere on the board
PROG_IO: J201.4, U201.124 (PA13(JTMS-SWDIO)); also elsewhere on the board
PROG_SWO: J201.6, U201.161 (PB3(JTDO/SWO))
RED: U201.150 (PD6); also elsewhere on the board
SAI2_FS_A: U201.100 (PD12); also elsewhere on the board
SAI2_FS_B: U201.123 (PA12); also elsewhere on the board
SAI2_MCK_B: U201.41 (PA1); also elsewhere on the board
SAI2_SCK_A: U201.101 (PD13); also elsewhere on the board
SAI2_SCK_B: U201.75 (PE12); also elsewhere on the board
SAI2_SD_A: U201.99 (PD11); also elsewhere on the board
SAI2_SD_B: U201.74 (PE11); also elsewhere on the board
SDMMC1_CK: U201.141 (PC12); also elsewhere on the board
SDMMC1_CMD: U201.144 (PD2); also elsewhere on the board
SDMMC1_D0: U201.117 (PC8); also elsewhere on the board
SDMMC1_D1: U201.118 (PC9); also elsewhere on the board
SDMMC1_D2: U201.139 (PC10); also elsewhere on the board
SDMMC1_D3: U201.140 (PC11); also elsewhere on the board
SDMMC1_DETECT: U201.46 (PH5); also elsewhere on the board
SPDIFRX_IN1: U201.96 (PD8); also elsewhere on the board
SPI2_MISO: U201.94 (PB14); also elsewhere on the board
SPI2_MOSI: U201.95 (PB15); also elsewhere on the board
SPI2_NSS: U201.122 (PA11); also elsewhere on the board
SPI2_SCK: U201.120 (PA9); also elsewhere on the board
SPI5_MISO: U201.26 (PF8); also elsewhere on the board
SPI5_MOSI: U201.27 (PF9); also elsewhere on the board
SPI5_NSS: U201.24 (PF6); also elsewhere on the board
SPI5_SCK: U201.25 (PF7); also elsewhere on the board
TOUCH_NINT: U201.2 (PE3); also elsewhere on the board
TOUCH_NRESET: U201.1 (PE2); also elsewhere on the board
ULPI_CK: U201.51 (PA5); also elsewhere on the board
ULPI_D0: U201.47 (PA3); also elsewhere on the board
ULPI_D1: U201.56 (PB0); also elsewhere on the board
ULPI_D2: U201.57 (PB1); also elsewhere on the board
ULPI_D3: U201.79 (PB10); also elsewhere on the board
ULPI_D4: U201.80 (PB11); also elsewhere on the board
ULPI_D5: U201.92 (PB12); also elsewhere on the board
ULPI_D6: U201.93 (PB13); also elsewhere on the board
ULPI_D7: U201.163 (PB5); also elsewhere on the board
ULPI_DIR: U201.13 (PI11); also elsewhere on the board
ULPI_NXT: U201.45 (PH4); also elsewhere on the board
ULPI_STP: U201.32 (PC0); also elsewhere on the board
USART6_RX: U201.116 (PC7); also elsewhere on the board
USART6_TX: U201.115 (PC6); also elsewhere on the board

Notes on the sheet:
23/03/2018
Mini PCI-e Audio Processor
By Jesse Spiessens

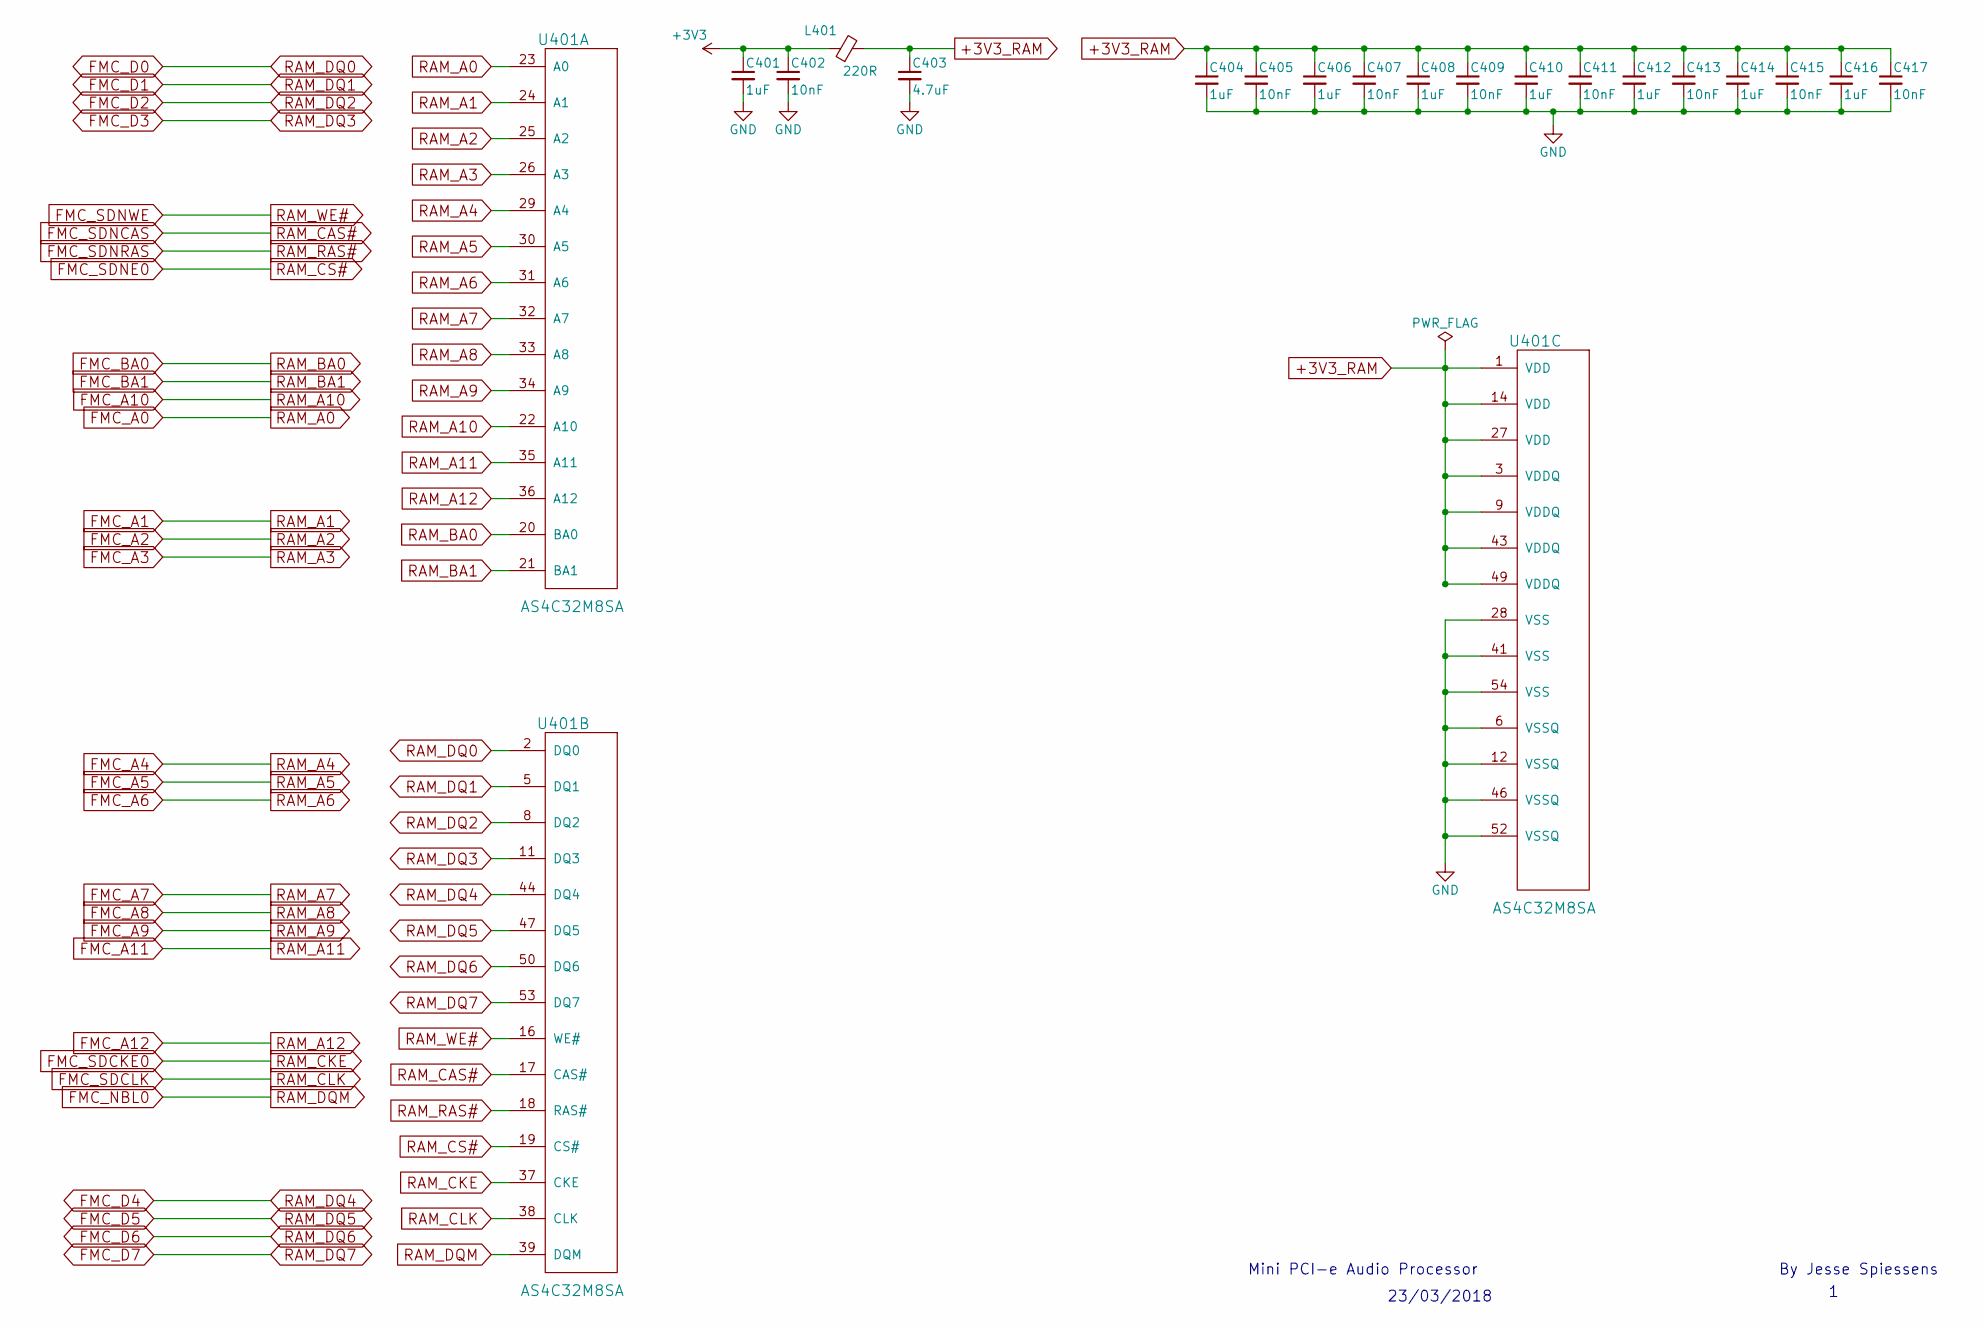
[picture p97: schematic RAM.sch]

Parts:
C401, C404, C406, C408, C410, C412, C414, C416: 1uF; C_0603
C402, C405, C407, C409, C411, C413, C415, C417: 10nF; C_0603
C403: 4.7uF; C_0805
L401: 220R; L_0603
U401: AS4C32M8SA; TSSOP-54_P-0.8mm

Connections:
+3V3: C401.1, C402.1, L401.1; also elsewhere on the board
+3V3_RAM: C403.1, C404.1, C405.1, C406.1, C407.1, C408.1, C409.1, C410.1, C411.1, C412.1, C413.1, C414.1, C415.1, C416.1, C417.1, L401.2, U401.1 (VDD), U401.3 (VDDQ), U401.9 (VDDQ), U401.14 (VDD), U401.27 (VDD), U401.43 (VDDQ), U401.49 (VDDQ)
FMC_A0: U401.23 (A0); also elsewhere on the board
FMC_A1: U401.24 (A1); also elsewhere on the board
FMC_A2: U401.25 (A2); also elsewhere on the board
FMC_A3: U401.26 (A3); also elsewhere on the board
FMC_A4: U401.29 (A4); also elsewhere on the board
FMC_A5: U401.30 (A5); also elsewhere on the board
FMC_A6: U401.31 (A6); also elsewhere on the board
FMC_A7: U401.32 (A7); also elsewhere on the board
FMC_A8: U401.33 (A8); also elsewhere on the board
FMC_A9: U401.34 (A9); also elsewhere on the board
FMC_A10: U401.22 (A10); also elsewhere on the board
FMC_A11: U401.35 (A11); also elsewhere on the board
FMC_A12: U401.36 (A12); also elsewhere on the board
FMC_BA0: U401.20 (BA0); also elsewhere on the board
FMC_BA1: U401.21 (BA1); also elsewhere on the board
FMC_D0: U401.2 (DQ0); also elsewhere on the board
FMC_D1: U401.5 (DQ1); also elsewhere on the board
FMC_D2: U401.8 (DQ2); also elsewhere on the board
FMC_D3: U401.11 (DQ3); also elsewhere on the board
FMC_D4: U401.44 (DQ4); also elsewhere on the board
FMC_D5: U401.47 (DQ5); also elsewhere on the board
FMC_D6: U401.50 (DQ6); also elsewhere on the board
FMC_D7: U401.53 (DQ7); also elsewhere on the board
FMC_NBL0: U401.39 (DQM); also elsewhere on the board
FMC_SDCKE0: U401.37 (CKE); also elsewhere on the board
FMC_SDCLK: U401.38 (CLK); also elsewhere on the board
FMC_SDNCAS: U401.17 (CAS#); also elsewhere on the board
FMC_SDNE0: U401.19 (CS#); also elsewhere on the board
FMC_SDNRAS: U401.18 (RAS#); also elsewhere on the board
FMC_SDNWE: U401.16 (WE#); also elsewhere on the board
GND: C401.2, C402.2, C403.2, C404.2, C405.2, C406.2, C407.2, C408.2, C409.2, C410.2, C411.2, C412.2, C413.2, C414.2, C415.2, C416.2, C417.2, U401.6 (VSSQ), U401.12 (VSSQ), U401.28 (VSS), U401.41 (VSS), U401.46 (VSSQ), U401.52 (VSSQ), U401.54 (VSS); also elsewhere on the board

Notes on the sheet:
23/03/2018
Mini PCI-e Audio Processor
By Jesse Spiessens

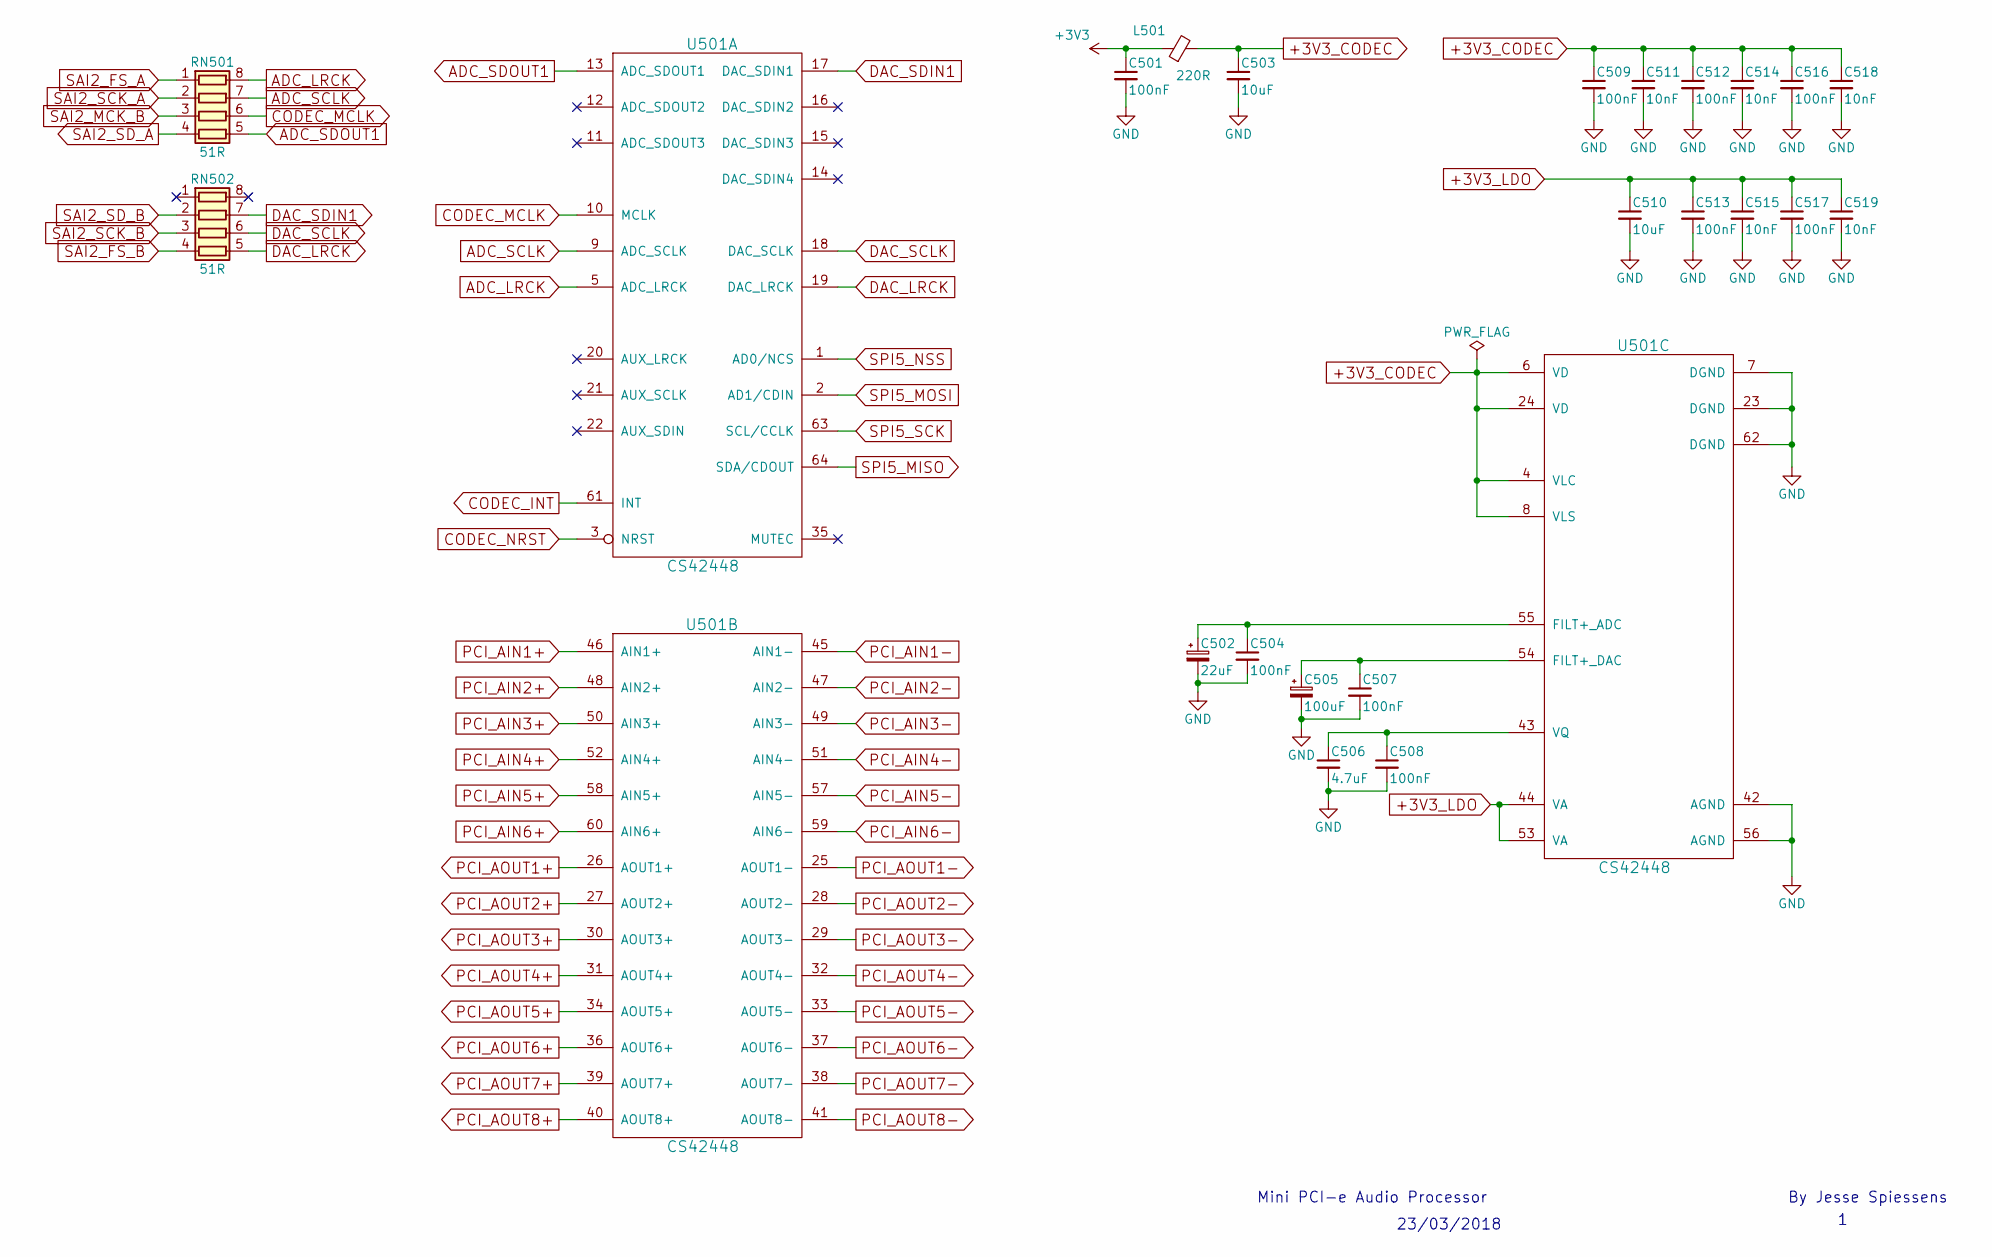
[picture p98: schematic CODEC.sch]

Parts:
C501, C504, C507, C508, C509, C512, C513, C516, C517: 100nF; C_0603
C502: 22uF; CP_Tantalum_Case-A_EIA-3216-18_Reflow
C503, C510: 10uF; C_0805
C505: 100uF; CP_Tantalum_Case-B_EIA-3528-21_Reflow
C506: 4.7uF; C_0805
C511, C514, C515, C518, C519: 10nF; C_0603
L501: 220R; L_0603
RN501, RN502: 51R; 0603_RN4
U501: CS42448; LQFP-64_10x10mm_Pitch0.5mm

Connections:
+3V3: C501.1, L501.1; also elsewhere on the board
+3V3_CODEC: C503.1, C509.1, C511.1, C512.1, C514.1, C516.1, C518.1, L501.2, U501.4 (VLC), U501.6 (VD), U501.8 (VLS), U501.24 (VD)
+3V3_LDO: C510.1, C513.1, C515.1, C517.1, C519.1, U501.44 (VA), U501.53 (VA); also elsewhere on the board
ADC_LRCK: RN501.8 (R1.2), U501.5 (ADC_LRCK)
ADC_SCLK: RN501.7 (R2.2), U501.9 (ADC_SCLK)
ADC_SDOUT1: RN501.5 (R4.2), U501.13 (ADC_SDOUT1)
CODEC_INT: U501.61 (INT); also elsewhere on the board
CODEC_MCLK: RN501.6 (R3.2), U501.10 (MCLK)
CODEC_NRST: U501.3 (NRST); also elsewhere on the board
DAC_LRCK: RN502.5 (R4.2), U501.19 (DAC_LRCK)
DAC_SCLK: RN502.6 (R3.2), U501.18 (DAC_SCLK)
DAC_SDIN1: RN502.7 (R2.2), U501.17 (DAC_SDIN1)
GND: C501.2, C502.2, C503.2, C504.2, C505.2, C506.2, C507.2, C508.2, C509.2, C510.2, C511.2, C512.2, C513.2, C514.2, C515.2, C516.2, C517.2, C518.2, C519.2, U501.7 (DGND), U501.23 (DGND), U501.42 (AGND), U501.56 (AGND), U501.62 (DGND); also elsewhere on the board
unnamed: C502.1, C504.1, U501.55 (FILT+_ADC)
unnamed: C505.1, C507.1, U501.54 (FILT+_DAC)
unnamed: C506.1, C508.1, U501.43 (VQ)
PCI_AIN1+: U501.46 (AIN1+); also elsewhere on the board
PCI_AIN1-: U501.45 (AIN1-); also elsewhere on the board
PCI_AIN2+: U501.48 (AIN2+); also elsewhere on the board
PCI_AIN2-: U501.47 (AIN2-); also elsewhere on the board
PCI_AIN3+: U501.50 (AIN3+); also elsewhere on the board
PCI_AIN3-: U501.49 (AIN3-); also elsewhere on the board
PCI_AIN4+: U501.52 (AIN4+); also elsewhere on the board
PCI_AIN4-: U501.51 (AIN4-); also elsewhere on the board
PCI_AIN5+: U501.58 (AIN5+); also elsewhere on the board
PCI_AIN5-: U501.57 (AIN5-); also elsewhere on the board
PCI_AIN6+: U501.60 (AIN6+); also elsewhere on the board
PCI_AIN6-: U501.59 (AIN6-); also elsewhere on the board
PCI_AOUT1+: U501.26 (AOUT1+); also elsewhere on the board
PCI_AOUT1-: U501.25 (AOUT1-); also elsewhere on the board
PCI_AOUT2+: U501.27 (AOUT2+); also elsewhere on the board
PCI_AOUT2-: U501.28 (AOUT2-); also elsewhere on the board
PCI_AOUT3+: U501.30 (AOUT3+); also elsewhere on the board
PCI_AOUT3-: U501.29 (AOUT3-); also elsewhere on the board
PCI_AOUT4+: U501.31 (AOUT4+); also elsewhere on the board
PCI_AOUT4-: U501.32 (AOUT4-); also elsewhere on the board
PCI_AOUT5+: U501.34 (AOUT5+); also elsewhere on the board
PCI_AOUT5-: U501.33 (AOUT5-); also elsewhere on the board
PCI_AOUT6+: U501.36 (AOUT6+); also elsewhere on the board
PCI_AOUT6-: U501.37 (AOUT6-); also elsewhere on the board
PCI_AOUT7+: U501.39 (AOUT7+); also elsewhere on the board
PCI_AOUT7-: U501.38 (AOUT7-); also elsewhere on the board
PCI_AOUT8+: U501.40 (AOUT8+); also elsewhere on the board
PCI_AOUT8-: U501.41 (AOUT8-); also elsewhere on the board
SAI2_FS_A: RN501.1 (R1.1); also elsewhere on the board
SAI2_FS_B: RN502.4 (R4.1); also elsewhere on the board
SAI2_MCK_B: RN501.3 (R3.1); also elsewhere on the board
SAI2_SCK_A: RN501.2 (R2.1); also elsewhere on the board
SAI2_SCK_B: RN502.3 (R3.1); also elsewhere on the board
SAI2_SD_A: RN501.4 (R4.1); also elsewhere on the board
SAI2_SD_B: RN502.2 (R2.1); also elsewhere on the board
SPI5_MISO: U501.64 (SDA/CDOUT); also elsewhere on the board
SPI5_MOSI: U501.2 (AD1/CDIN); also elsewhere on the board
SPI5_NSS: U501.1 (AD0/NCS); also elsewhere on the board
SPI5_SCK: U501.63 (SCL/CCLK); also elsewhere on the board

Notes on the sheet:
23/03/2018
Mini PCI-e Audio Processor
By Jesse Spiessens
