Tyrsz/Audio_Processor/PCB/DSP board/Main board.kicad_pcb

## KiCad design PCB/DSP board/Main board.kicad_pcb (continued)

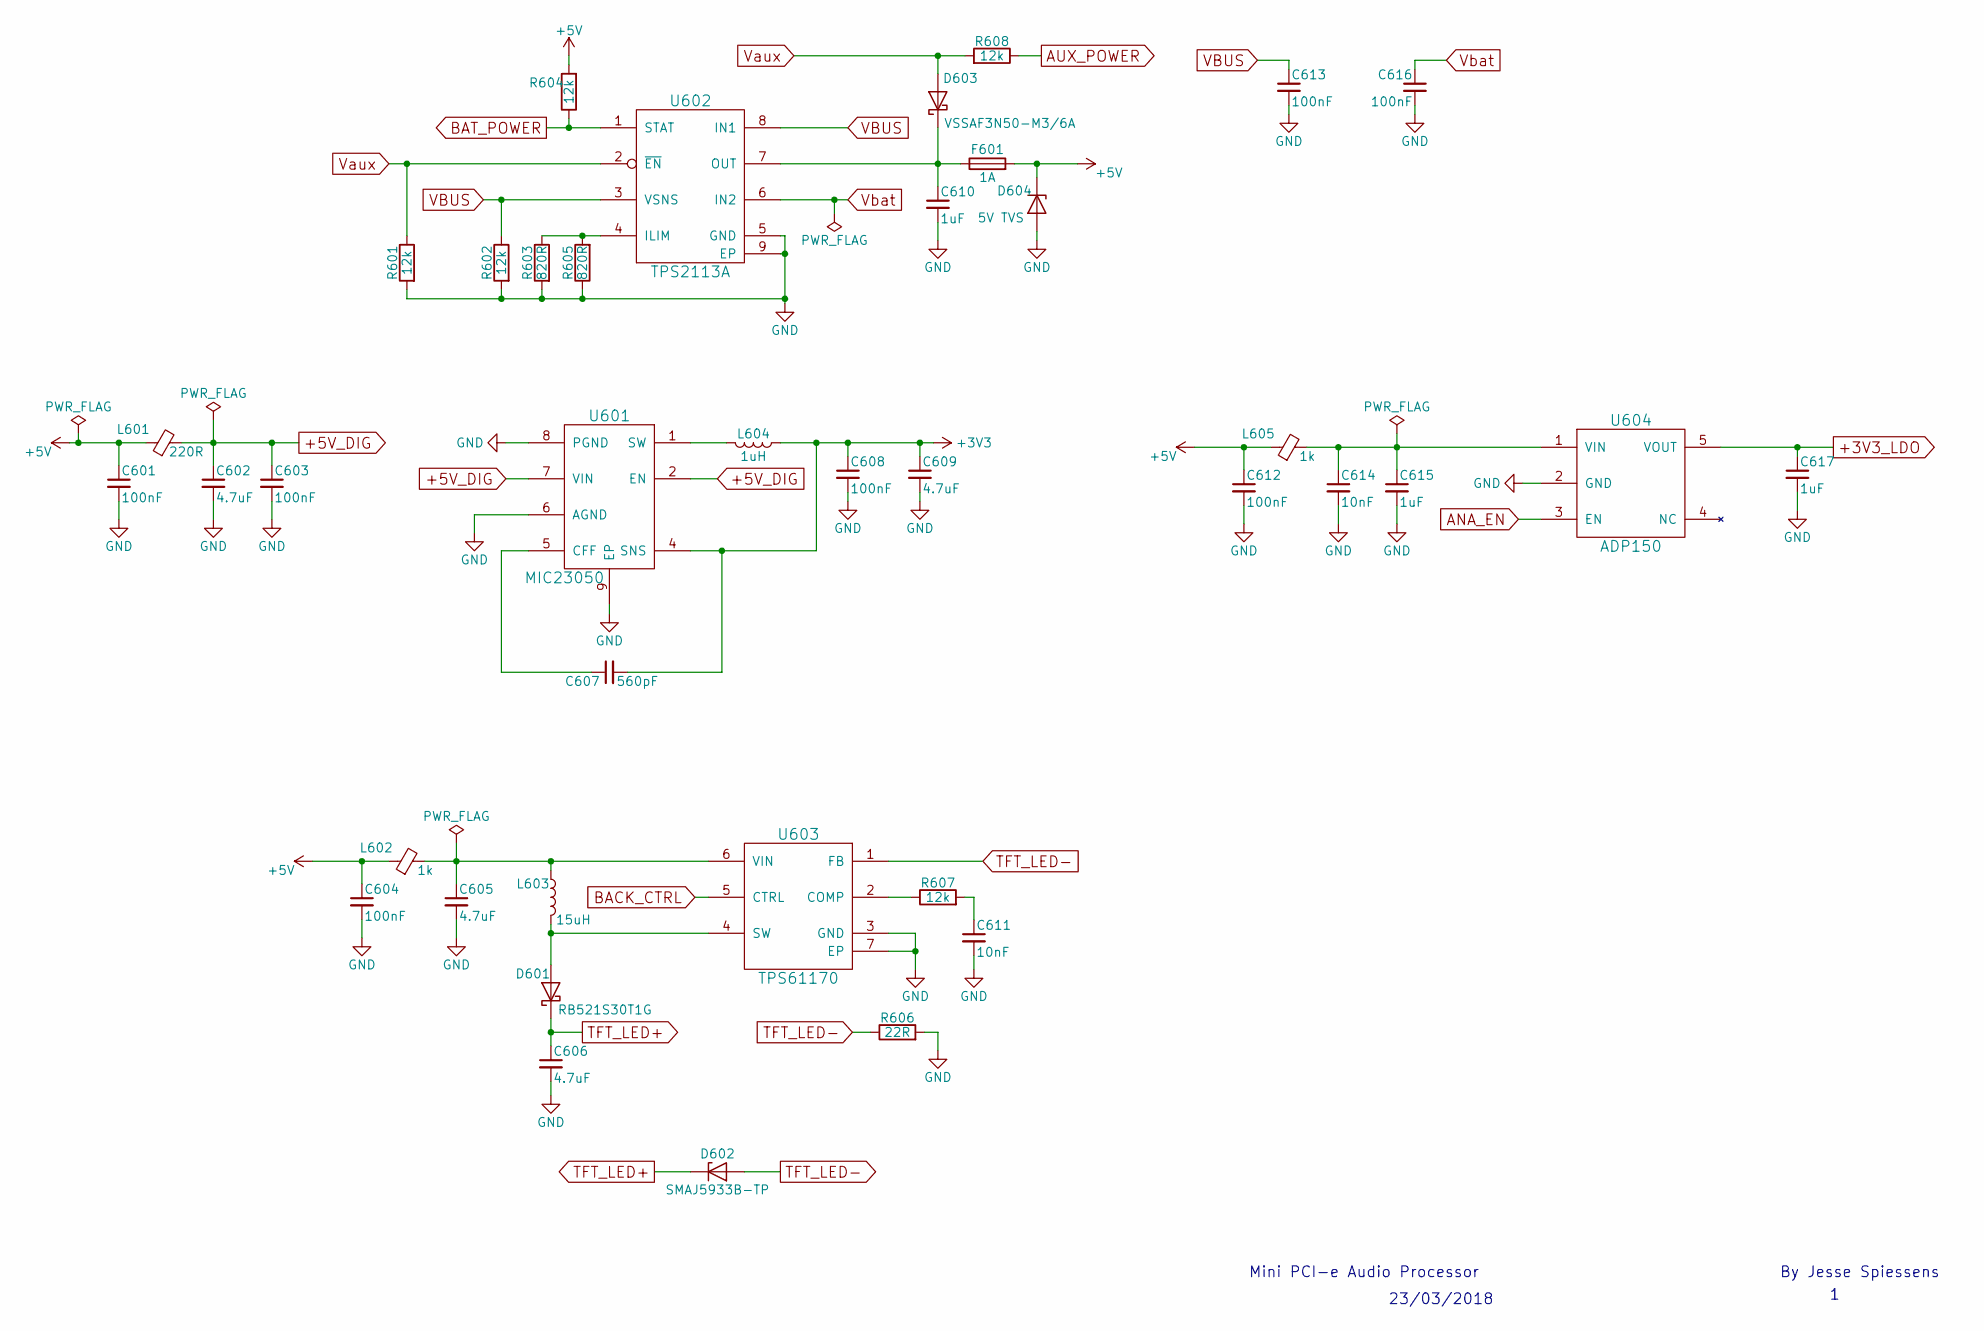
[picture p99: schematic Supply.sch]

Parts:
C601, C603, C604, C608, C612, C613, C616: 100nF; C_0603
C602, C605, C609: 4.7uF; C_0805
C606: 4.7uF; C_1206
C607: 560pF; C_0603
C610, C615, C617: 1uF; C_0603
C611, C614: 10nF; C_0603
D601: RB521S30T1G; D_SOD-523
D602: SMAJ5933B-TP; D_SMA
D603: VSSAF3N50-M3/6A; D_SMA
D604: 5V TVS; SOD-323F-2
F601: 1A; R_0603
L601: 220R; L_0603
L602, L605: 1k; L_0603
L603: 15uH; L_0805
L604: 1uH; L_0805
R601, R602, R604, R607, R608: 12k; R_0603
R603, R605: 820R; R_0603
R606: 22R; R_0805
U601: MIC23050; DFN-8-1EP_2x2mm_Pitch0.5mm
U602: TPS2113A; DFN-8-1EP_3x3mm_Pitch0.65mm
U603: TPS61170; DFN-6-1EP_2x2mm_Pitch0.65mm
U604: ADP150; TSOP-5_1.65x3.05mm_Pitch0.95mm

Connections:
+3V3: C607.2, C608.1, C609.1, L604.1, U601.4 (SNS); also elsewhere on the board
+3V3_LDO: C617.1, U604.5 (VOUT); also elsewhere on the board
+5V: C601.1, C604.1, C612.1, D604.1 (K), F601.2, L601.1, L602.1, L605.1, R604.2; also elsewhere on the board
+5V_DIG: C602.1, C603.1, L601.2, U601.2 (EN), U601.7 (VIN)
ANA_EN: U604.3 (EN); also elsewhere on the board
AUX_POWER: R608.1; also elsewhere on the board
BACK_CTRL: U603.5 (CTRL); also elsewhere on the board
BAT_POWER: R604.1, U602.1 (STAT); also elsewhere on the board
GND: C601.2, C602.2, C603.2, C604.2, C605.2, C606.2, C608.2, C609.2, C610.2, C611.2, C612.2, C613.2, C614.2, C615.2, C616.2, C617.2, D604.2 (A), R601.2, R602.2, R603.2, R605.1, R606.2, U601.6 (AGND), U601.8 (PGND), U601.9 (EP), U602.5 (GND), U602.9 (EP), U603.3 (GND), U603.7 (EP), U604.2 (GND); also elsewhere on the board
unnamed: C605.1, L602.2, L603.1, U603.6 (VIN)
unnamed: C607.1, U601.5 (CFF)
unnamed: C610.1, D603.1 (K), F601.1, U602.7 (OUT)
unnamed: C611.1, R607.2
unnamed: C614.1, C615.1, L605.2, U604.1 (VIN)
unnamed: D601.2 (A), L603.2, U603.4 (SW)
unnamed: L604.2, U601.1 (SW)
unnamed: R603.1, R605.2, U602.4 (ILIM)
unnamed: R607.1, U603.2 (COMP)
TFT_LED+: C606.1, D601.1 (K), D602.1 (K); also elsewhere on the board
TFT_LED-: D602.2 (A), R606.1, U603.1 (FB); also elsewhere on the board
VBUS: C613.1, R602.1, U602.3 (VSNS), U602.8 (IN1); also elsewhere on the board
Vaux: D603.2 (A), R601.1, R608.2, U602.2 (~EN); also elsewhere on the board
Vbat: C616.1, U602.6 (IN2); also elsewhere on the board

Notes on the sheet:
23/03/2018
Mini PCI-e Audio Processor
By Jesse Spiessens

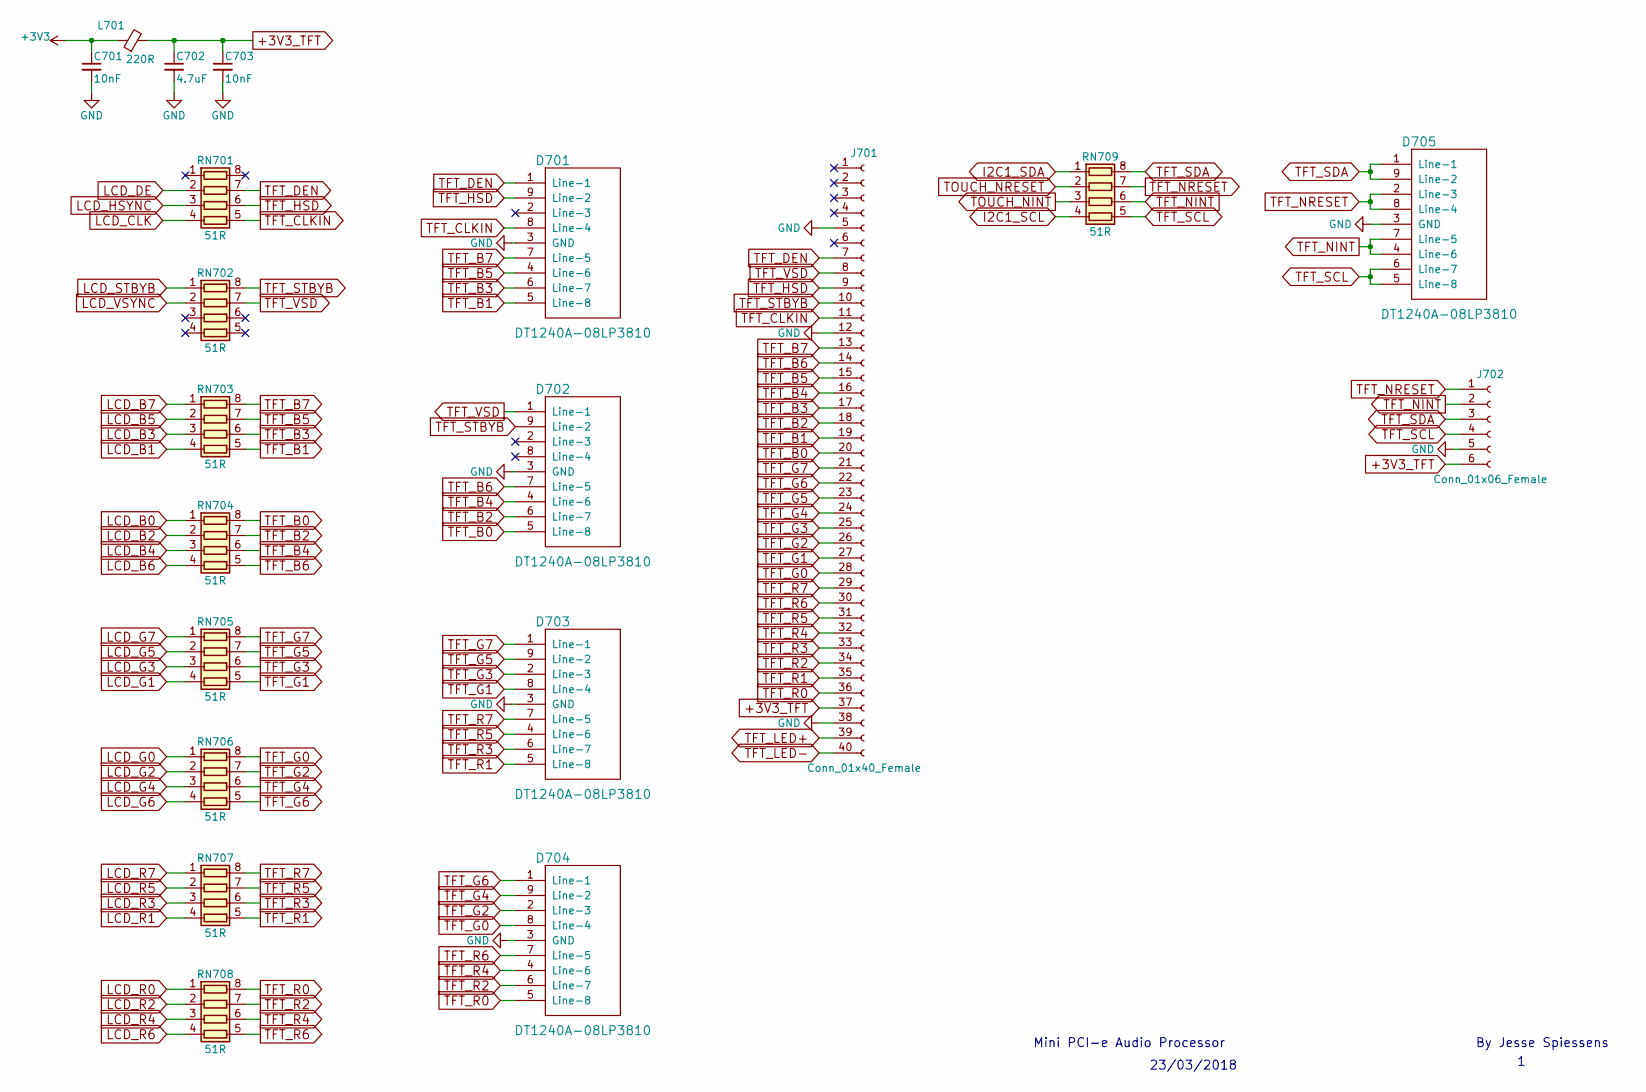
[picture p100: schematic Screen.sch]

Parts:
C701, C703: 10nF; C_0603
C702: 4.7uF; C_0805
D701, D702, D703, D704, D705: DT1240A-08LP3810; U-DFN3810-9
J701: Conn_01x40_Female; 78127-1408
J702: Conn_01x06_Female; 52808-0671
L701: 220R; L_0603
RN701, RN702, RN703, RN704, RN705, RN706, RN707, RN708, RN709: 51R; 0603_RN4

Connections:
+3V3: C701.1, L701.1; also elsewhere on the board
+3V3_TFT: C702.1, C703.1, J701.37, J702.6, L701.2
GND: C701.2, C702.2, C703.2, D701.3 (GND), D702.3 (GND), D703.3 (GND), D704.3 (GND), D705.3 (GND), J701.5, J701.12, J701.38, J702.5; also elsewhere on the board
I2C1_SCL: RN709.4 (R4.1); also elsewhere on the board
I2C1_SDA: RN709.1 (R1.1); also elsewhere on the board
LCD_B0: RN704.1 (R1.1); also elsewhere on the board
LCD_B1: RN703.4 (R4.1); also elsewhere on the board
LCD_B2: RN704.2 (R2.1); also elsewhere on the board
LCD_B3: RN703.3 (R3.1); also elsewhere on the board
LCD_B4: RN704.3 (R3.1); also elsewhere on the board
LCD_B5: RN703.2 (R2.1); also elsewhere on the board
LCD_B6: RN704.4 (R4.1); also elsewhere on the board
LCD_B7: RN703.1 (R1.1); also elsewhere on the board
LCD_CLK: RN701.4 (R4.1); also elsewhere on the board
LCD_DE: RN701.2 (R2.1); also elsewhere on the board
LCD_G0: RN706.1 (R1.1); also elsewhere on the board
LCD_G1: RN705.4 (R4.1); also elsewhere on the board
LCD_G2: RN706.2 (R2.1); also elsewhere on the board
LCD_G3: RN705.3 (R3.1); also elsewhere on the board
LCD_G4: RN706.3 (R3.1); also elsewhere on the board
LCD_G5: RN705.2 (R2.1); also elsewhere on the board
LCD_G6: RN706.4 (R4.1); also elsewhere on the board
LCD_G7: RN705.1 (R1.1); also elsewhere on the board
LCD_HSYNC: RN701.3 (R3.1); also elsewhere on the board
LCD_R0: RN708.1 (R1.1); also elsewhere on the board
LCD_R1: RN707.4 (R4.1); also elsewhere on the board
LCD_R2: RN708.2 (R2.1); also elsewhere on the board
LCD_R3: RN707.3 (R3.1); also elsewhere on the board
LCD_R4: RN708.3 (R3.1); also elsewhere on the board
LCD_R5: RN707.2 (R2.1); also elsewhere on the board
LCD_R6: RN708.4 (R4.1); also elsewhere on the board
LCD_R7: RN707.1 (R1.1); also elsewhere on the board
LCD_STBYB: RN702.1 (R1.1); also elsewhere on the board
LCD_VSYNC: RN702.2 (R2.1); also elsewhere on the board
TFT_B0: D702.5 (Line-8), J701.20, RN704.8 (R1.2)
TFT_B1: D701.5 (Line-8), J701.19, RN703.5 (R4.2)
TFT_B2: D702.6 (Line-7), J701.18, RN704.7 (R2.2)
TFT_B3: D701.6 (Line-7), J701.17, RN703.6 (R3.2)
TFT_B4: D702.4 (Line-6), J701.16, RN704.6 (R3.2)
TFT_B5: D701.4 (Line-6), J701.15, RN703.7 (R2.2)
TFT_B6: D702.7 (Line-5), J701.14, RN704.5 (R4.2)
TFT_B7: D701.7 (Line-5), J701.13, RN703.8 (R1.2)
TFT_CLKIN: D701.8 (Line-4), J701.11, RN701.5 (R4.2)
TFT_DEN: D701.1 (Line-1), J701.7, RN701.7 (R2.2)
TFT_G0: D704.8 (Line-4), J701.28, RN706.8 (R1.2)
TFT_G1: D703.8 (Line-4), J701.27, RN705.5 (R4.2)
TFT_G2: D704.2 (Line-3), J701.26, RN706.7 (R2.2)
TFT_G3: D703.2 (Line-3), J701.25, RN705.6 (R3.2)
TFT_G4: D704.9 (Line-2), J701.24, RN706.6 (R3.2)
TFT_G5: D703.9 (Line-2), J701.23, RN705.7 (R2.2)
TFT_G6: D704.1 (Line-1), J701.22, RN706.5 (R4.2)
TFT_G7: D703.1 (Line-1), J701.21, RN705.8 (R1.2)
TFT_HSD: D701.9 (Line-2), J701.9, RN701.6 (R3.2)
TFT_LED+: J701.39; also elsewhere on the board
TFT_LED-: J701.40; also elsewhere on the board
TFT_NINT: D705.4 (Line-6), D705.7 (Line-5), J702.2, RN709.6 (R3.2)
TFT_NRESET: D705.2 (Line-3), D705.8 (Line-4), J702.1, RN709.7 (R2.2)
TFT_R0: D704.5 (Line-8), J701.36, RN708.8 (R1.2)
TFT_R1: D703.5 (Line-8), J701.35, RN707.5 (R4.2)
TFT_R2: D704.6 (Line-7), J701.34, RN708.7 (R2.2)
TFT_R3: D703.6 (Line-7), J701.33, RN707.6 (R3.2)
TFT_R4: D704.4 (Line-6), J701.32, RN708.6 (R3.2)
TFT_R5: D703.4 (Line-6), J701.31, RN707.7 (R2.2)
TFT_R6: D704.7 (Line-5), J701.30, RN708.5 (R4.2)
TFT_R7: D703.7 (Line-5), J701.29, RN707.8 (R1.2)
TFT_SCL: D705.5 (Line-8), D705.6 (Line-7), J702.4, RN709.5 (R4.2)
TFT_SDA: D705.1 (Line-1), D705.9 (Line-2), J702.3, RN709.8 (R1.2)
TFT_STBYB: D702.9 (Line-2), J701.10, RN702.8 (R1.2)
TFT_VSD: D702.1 (Line-1), J701.8, RN702.7 (R2.2)
TOUCH_NINT: RN709.3 (R3.1); also elsewhere on the board
TOUCH_NRESET: RN709.2 (R2.1); also elsewhere on the board

Notes on the sheet:
23/03/2018
Mini PCI-e Audio Processor
By Jesse Spiessens

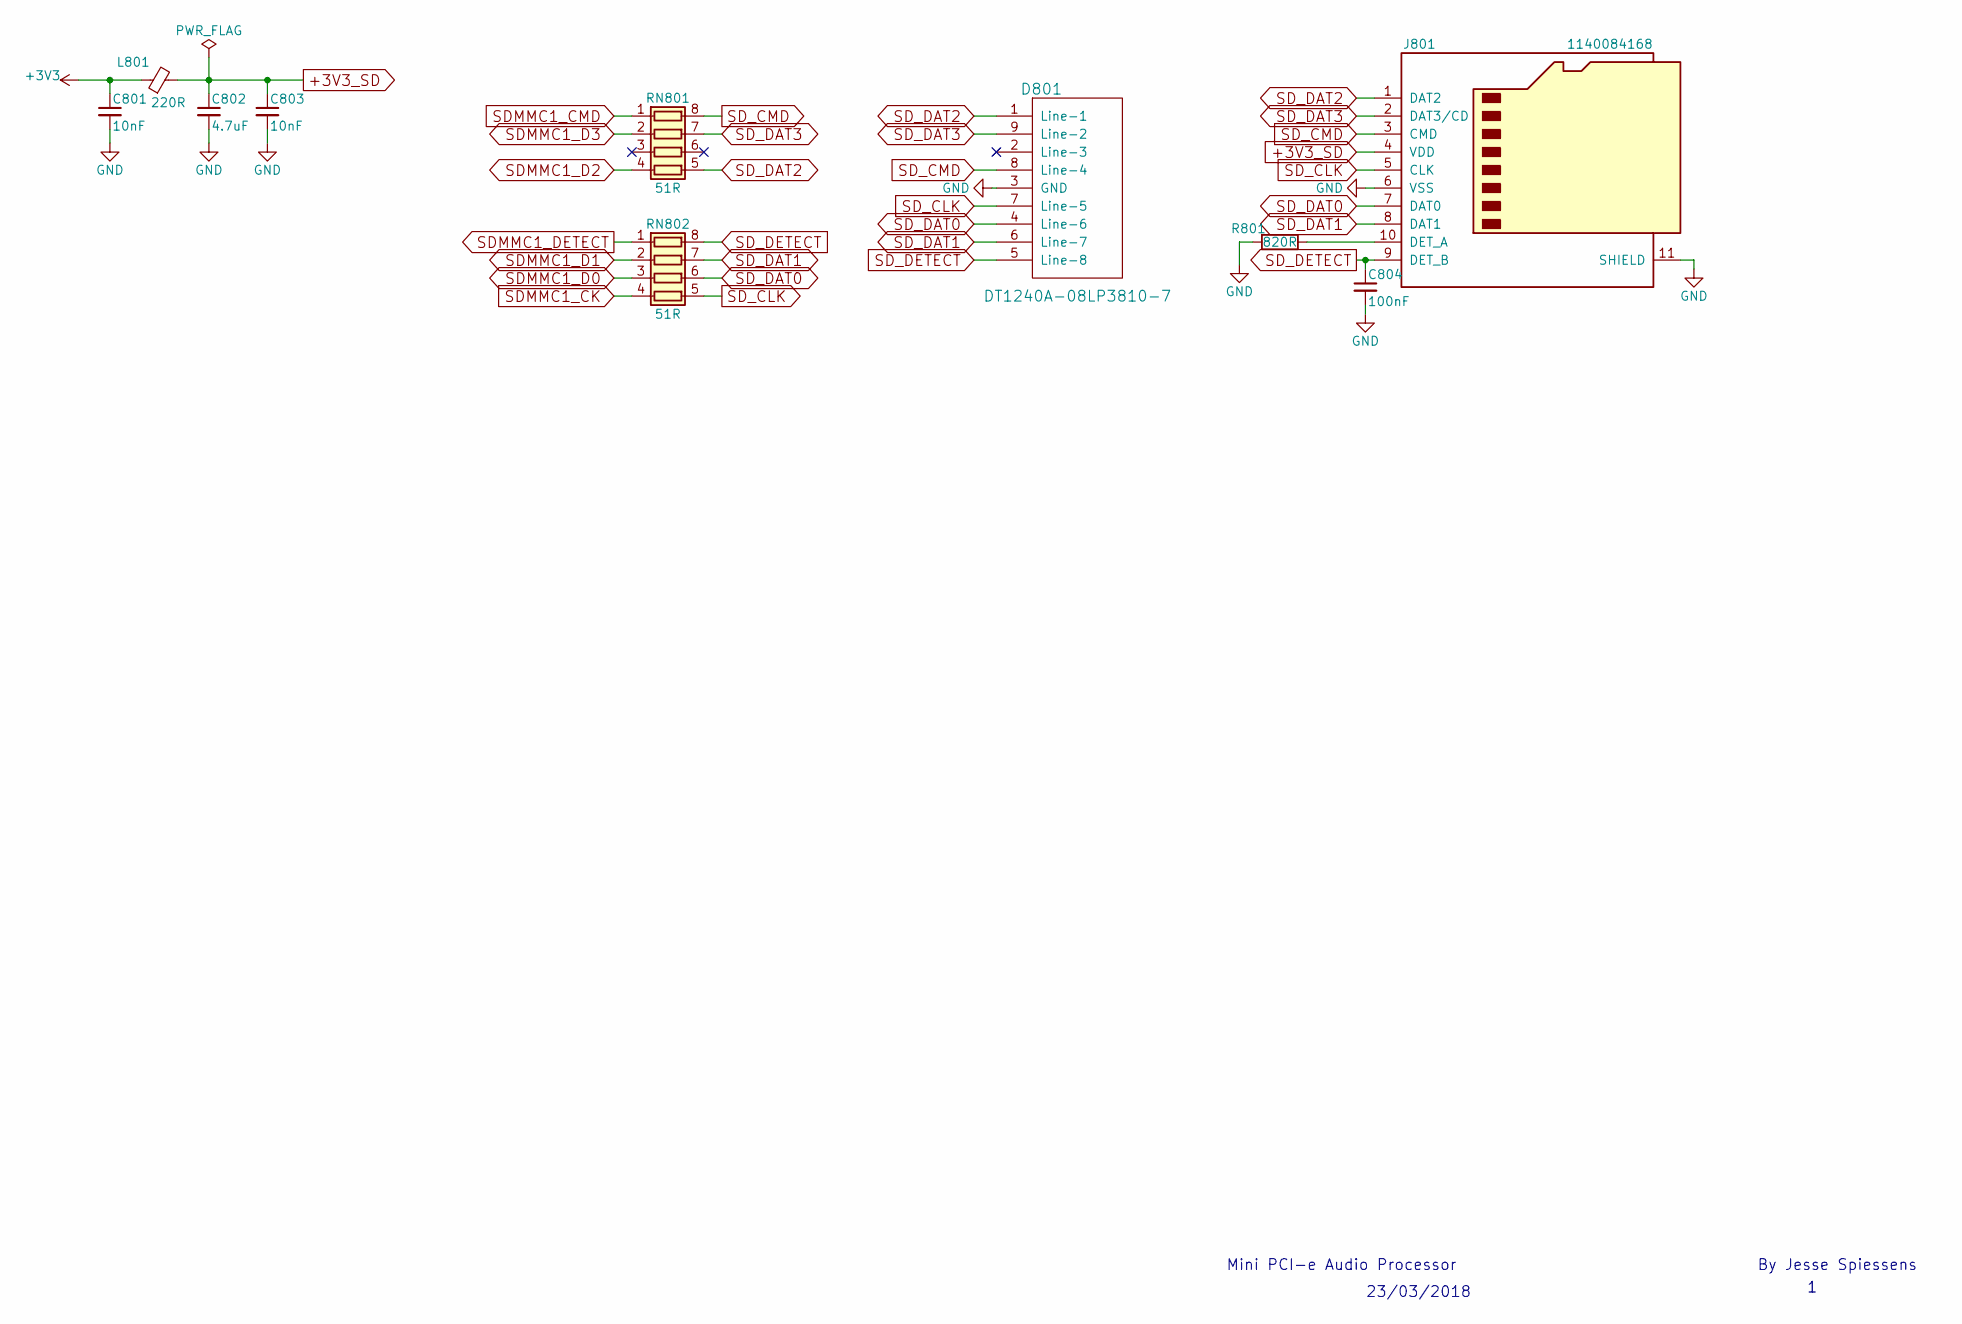
[picture p101: schematic SD.sch]

Parts:
C801, C803: 10nF; C_0603
C802: 4.7uF; C_0805
C804: 100nF; C_0603
D801: DT1240A-08LP3810-7; U-DFN3810-9
J801: 1140084168
L801: 220R; L_0603
R801: 820R; R_0603
RN801, RN802: 51R; 0603_RN4

Connections:
+3V3: C801.1, L801.1; also elsewhere on the board
+3V3_SD: C802.1, C803.1, J801.4 (VDD), L801.2
GND: C801.2, C802.2, C803.2, C804.2, D801.3 (GND), J801.6 (VSS), J801.11 (SHIELD), R801.2; also elsewhere on the board
unnamed: J801.10 (DET_A), R801.1
SDMMC1_CK: RN802.4 (R4.1); also elsewhere on the board
SDMMC1_CMD: RN801.1 (R1.1); also elsewhere on the board
SDMMC1_D0: RN802.3 (R3.1); also elsewhere on the board
SDMMC1_D1: RN802.2 (R2.1); also elsewhere on the board
SDMMC1_D2: RN801.4 (R4.1); also elsewhere on the board
SDMMC1_D3: RN801.2 (R2.1); also elsewhere on the board
SDMMC1_DETECT: RN802.1 (R1.1); also elsewhere on the board
SD_CLK: D801.7 (Line-5), J801.5 (CLK), RN802.5 (R4.2)
SD_CMD: D801.8 (Line-4), J801.3 (CMD), RN801.8 (R1.2)
SD_DAT0: D801.4 (Line-6), J801.7 (DAT0), RN802.6 (R3.2)
SD_DAT1: D801.6 (Line-7), J801.8 (DAT1), RN802.7 (R2.2)
SD_DAT2: D801.1 (Line-1), J801.1 (DAT2), RN801.5 (R4.2)
SD_DAT3: D801.9 (Line-2), J801.2 (DAT3/CD), RN801.7 (R2.2)
SD_DETECT: C804.1, D801.5 (Line-8), J801.9 (DET_B), RN802.8 (R1.2)

Notes on the sheet:
23/03/2018
Mini PCI-e Audio Processor
By Jesse Spiessens

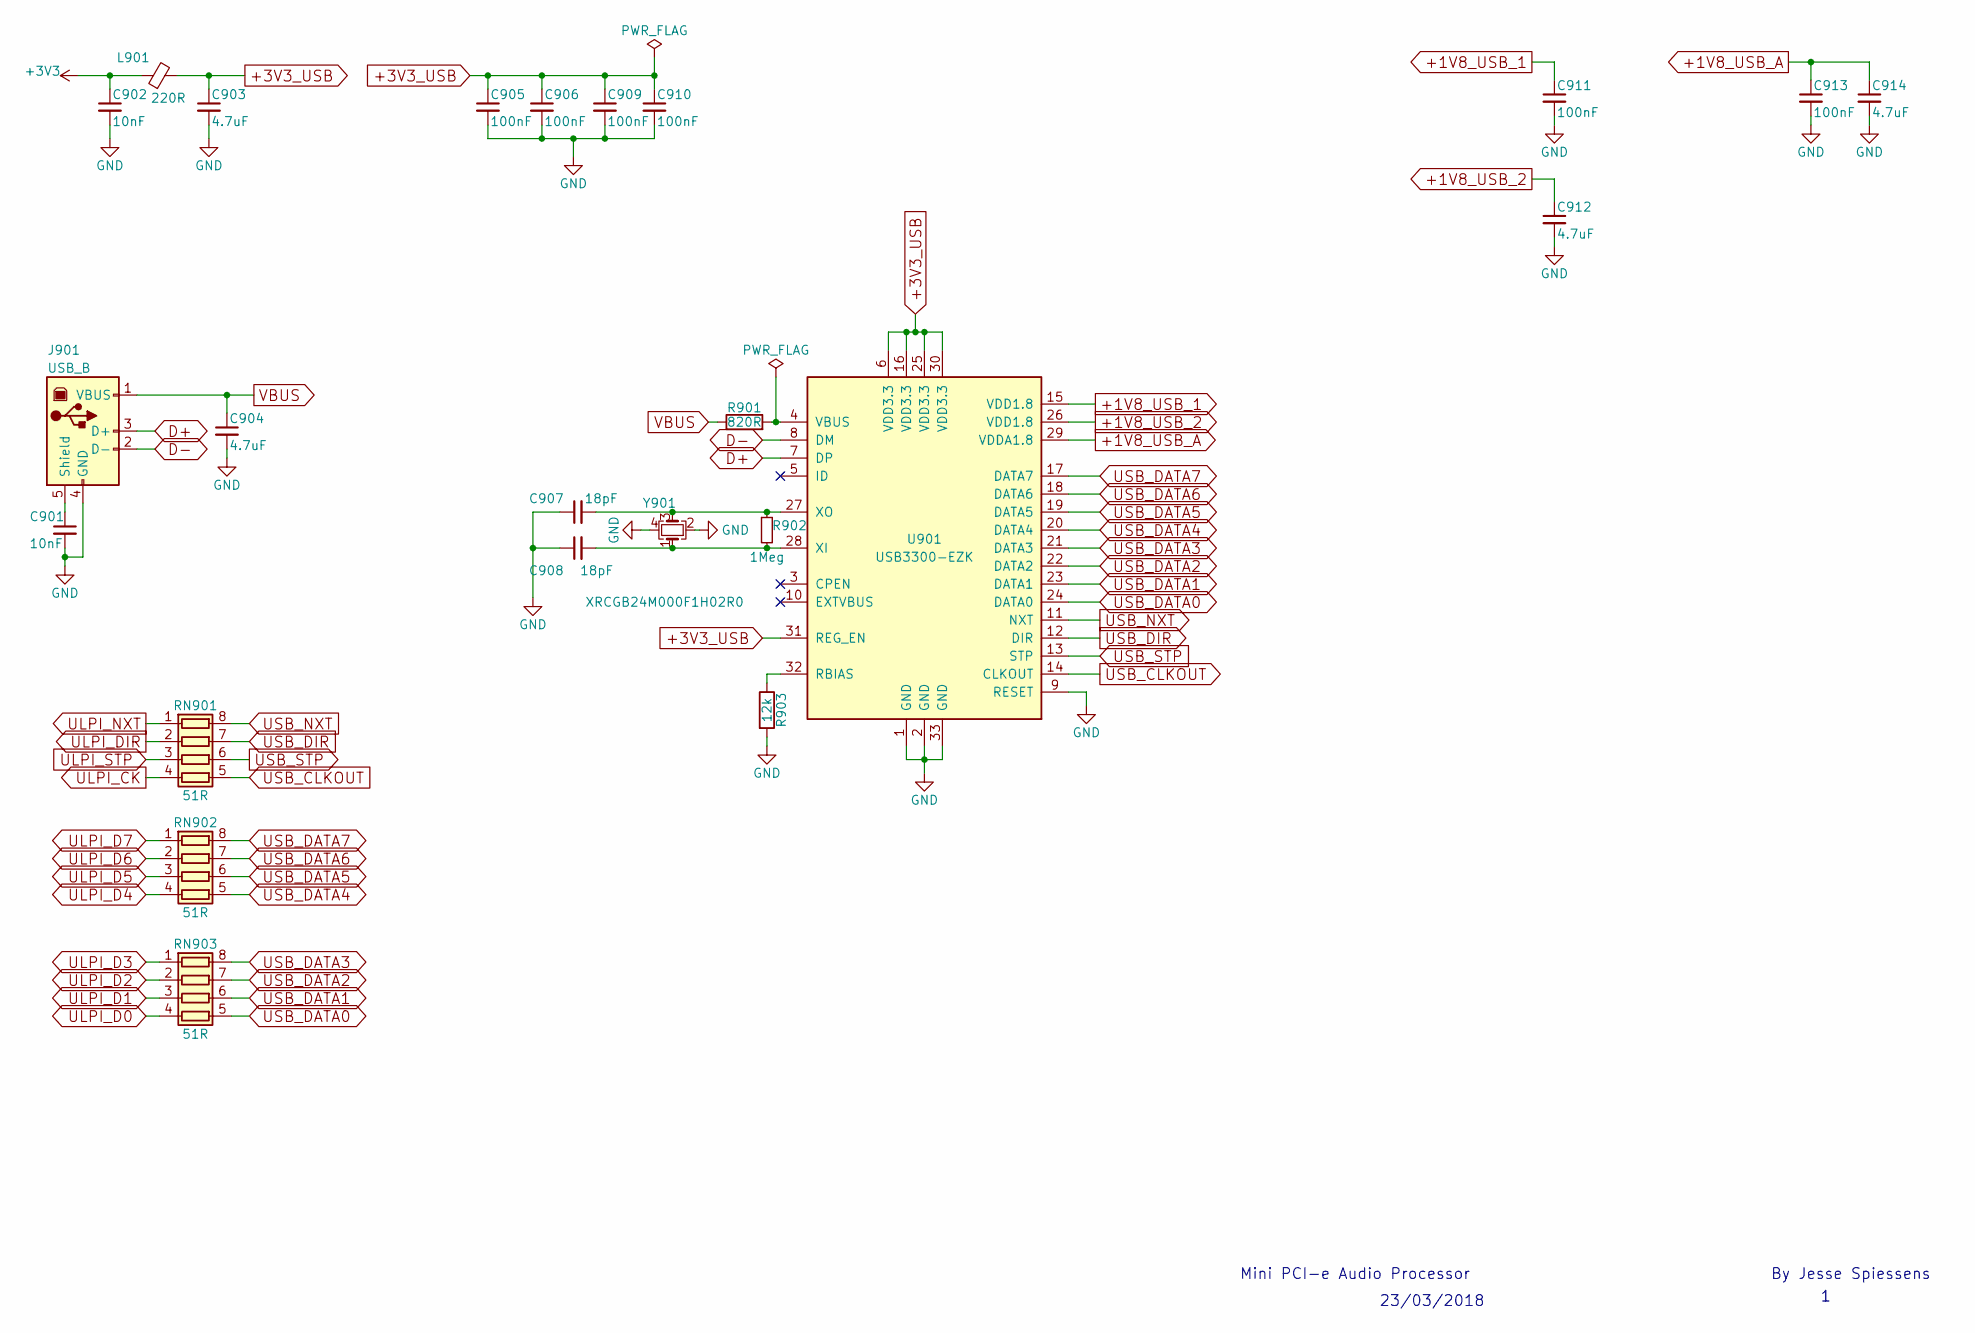
[picture p102: schematic USB.sch]

Parts:
C901, C902: 10nF; C_0603
C903, C904, C912, C914: 4.7uF; C_0805
C905, C906, C909, C910, C911, C913: 100nF; C_0603
C907, C908: 18pF; C_0603
J901: USB_B; USB_B_2.0
L901: 220R; L_0603
R901: 820R; R_0603
R902: 1Meg; R_0603
R903: 12k; R_0603
RN901, RN902, RN903: 51R; 0603_RN4
U901: USB3300-EZK; QFN-32-1EP_5x5mm_Pitch0.5mm
Y901: XRCGB24M000F1H02R0; Crystal_SMD_2016-4pin_2.0x1.6mm

Connections:
+1V8_USB_1: C911.1, U901.15 (VDD1.8)
+1V8_USB_2: C912.1, U901.26 (VDD1.8)
+1V8_USB_A: C913.1, C914.1, U901.29 (VDDA1.8)
+3V3: C902.1, L901.1; also elsewhere on the board
+3V3_USB: C903.1, C905.1, C906.1, C909.1, C910.1, L901.2, U901.6 (VDD3.3), U901.16 (VDD3.3), U901.25 (VDD3.3), U901.30 (VDD3.3), U901.31 (REG_EN)
D+: J901.3 (D+), U901.7 (DP); also elsewhere on the board
D-: J901.2 (D-), U901.8 (DM); also elsewhere on the board
GND: C901.2, C902.2, C903.2, C904.2, C905.2, C906.2, C907.1, C908.1, C909.2, C910.2, C911.2, C912.2, C913.2, C914.2, J901.4 (GND), R903.2, U901.1 (GND), U901.2 (GND), U901.9 (RESET), U901.33 (GND), Y901.2, Y901.4; also elsewhere on the board
unnamed: C901.1, J901.5 (Shield)
unnamed: C907.2, R902.1, U901.27 (XO), Y901.3
unnamed: C908.2, R902.2, U901.28 (XI), Y901.1
unnamed: R901.2, U901.4 (VBUS)
unnamed: R903.1, U901.32 (RBIAS)
ULPI_CK: RN901.4 (R4.1); also elsewhere on the board
ULPI_D0: RN903.4 (R4.1); also elsewhere on the board
ULPI_D1: RN903.3 (R3.1); also elsewhere on the board
ULPI_D2: RN903.2 (R2.1); also elsewhere on the board
ULPI_D3: RN903.1 (R1.1); also elsewhere on the board
ULPI_D4: RN902.4 (R4.1); also elsewhere on the board
ULPI_D5: RN902.3 (R3.1); also elsewhere on the board
ULPI_D6: RN902.2 (R2.1); also elsewhere on the board
ULPI_D7: RN902.1 (R1.1); also elsewhere on the board
ULPI_DIR: RN901.2 (R2.1); also elsewhere on the board
ULPI_NXT: RN901.1 (R1.1); also elsewhere on the board
ULPI_STP: RN901.3 (R3.1); also elsewhere on the board
USB_CLKOUT: RN901.5 (R4.2), U901.14 (CLKOUT)
USB_DATA0: RN903.5 (R4.2), U901.24 (DATA0)
USB_DATA1: RN903.6 (R3.2), U901.23 (DATA1)
USB_DATA2: RN903.7 (R2.2), U901.22 (DATA2)
USB_DATA3: RN903.8 (R1.2), U901.21 (DATA3)
USB_DATA4: RN902.5 (R4.2), U901.20 (DATA4)
USB_DATA5: RN902.6 (R3.2), U901.19 (DATA5)
USB_DATA6: RN902.7 (R2.2), U901.18 (DATA6)
USB_DATA7: RN902.8 (R1.2), U901.17 (DATA7)
USB_DIR: RN901.7 (R2.2), U901.12 (DIR)
USB_NXT: RN901.8 (R1.2), U901.11 (NXT)
USB_STP: RN901.6 (R3.2), U901.13 (STP)
VBUS: C904.1, J901.1 (VBUS), R901.1; also elsewhere on the board

Notes on the sheet:
23/03/2018
Mini PCI-e Audio Processor
By Jesse Spiessens

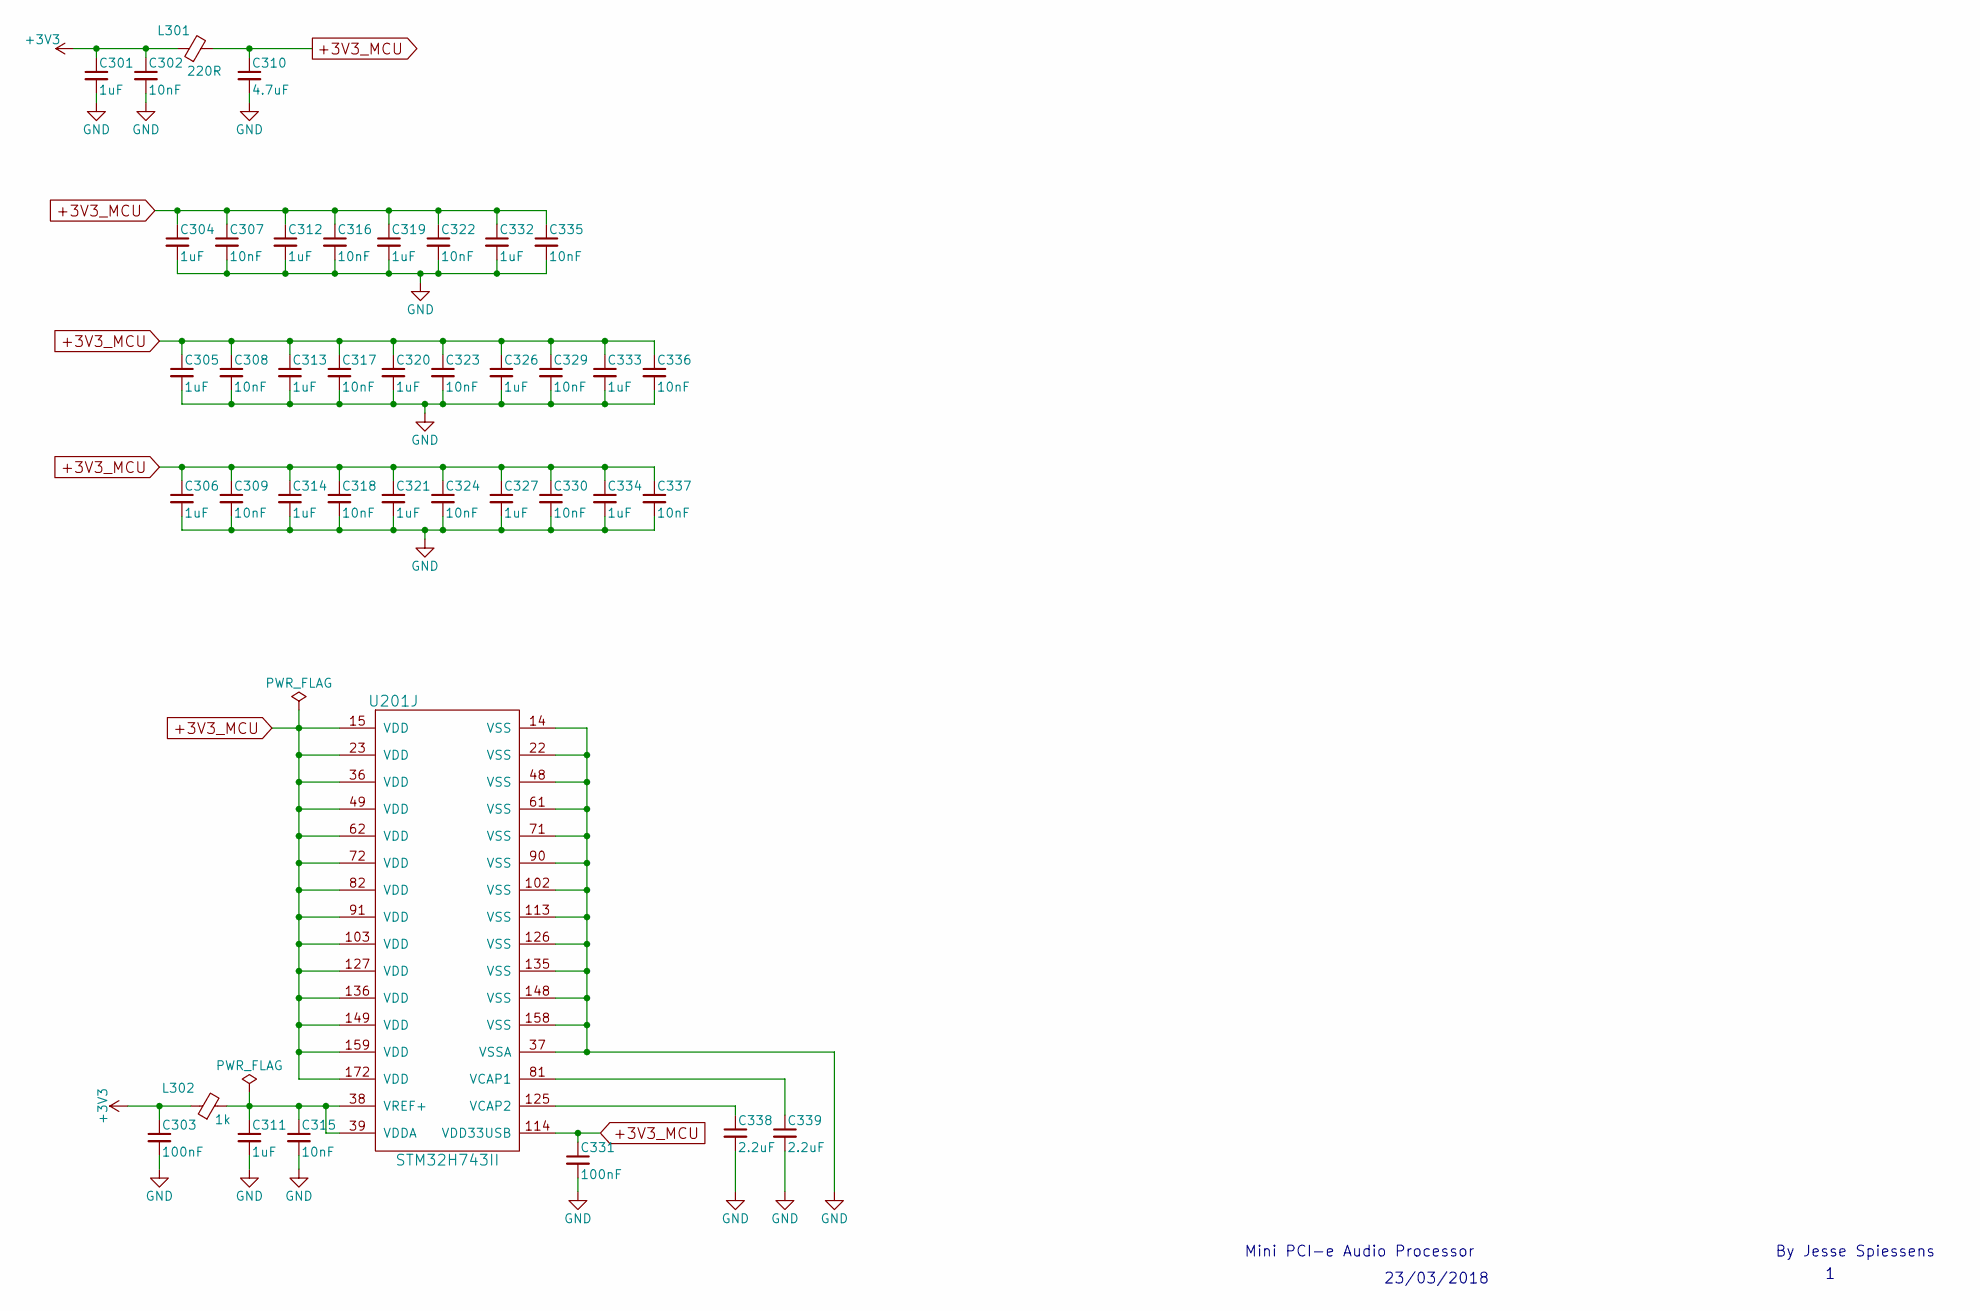
[picture p103: schematic MCU_Power.sch]

Parts:
C301, C304, C305, C306, C311, C312, C313, C314, C319, C320, C321, C326, C327, C332, C333, C334: 1uF; C_0603
C302, C307, C308, C309, C315, C316, C317, C318, C322, C323, C324, C329, C330, C335, C336, C337: 10nF; C_0603
C303, C331: 100nF; C_0603
C310: 4.7uF; C_0805
C338, C339: 2.2uF; C_0603
L301: 220R; L_0603
L302: 1k; L_0603
U201: STM32H743II; LQFP-176_24x24mm_Pitch0.5mm

Connections:
+3V3: C301.1, C302.1, C303.1, L301.1, L302.1; also elsewhere on the board
+3V3_MCU: C304.1, C305.1, C306.1, C307.1, C308.1, C309.1, C310.1, C312.1, C313.1, C314.1, C316.1, C317.1, C318.1, C319.1, C320.1, C321.1, C322.1, C323.1, C324.1, C326.1, C327.1, C329.1, C330.1, C331.1, C332.1, C333.1, C334.1, C335.1, C336.1, C337.1, L301.2, U201.15 (VDD), U201.23 (VDD), U201.36 (VDD), U201.49 (VDD), U201.62 (VDD), U201.72 (VDD), U201.82 (VDD), U201.91 (VDD), U201.103 (VDD), U201.114 (VDD33USB), U201.127 (VDD), U201.136 (VDD), U201.149 (VDD), U201.159 (VDD), U201.172 (VDD); also elsewhere on the board
GND: C301.2, C302.2, C303.2, C304.2, C305.2, C306.2, C307.2, C308.2, C309.2, C310.2, C311.2, C312.2, C313.2, C314.2, C315.2, C316.2, C317.2, C318.2, C319.2, C320.2, C321.2, C322.2, C323.2, C324.2, C326.2, C327.2, C329.2, C330.2, C331.2, C332.2, C333.2, C334.2, C335.2, C336.2, C337.2, C338.2, C339.2, U201.14 (VSS), U201.22 (VSS), U201.37 (VSSA), U201.48 (VSS), U201.61 (VSS), U201.71 (VSS), U201.90 (VSS), U201.102 (VSS), U201.113 (VSS), U201.126 (VSS), U201.135 (VSS), U201.148 (VSS), U201.158 (VSS); also elsewhere on the board
unnamed: C311.1, C315.1, L302.2, U201.38 (VREF+), U201.39 (VDDA)
unnamed: C338.1, U201.125 (VCAP2)
unnamed: C339.1, U201.81 (VCAP1)

Notes on the sheet:
23/03/2018
Mini PCI-e Audio Processor
By Jesse Spiessens

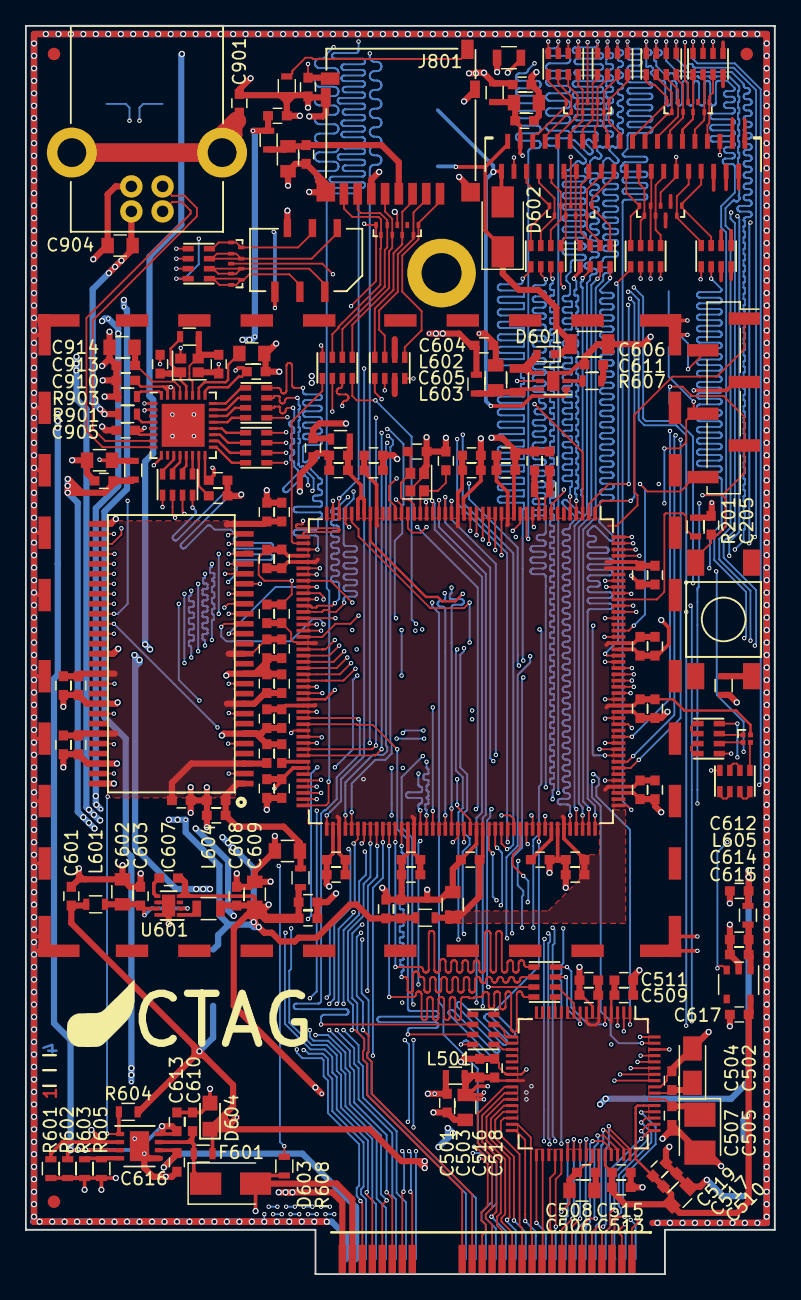
[picture p104: board Main board.kicad_pcb from above]

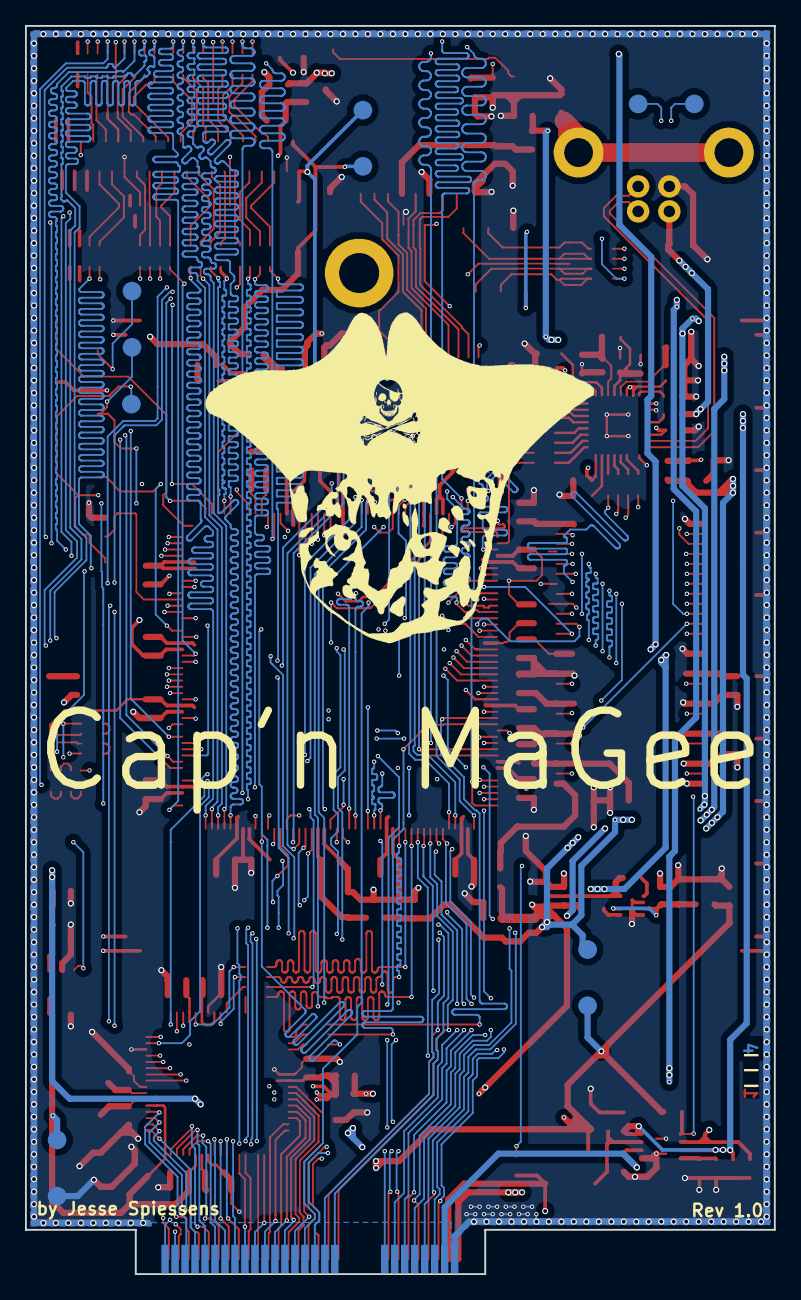
[picture p105: board Main board.kicad_pcb from below]

Board: 4 copper layers, 60.0 x 100.0 mm, 202 parts (11 on the bottom side), 269 nets.
