Tyrsz/Audio_Processor/PCB/IO board/Audio board.kicad_pcb

## KiCad design PCB/IO board/Audio board.kicad_pcb (2018-05-08)

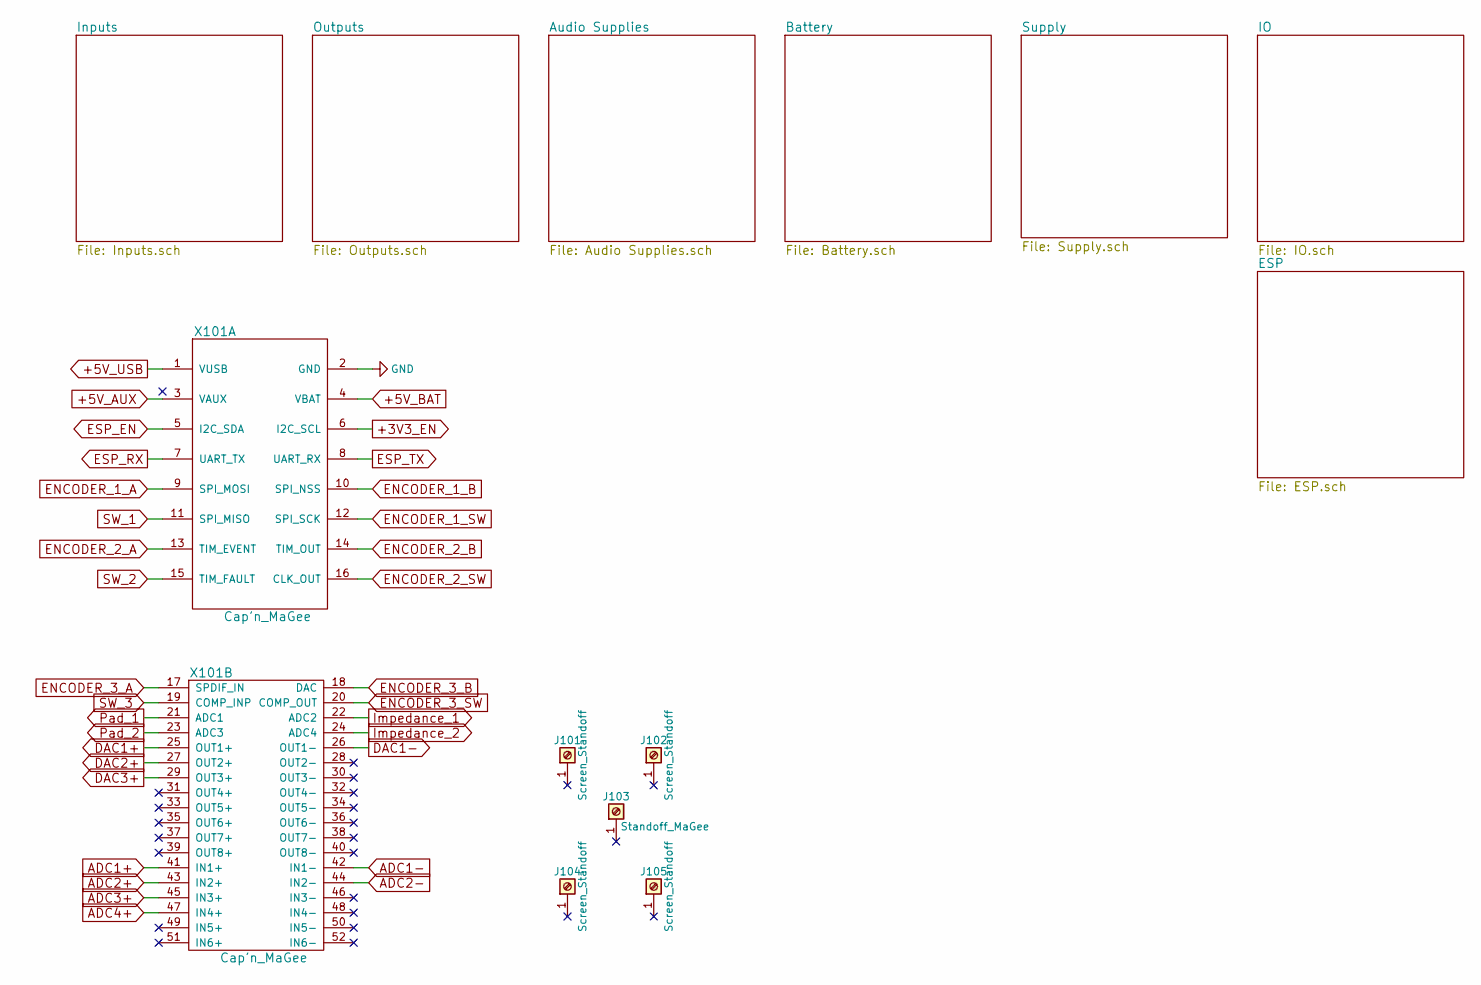
[picture p106: schematic Audio board.sch]

Parts:
J101, J102, J104, J105: Screen_Standoff; HARWIN_R30-1001002
J103: Standoff_MaGee; Keystone_1560A
X101: Cap'n_MaGee; Mini_PCI-e_Female

Connections:
+3V3_EN: X101.6 (I2C_SCL); also elsewhere on the board
+5V_AUX: X101.3 (VAUX); also elsewhere on the board
+5V_BAT: X101.4 (VBAT); also elsewhere on the board
+5V_USB: X101.1 (VUSB); also elsewhere on the board
ADC1+: X101.41 (IN1+); also elsewhere on the board
ADC1-: X101.42 (IN1-); also elsewhere on the board
ADC2+: X101.43 (IN2+); also elsewhere on the board
ADC2-: X101.44 (IN2-); also elsewhere on the board
ADC3+: X101.45 (IN3+); also elsewhere on the board
ADC4+: X101.47 (IN4+); also elsewhere on the board
DAC1+: X101.25 (OUT1+); also elsewhere on the board
DAC1-: X101.26 (OUT1-); also elsewhere on the board
DAC2+: X101.27 (OUT2+); also elsewhere on the board
DAC3+: X101.29 (OUT3+); also elsewhere on the board
ENCODER_1_A: X101.9 (SPI_MOSI); also elsewhere on the board
ENCODER_1_B: X101.10 (SPI_NSS); also elsewhere on the board
ENCODER_1_SW: X101.12 (SPI_SCK); also elsewhere on the board
ENCODER_2_A: X101.13 (TIM_EVENT); also elsewhere on the board
ENCODER_2_B: X101.14 (TIM_OUT); also elsewhere on the board
ENCODER_2_SW: X101.16 (CLK_OUT); also elsewhere on the board
ENCODER_3_A: X101.17 (SPDIF_IN); also elsewhere on the board
ENCODER_3_B: X101.18 (DAC); also elsewhere on the board
ENCODER_3_SW: X101.20 (COMP_OUT); also elsewhere on the board
ESP_EN: X101.5 (I2C_SDA); also elsewhere on the board
ESP_RX: X101.7 (UART_TX); also elsewhere on the board
ESP_TX: X101.8 (UART_RX); also elsewhere on the board
GND: X101.2 (GND); also elsewhere on the board
Impedance_1: X101.22 (ADC2); also elsewhere on the board
Impedance_2: X101.24 (ADC4); also elsewhere on the board
Pad_1: X101.21 (ADC1); also elsewhere on the board
Pad_2: X101.23 (ADC3); also elsewhere on the board
SW_1: X101.11 (SPI_MISO); also elsewhere on the board
SW_2: X101.15 (TIM_FAULT); also elsewhere on the board
SW_3: X101.19 (COMP_INP); also elsewhere on the board

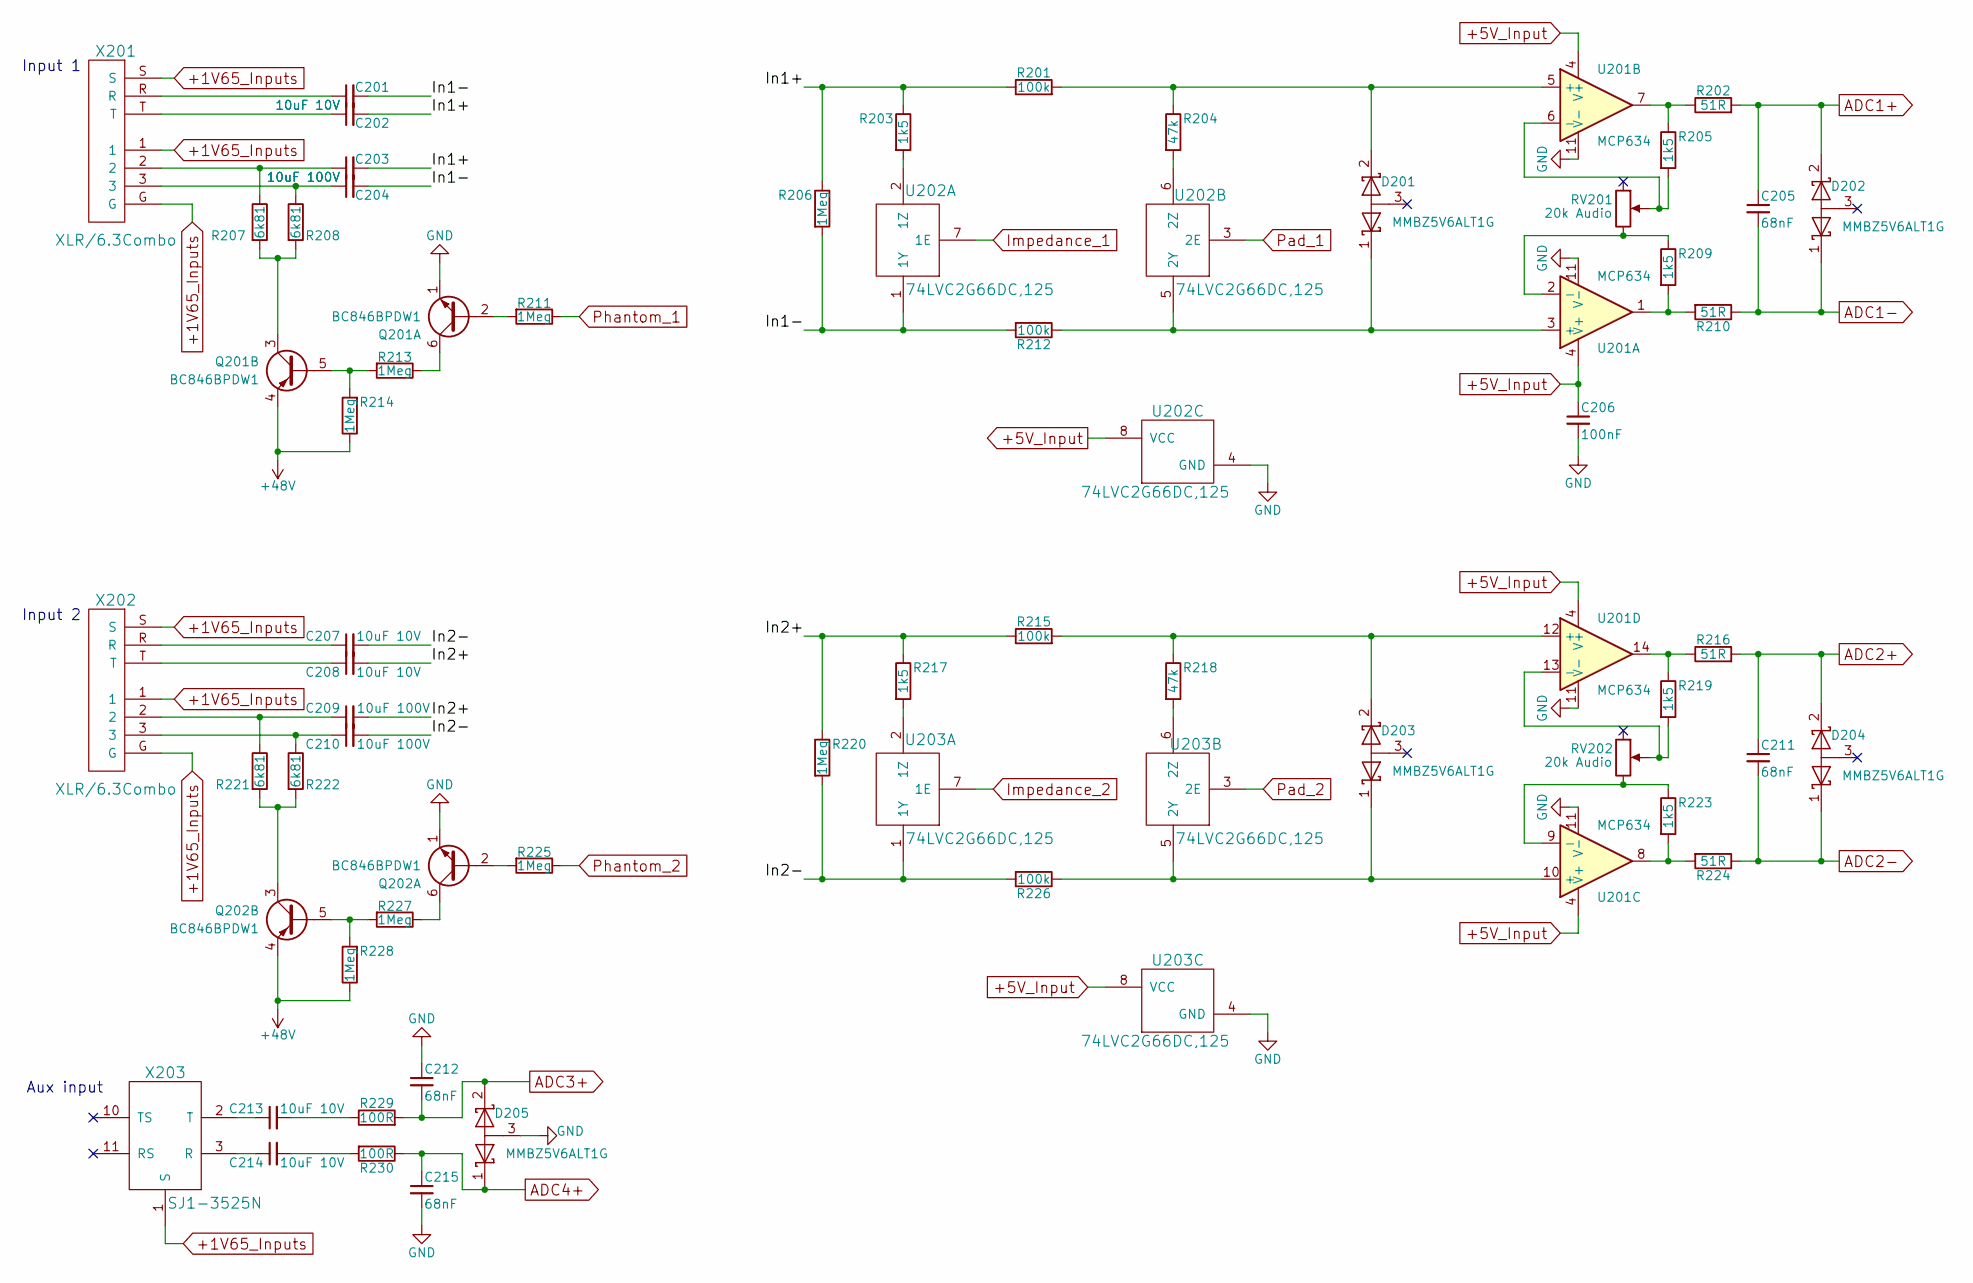
[picture p107: schematic Inputs.sch]

Parts:
C201, C202, C207, C208, C213, C214: 10uF 10V; CP_Elec_4x5.3
C203, C204, C209, C210: 10uF 100V; CP_Radial_D8.0mm_P3.50mm
C205, C211, C212, C215: 68nF; C_Rect_L7.5mm_W6.5mm_P5.00mm
C206: 100nF; C_0603
D201, D202, D203, D204, D205: MMBZ5V6ALT1G; SOT-23
Q201, Q202: BC846BPDW1; SOT-363_SC-70-6_Handsoldering
R201, R212, R215, R226: 100k; R_0603
R202, R210, R216, R224: 51R; R_0603
R203, R205, R209, R217, R219, R223: 1k5; R_0603
R204, R218: 47k; R_0603
R206, R211, R213, R214, R220, R225, R227, R228: 1Meg; R_0603
R207, R208, R221, R222: 6k81; R_0603
R229, R230: 100R; R_0603
RV201, RV202: 20k Audio; P140KH1
U201: MCP634; TSSOP-14_4.4x5mm_Pitch0.65mm
U202, U203: 74LVC2G66DC,125; VSSOP-8_2.4x2.1mm_Pitch0.5mm
X201, X202: XLR/6.3Combo; NCJ6FA-H-0
X203: SJ1-3525N; SJ1-352xN

Connections:
+1V65_Inputs: X201.1, X201.G, X201.S, X202.1, X202.G, X202.S, X203.1 (S); also elsewhere on the board
+5V_Input: C206.1, U201.4 (V+), U202.8 (VCC), U203.8 (VCC); also elsewhere on the board
+48V: Q201.4 (E2), Q202.4 (E2), R214.1, R228.1; also elsewhere on the board
/Inputs/In1+: C202.2, C203.2, R201.1, R203.1, R206.1
/Inputs/In1-: C201.2, C204.2, R206.2, R212.2, U202.1 (1Y)
/Inputs/In2+: C208.2, C209.2, R215.1, R217.1, R220.1
/Inputs/In2-: C207.2, C210.2, R220.2, R226.2, U203.1 (1Y)
ADC1+: C205.1, D202.2 (K), R202.2; also elsewhere on the board
ADC1-: C205.2, D202.1 (K), R210.1; also elsewhere on the board
ADC2+: C211.1, D204.2 (K), R216.2; also elsewhere on the board
ADC2-: C211.2, D204.1 (K), R224.1; also elsewhere on the board
ADC3+: C212.2, D205.2 (K), R229.2; also elsewhere on the board
ADC4+: C215.1, D205.1 (K), R230.1; also elsewhere on the board
GND: C206.2, C212.1, C215.2, D205.3 (A), Q201.1 (E1), Q202.1 (E1), U201.11 (V-), U202.4 (GND), U203.4 (GND); also elsewhere on the board
Impedance_1: U202.7 (1E); also elsewhere on the board
Impedance_2: U203.7 (1E); also elsewhere on the board
unnamed: C201.1, X201.R
unnamed: C202.1, X201.T
unnamed: C203.1, R207.1, X201.2
unnamed: C204.1, R208.1, X201.3
unnamed: C207.1, X202.R
unnamed: C208.1, X202.T
unnamed: C209.1, R221.1, X202.2
unnamed: C210.1, R222.1, X202.3
unnamed: C213.1, X203.2 (T)
unnamed: C213.2, R229.1
unnamed: C214.1, X203.3 (R)
unnamed: C214.2, R230.2
unnamed: D201.1 (K), R212.1, U201.3 (+), U202.5 (2Y)
unnamed: D201.2 (K), R201.2, R204.1, U201.5 (+)
unnamed: D203.1 (K), R226.1, U201.10 (+), U203.5 (2Y)
unnamed: D203.2 (K), R215.2, R218.1, U201.12 (+)
unnamed: Q201.2 (B1), R211.2
unnamed: Q201.3 (C2), R207.2, R208.2
unnamed: Q201.5 (B2), R213.2, R214.2
unnamed: Q201.6 (C1), R213.1
unnamed: Q202.2 (B1), R225.2
unnamed: Q202.3 (C2), R221.2, R222.2
unnamed: Q202.5 (B2), R227.2, R228.2
unnamed: Q202.6 (C1), R227.1
unnamed: R202.1, R205.1, U201.7
unnamed: R203.2, U202.2 (1Z)
unnamed: R204.2, U202.6 (2Z)
unnamed: R205.2, RV201.2, U201.6 (-)
unnamed: R209.1, RV201.3, U201.2 (-)
unnamed: R209.2, R210.2, U201.1
unnamed: R216.1, R219.1, U201.14
unnamed: R217.2, U203.2 (1Z)
unnamed: R218.2, U203.6 (2Z)
unnamed: R219.2, RV202.2, U201.13 (-)
unnamed: R223.1, RV202.3, U201.9 (-)
unnamed: R223.2, R224.2, U201.8
Pad_1: U202.3 (2E); also elsewhere on the board
Pad_2: U203.3 (2E); also elsewhere on the board
Phantom_1: R211.1; also elsewhere on the board
Phantom_2: R225.1; also elsewhere on the board

Notes on the sheet:
Aux input
Input 2
Input 1

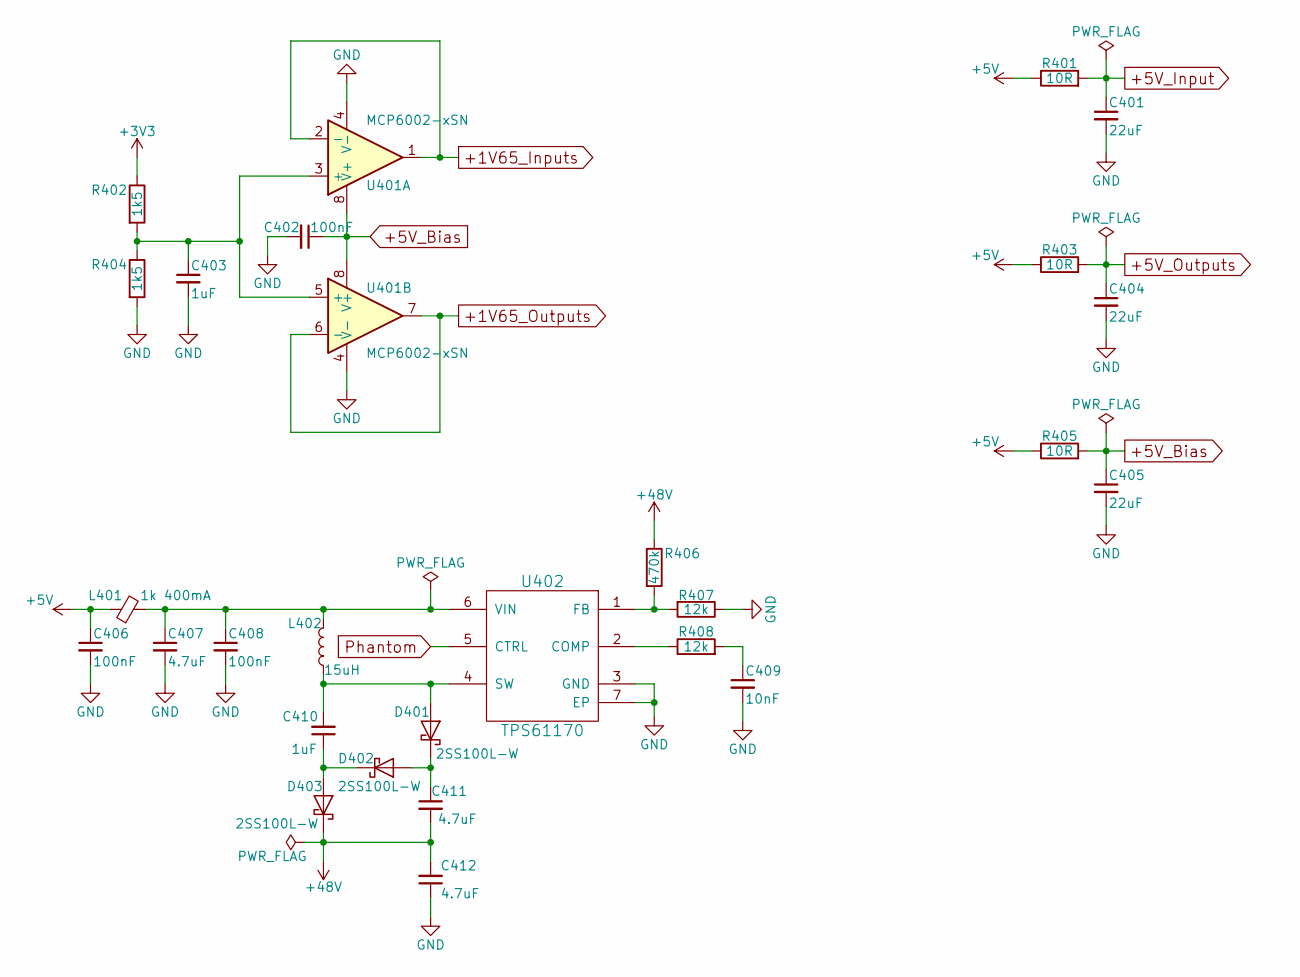
[picture p108: schematic Audio Supplies.sch]

Parts:
C401, C404, C405: 22uF; C_0805
C402, C406, C408: 100nF; C_0603
C403: 1uF; C_0603
C407, C411, C412: 4.7uF; C_0805
C409: 10nF; C_0603
C410: 1uF; C_1206
D401, D402, D403: 2SS100L-W; D_SOD-123F
L401: 1k 400mA; L_0603
L402: 15uH; L_0805
R401, R403, R405: 10R; R_0805
R402, R404: 1k5; R_0603
R406: 470k; R_0603
R407, R408: 12k; R_0603
U401: MCP6002-xSN; SOIC-8_3.9x4.9mm_Pitch1.27mm
U402: TPS61170; DFN-6-1EP_2x2mm_Pitch0.65mm

Connections:
+1V65_Inputs: U401.1, U401.2 (-); also elsewhere on the board
+1V65_Outputs: U401.6 (-), U401.7; also elsewhere on the board
+3V3: R402.1; also elsewhere on the board
+5V: C406.1, L401.1, R401.1, R403.1, R405.1; also elsewhere on the board
+5V_Bias: C402.1, C405.1, R405.2, U401.8 (V+)
+5V_Input: C401.1, R401.2; also elsewhere on the board
+5V_Outputs: C404.1, R403.2; also elsewhere on the board
+48V: C411.2, C412.2, D403.1 (K), R406.1; also elsewhere on the board
GND: C401.2, C402.2, C403.2, C404.2, C405.2, C406.2, C407.2, C408.2, C409.2, C412.1, R404.2, R407.1, U401.4 (V-), U402.3 (GND), U402.7 (EP); also elsewhere on the board
unnamed: C403.1, R402.2, R404.1, U401.3 (+), U401.5 (+)
unnamed: C407.1, C408.1, L401.2, L402.2, U402.6 (VIN)
unnamed: C409.1, R408.2
unnamed: C410.1, D402.1 (K), D403.2 (A)
unnamed: C410.2, D401.2 (A), L402.1, U402.4 (SW)
unnamed: C411.1, D401.1 (K), D402.2 (A)
unnamed: R406.2, R407.2, U402.1 (FB)
unnamed: R408.1, U402.2 (COMP)
Phantom: U402.5 (CTRL); also elsewhere on the board

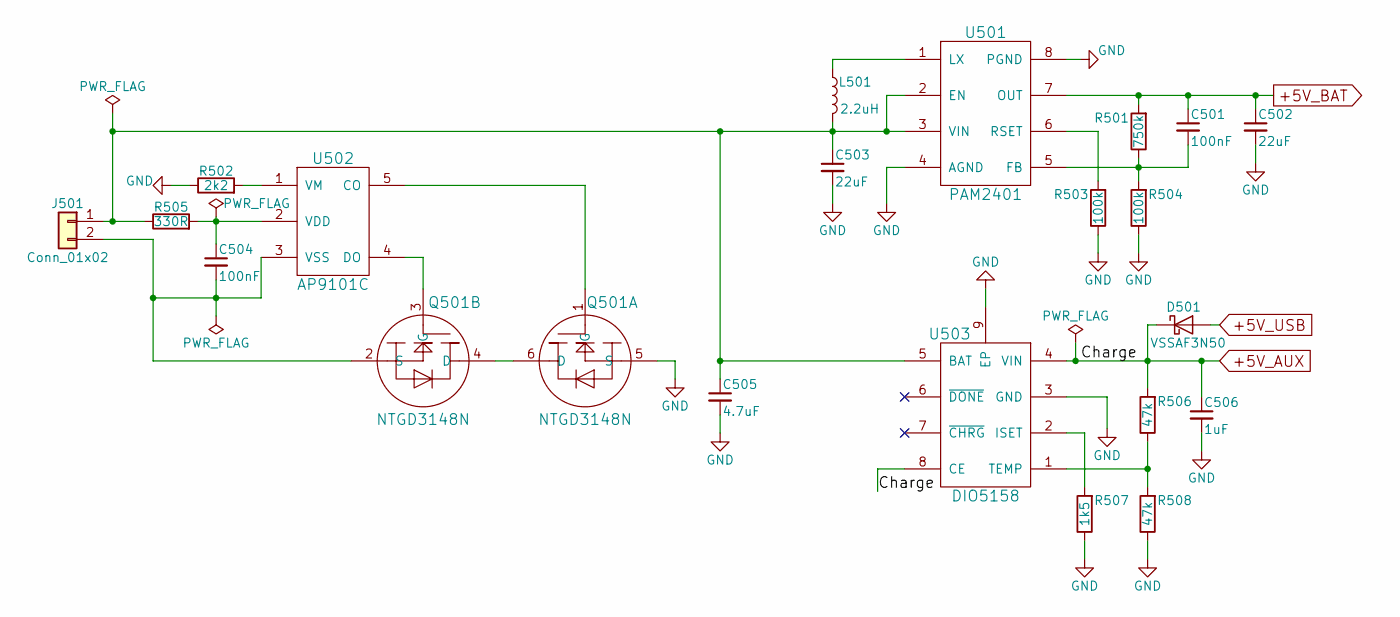
[picture p109: schematic Battery.sch]

Parts:
C501, C504: 100nF; C_0603
C502, C503: 22uF; C_0805
C505: 4.7uF; C_0805
C506: 1uF; C_0603
D501: VSSAF3N50; D_SMA
J501: Conn_01x02; Phoenix_1751765
L501: 2.2uH; L-1008
Q501: NTGD3148N; TSOP-6_1.65x3.05mm_Pitch0.95mm
R501: 750k; R_0603
R502: 2k2; R_0603
R503, R504: 100k; R_0603
R505: 330R; R_0603
R506, R508: 47k; R_0603
R507: 1k5; R_0603
U501: PAM2401; MSOP-8_3x3mm_Pitch0.65mm
U502: AP9101C; SOT-23-5
U503: DIO5158; MSOP-8-1EP_3x3mm_Pitch0.65mm

Connections:
+5V_AUX: C506.1, D501.1 (K), R506.2, U503.4 (VIN), U503.8 (CE); also elsewhere on the board
+5V_BAT: C501.1, C502.1, R501.2, U501.7 (OUT); also elsewhere on the board
+5V_USB: D501.2 (A); also elsewhere on the board
GND: C502.2, C503.2, C505.2, C506.2, Q501.5 (S), R502.1, R503.1, R504.1, R507.1, R508.1, U501.4 (AGND), U501.8 (PGND), U503.3 (GND), U503.9 (EP); also elsewhere on the board
unnamed: C501.2, R501.1, R504.2, U501.5 (FB)
unnamed: C503.1, C505.1, J501.1, L501.2, R505.1, U501.2 (EN), U501.3 (VIN), U503.5 (BAT)
unnamed: C504.1, R505.2, U502.2 (VDD)
unnamed: C504.2, J501.2, Q501.2 (S), U502.3 (VSS)
unnamed: L501.1, U501.1 (LX)
unnamed: Q501.1 (G), U502.5 (CO)
unnamed: Q501.3 (G), U502.4 (DO)
unnamed: Q501.4 (D), Q501.6 (D)
unnamed: R502.2, U502.1 (VM)
unnamed: R503.2, U501.6 (RSET)
unnamed: R506.1, R508.2, U503.1 (TEMP)
unnamed: R507.2, U503.2 (ISET)

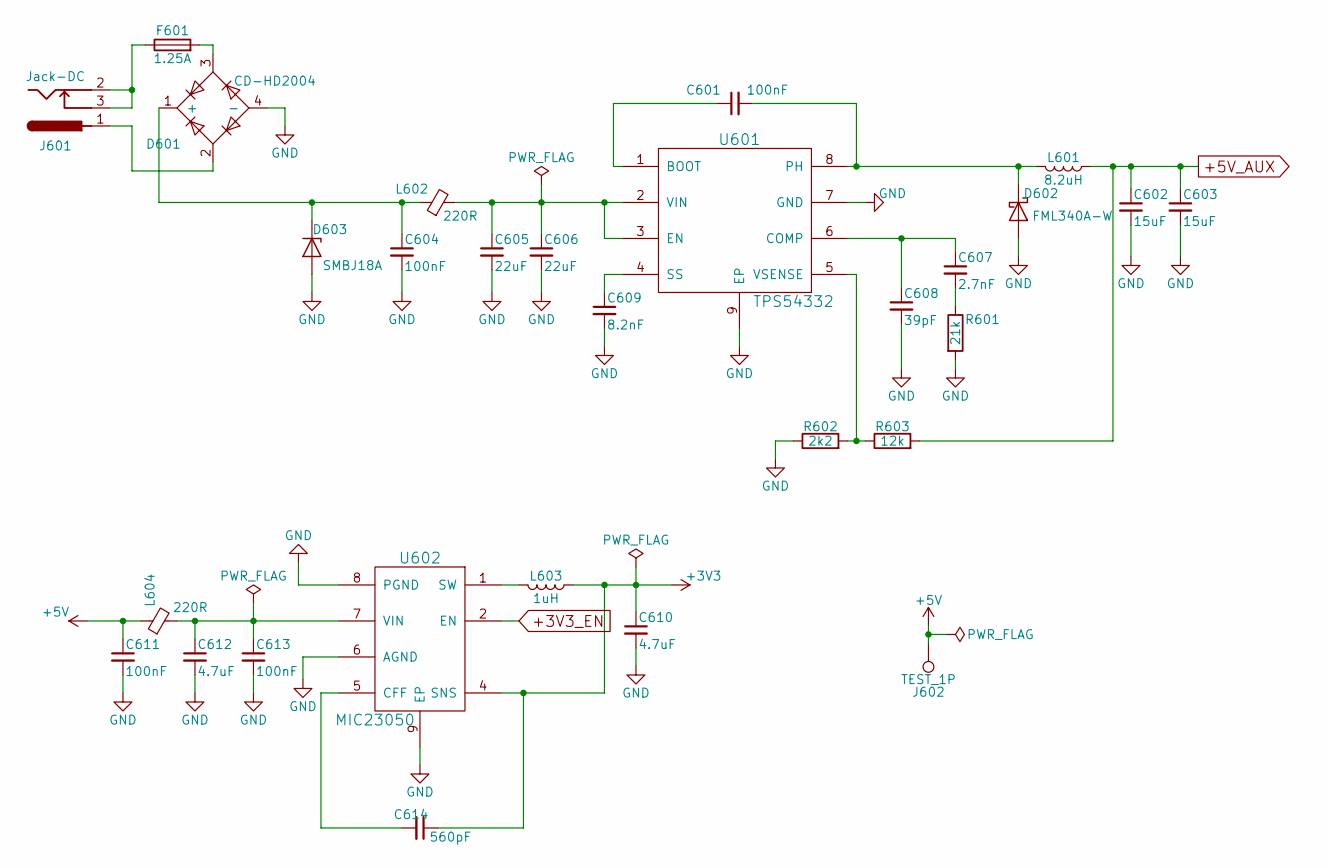
[picture p110: schematic Supply.sch]

Parts:
C601, C604, C611, C613: 100nF; C_0603
C602, C603: 15uF; C_0603
C605, C606: 22uF; C_1210
C607: 2.7nF; C_0603
C608: 39pF; C_0603
C609: 8.2nF; C_0603
C610, C612: 4.7uF; C_0805
C614: 560pF; C_0603
D601: CD-HD2004; SMD-4
D602: FML340A-W; D_SMA
D603: SMBJ18A; D_SMB
F601: 1.25A; R_0603
J601: Jack-DC; BARREL_JACK
J602: TEST_1P; Mill-Max_0990
L601: 8.2uH; L_Taiyo-Yuden_NR-60xx_HandSoldering
L602, L604: 220R; L_0603
L603: 1uH; L_0805
R601: 21k; R_0603
R602: 2k2; R_0603
R603: 12k; R_0603
U601: TPS54332; TI_SO-PowerPAD-8_ThermalVias
U602: MIC23050; DFN-8-1EP_2x2mm_Pitch0.5mm

Connections:
+3V3: C610.1, C614.1, L603.1, U602.4 (SNS); also elsewhere on the board
+3V3_EN: U602.2 (EN); also elsewhere on the board
+5V: C611.1, J602.1, L604.1; also elsewhere on the board
+5V_AUX: C602.1, C603.1, L601.1, R603.2; also elsewhere on the board
GND: C602.2, C603.2, C604.2, C605.2, C606.2, C608.2, C609.2, C610.2, C611.2, C612.2, C613.2, D601.4 (-), D602.2 (A), D603.2 (A), R601.2, R602.1, U601.7 (GND), U601.9 (EP), U602.6 (AGND), U602.8 (PGND), U602.9 (EP); also elsewhere on the board
unnamed: C601.1, U601.1 (BOOT)
unnamed: C601.2, D602.1 (K), L601.2, U601.8 (PH)
unnamed: C604.1, D601.1 (+), D603.1 (K), L602.1
unnamed: C605.1, C606.1, L602.2, U601.2 (VIN), U601.3 (EN)
unnamed: C607.1, C608.1, U601.6 (COMP)
unnamed: C607.2, R601.1
unnamed: C609.1, U601.4 (SS)
unnamed: C612.1, C613.1, L604.2, U602.7 (VIN)
unnamed: C614.2, U602.5 (CFF)
unnamed: D601.2, J601.1
unnamed: D601.3, F601.2
unnamed: F601.1, J601.2, J601.3
unnamed: L603.2, U602.1 (SW)
unnamed: R602.2, R603.1, U601.5 (VSENSE)

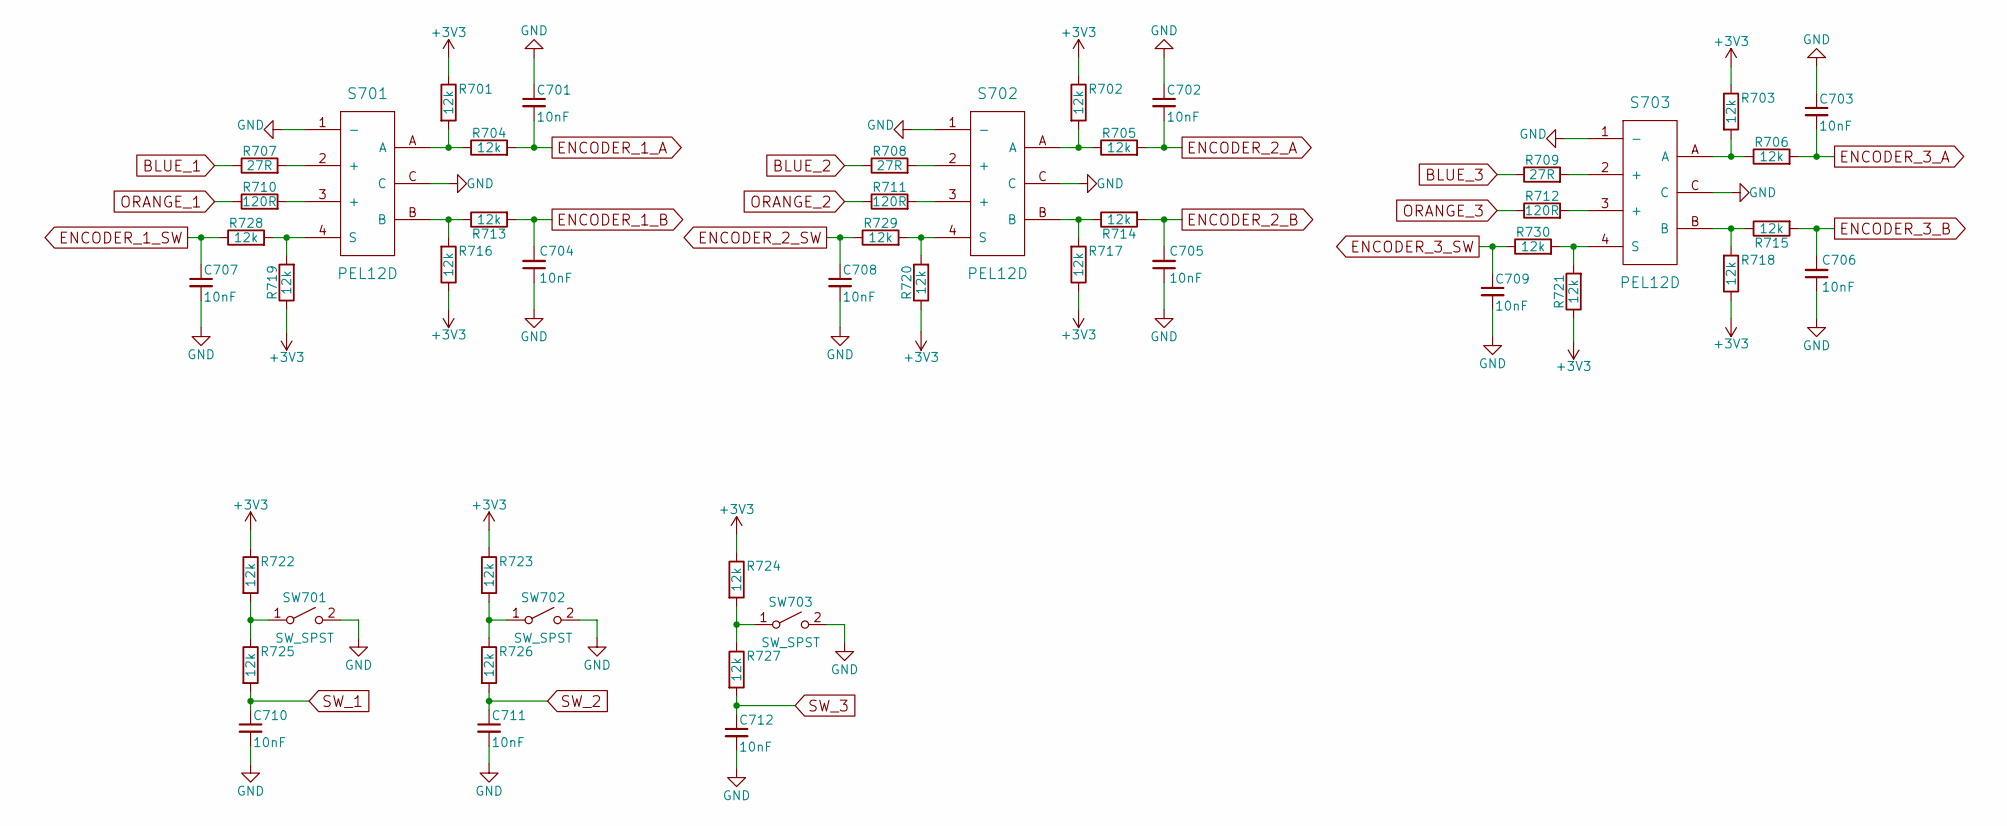
[picture p111: schematic IO.sch]

Parts:
C701, C702, C703, C704, C705, C706, C707, C708, C709, C710, C711, C712: 10nF; C_0603
R701, R702, R703, R704, R705, R706, R713, R714, R715, R716, R717, R718, R719, R720, R721, R722, R723, R724, R725, R726, R727, R728, R729, R730: 12k; R_0603
R707, R708, R709: 27R; R_0603
R710, R711, R712: 120R; R_0603
S701, S702, S703: PEL12D; PEL12D-4xxxS
SW701, SW702, SW703: SW_SPST; PS1024A

Connections:
+3V3: R701.1, R702.1, R703.1, R716.1, R717.1, R718.1, R719.1, R720.1, R721.1, R722.1, R723.1, R724.1; also elsewhere on the board
BLUE_1: R707.1; also elsewhere on the board
BLUE_2: R708.1; also elsewhere on the board
BLUE_3: R709.1; also elsewhere on the board
ENCODER_1_A: C701.2, R704.2; also elsewhere on the board
ENCODER_1_B: C704.2, R713.2; also elsewhere on the board
ENCODER_1_SW: C707.1, R728.1; also elsewhere on the board
ENCODER_2_A: C702.2, R705.2; also elsewhere on the board
ENCODER_2_B: C705.2, R714.2; also elsewhere on the board
ENCODER_2_SW: C708.1, R729.1; also elsewhere on the board
ENCODER_3_A: C703.2, R706.2; also elsewhere on the board
ENCODER_3_B: C706.2, R715.2; also elsewhere on the board
ENCODER_3_SW: C709.1, R730.1; also elsewhere on the board
GND: C701.1, C702.1, C703.1, C704.1, C705.1, C706.1, C707.2, C708.2, C709.2, C710.2, C711.2, C712.2, S701.1 (-), S701.C, S702.1 (-), S702.C, S703.1 (-), S703.C, SW701.2 (B), SW702.2 (B), SW703.2 (B); also elsewhere on the board
unnamed: R701.2, R704.1, S701.A
unnamed: R702.2, R705.1, S702.A
unnamed: R703.2, R706.1, S703.A
unnamed: R707.2, S701.2 (+)
unnamed: R708.2, S702.2 (+)
unnamed: R709.2, S703.2 (+)
unnamed: R710.2, S701.3 (+)
unnamed: R711.2, S702.3 (+)
unnamed: R712.2, S703.3 (+)
unnamed: R713.1, R716.2, S701.B
unnamed: R714.1, R717.2, S702.B
unnamed: R715.1, R718.2, S703.B
unnamed: R719.2, R728.2, S701.4 (S)
unnamed: R720.2, R729.2, S702.4 (S)
unnamed: R721.2, R730.2, S703.4 (S)
unnamed: R722.2, R725.1, SW701.1 (A)
unnamed: R723.2, R726.1, SW702.1 (A)
unnamed: R724.2, R727.1, SW703.1 (A)
ORANGE_1: R710.1; also elsewhere on the board
ORANGE_2: R711.1; also elsewhere on the board
ORANGE_3: R712.1; also elsewhere on the board
SW_1: C710.1, R725.2; also elsewhere on the board
SW_2: C711.1, R726.2; also elsewhere on the board
SW_3: C712.1, R727.2; also elsewhere on the board

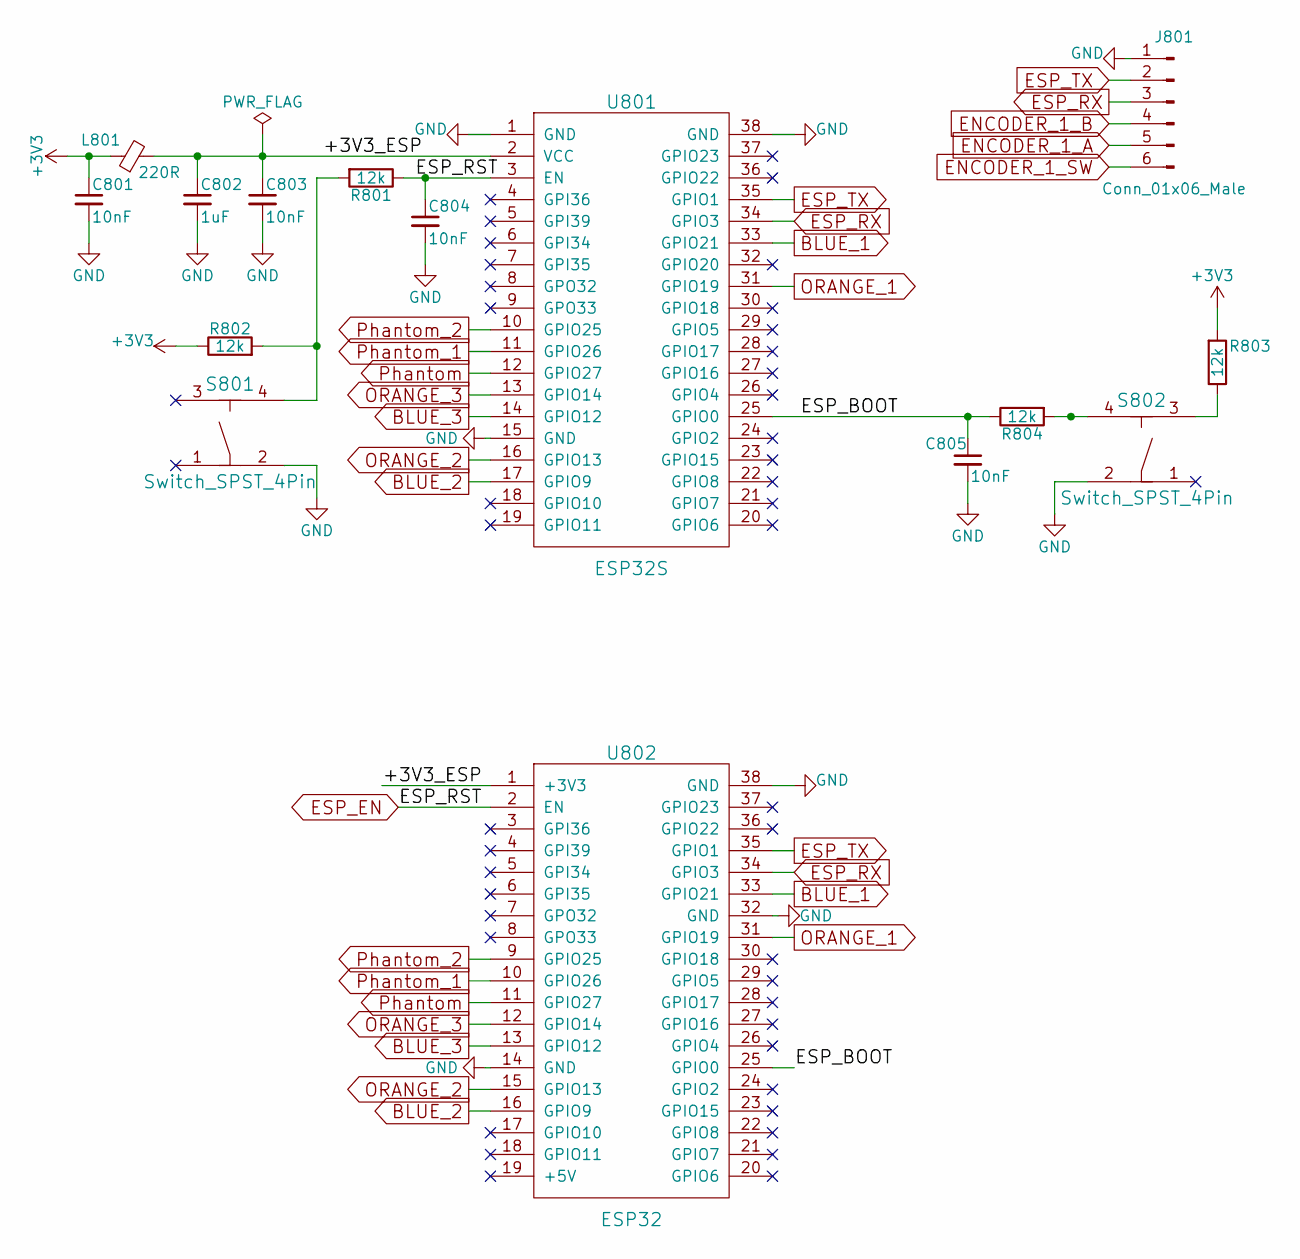
[picture p112: schematic ESP.sch]

Parts:
C801, C803, C804, C805: 10nF; C_0603
C802: 1uF; C_0603
J801: Conn_01x06_Male; Pin_Header_Straight_1x06_Pitch2.54mm_SMD_Pin1Right
L801: 220R; L_0603_HandSoldering
R801, R802, R803, R804: 12k; R_0603
S801, S802: Switch_SPST_4Pin; FSM4JSMATR
U801: ESP32S
U802: ESP32

Connections:
+3V3: C801.1, L801.1, R802.1, R803.2; also elsewhere on the board
/ESP/+3V3_ESP: C802.1, C803.1, L801.2, U801.2 (VCC), U802.1 (+3V3)
/ESP/ESP_BOOT: C805.1, R804.1, U801.25 (GPIO0), U802.25 (GPIO0)
BLUE_1: U801.33 (GPIO21), U802.33 (GPIO21); also elsewhere on the board
BLUE_2: U801.17 (GPIO9), U802.16 (GPIO9); also elsewhere on the board
BLUE_3: U801.14 (GPIO12), U802.13 (GPIO12); also elsewhere on the board
ENCODER_1_A: J801.5; also elsewhere on the board
ENCODER_1_B: J801.4; also elsewhere on the board
ENCODER_1_SW: J801.6; also elsewhere on the board
ESP_EN: C804.1, R801.1, U801.3 (EN), U802.2 (EN); also elsewhere on the board
ESP_RX: J801.3, U801.34 (GPIO3), U802.34 (GPIO3); also elsewhere on the board
ESP_TX: J801.2, U801.35 (GPIO1), U802.35 (GPIO1); also elsewhere on the board
GND: C801.2, C802.2, C803.2, C804.2, C805.2, J801.1, S801.2, S802.2, U801.1 (GND), U801.15 (GND), U801.38 (GND), U802.14 (GND), U802.32 (GND), U802.38 (GND); also elsewhere on the board
unnamed: R801.2, R802.2, S801.4
unnamed: R803.1, S802.3
unnamed: R804.2, S802.4
ORANGE_1: U801.31 (GPIO19), U802.31 (GPIO19); also elsewhere on the board
ORANGE_2: U801.16 (GPIO13), U802.15 (GPIO13); also elsewhere on the board
ORANGE_3: U801.13 (GPIO14), U802.12 (GPIO14); also elsewhere on the board
Phantom: U801.12 (GPIO27), U802.11 (GPIO27); also elsewhere on the board
Phantom_1: U801.11 (GPIO26), U802.10 (GPIO26); also elsewhere on the board
Phantom_2: U801.10 (GPIO25), U802.9 (GPIO25); also elsewhere on the board
