Tyrsz/Audio_Processor/PCB/IO board/Audio board.kicad_pcb

## KiCad design PCB/IO board/Audio board.kicad_pcb (continued)

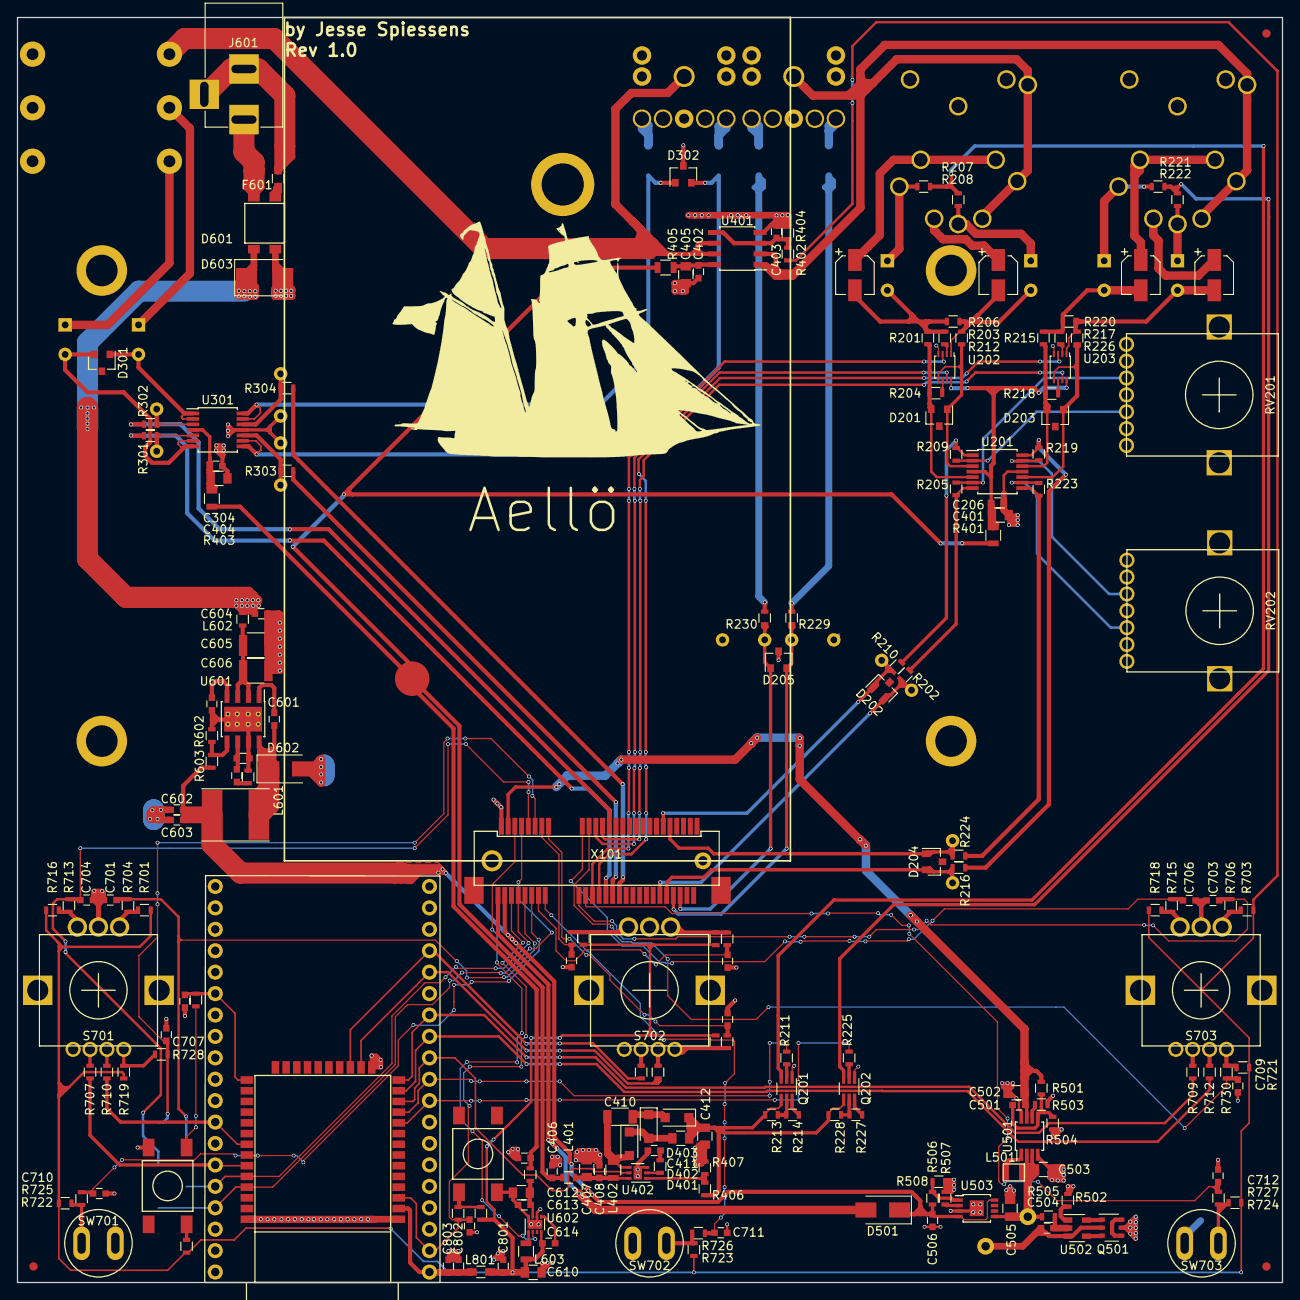
[picture p113: board Audio board.kicad_pcb from above]

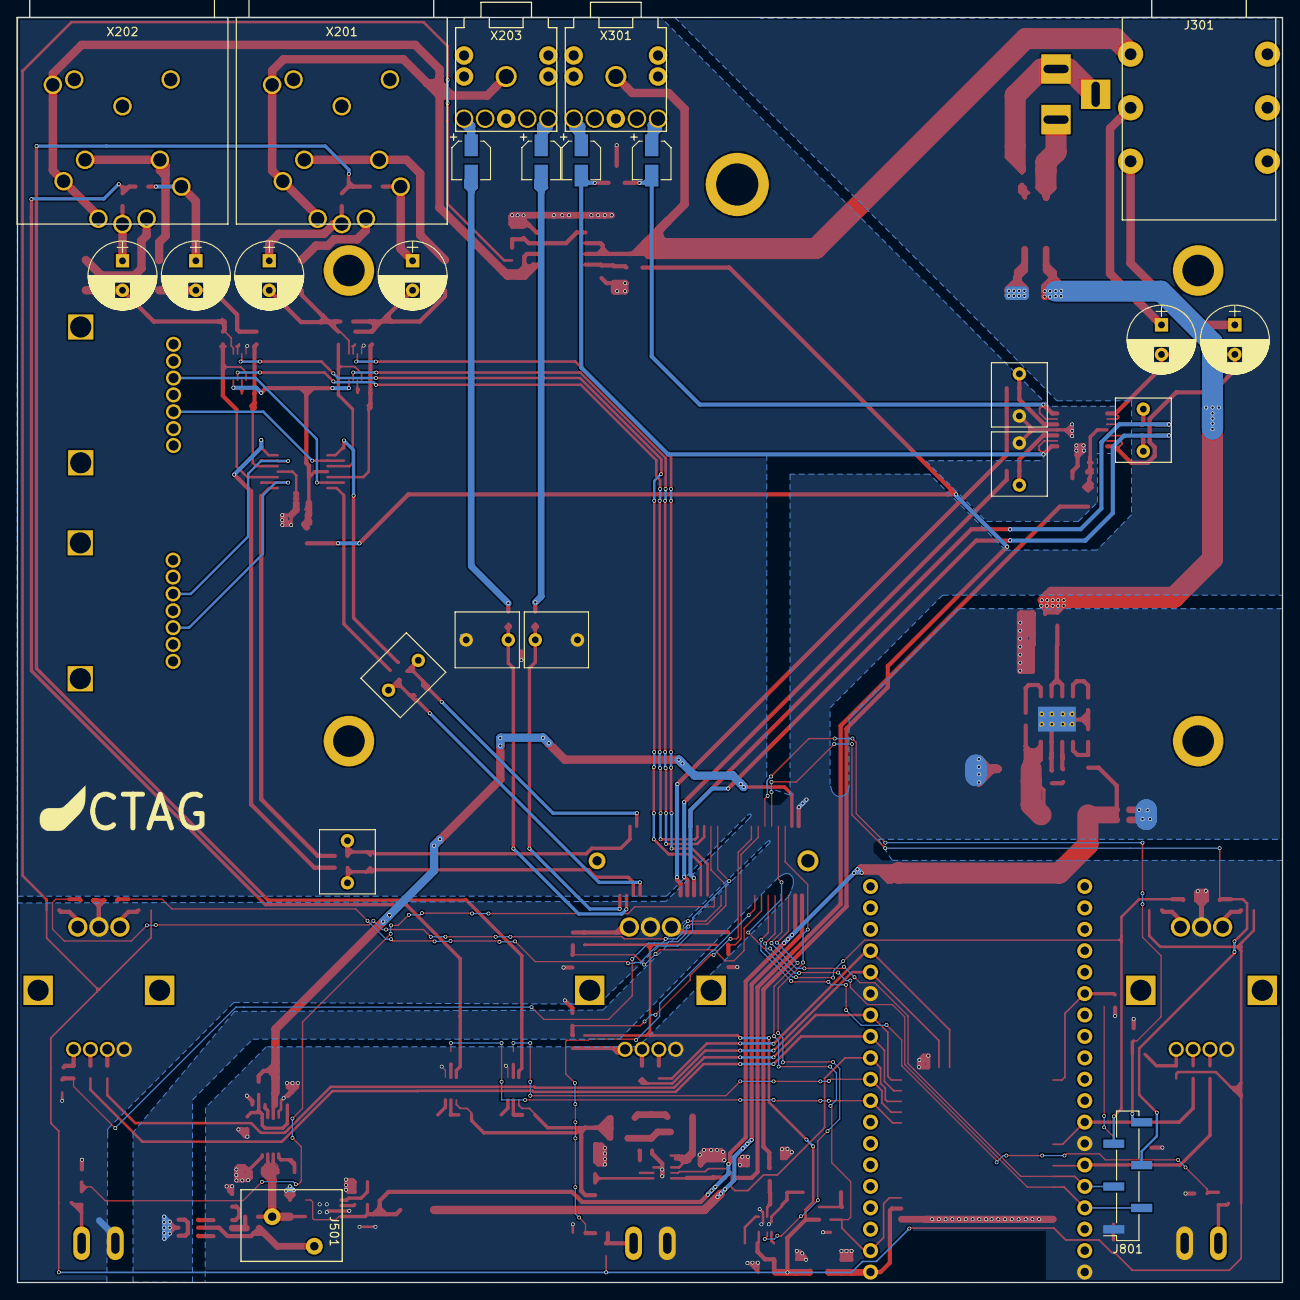
[picture p114: board Audio board.kicad_pcb from below]

Board: 2 copper layers, 150.0 x 150.0 mm, 223 parts (24 on the bottom side), 160 nets.

Other parts of the board:
C301, C303: 10uF 100V; CP_Radial_D8.0mm_P3.50mm
C302, C306, C307: 68nF; C_Rect_L7.5mm_W6.5mm_P5.00mm
C304: 100nF; C_0603
C305, C308: 10uF 10V; CP_Elec_4x5.3
D301, D302: MMBZ5V6ALT1G; SOT-23
J301: 6.3mm TRS; NMJ6HFD2-NW
R301, R302: 51R; R_0603
R303, R304: 100R; R_0603
U301: TLV9064; TSSOP-14_4.4x5mm_Pitch0.65mm
X301: SJ1-3525N; SJ1-352xN

Their connections:
+1V65_Outputs: J301.3, X301.1; also elsewhere on the board
+5V_Outputs: C304.1, U301.4; also elsewhere on the board
DAC1+: R301.1; also elsewhere on the board
DAC1-: R302.2; also elsewhere on the board
DAC2+: R303.1; also elsewhere on the board
DAC3+: R304.2; also elsewhere on the board
GND: C304.2, C306.2, C307.1, D302.3, U301.11; also elsewhere on the board
unnamed: C301.1, J301.1
unnamed: C301.2, D301.2, U301.6, U301.7
unnamed: C302.1, R301.2, U301.5
unnamed: C302.2, R302.1, U301.3
unnamed: C303.1, J301.2
unnamed: C303.2, D301.1, U301.1, U301.2
unnamed: C305.1, X301.2
unnamed: C305.2, D302.2, U301.8, U301.9
unnamed: C306.1, R303.2, U301.10
unnamed: C307.2, R304.1, U301.12
unnamed: C308.1, X301.3
unnamed: C308.2, D302.1, U301.13, U301.14
