Tyrsz/Audio_Processor/Code/Firmware_v1.0/Src/main.c

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

/* Includes ------------------------------------------------------------------*/
#include "main.h"

/* USER CODE BEGIN Includes */
#include "SDRAM.h"
#include "CODEC.h"
/* USER CODE END Includes */

/* USER CODE BEGIN PD */
#define RAM_D1_BASE	0x24000000
#define RAM_D2_BASE	0x30000000
#define RAM_D3_BASE	0x38000000
#define ATTR_RAM_D1 __attribute__((section(".D1_data")))
#define ATTR_RAM_D2 __attribute__((section(".D2_data")))
#define ATTR_RAM_D3 __attribute__((section(".D3_data")))

/* USER CODE END PD */


SAI_HandleTypeDef hsai_BlockA2;
SAI_HandleTypeDef hsai_BlockB2;
DMA_HandleTypeDef hdma_sai2_a;
DMA_HandleTypeDef hdma_sai2_b;

SPI_HandleTypeDef hspi5;

SDRAM_HandleTypeDef hsdram1;

/* USER CODE BEGIN PV */
 volatile uint32_t audio_in[8]  ATTR_RAM_D3;
 volatile uint32_t audio_out[8]  ATTR_RAM_D3;
 uint32_t array[8] ATTR_RAM_D3;
/* USER CODE END PV */

void SystemClock_Config(void);
static void MX_GPIO_Init(void);
static void MX_FMC_Init(void);
static void MX_SAI2_Init(void);
static void MX_SPI5_Init(void);
static void MX_DMA_Init(void);
/* USER CODE BEGIN 0 */
void HAL_SAI_RxCpltCallback(SAI_HandleTypeDef *hsai)
{

	 /*audio_out[1] = audio_in[2];
	 audio_out[2] = audio_in[3];*/
	 if (hsai_BlockB2.State == HAL_SAI_STATE_READY)   HAL_SAI_Transmit(&hsai_BlockB2, (uint8_t *)audio_in, 8, 100);

	 HAL_Delay(1);

}

/* USER CODE END 0 */

/**
  * @brief  The application entry point.
  * @retval int
  */
int main(void)
{
  

  /* Enable I-Cache---------------------------------------------------------*/
  SCB_EnableICache();

  /* Enable D-Cache---------------------------------------------------------*/
  SCB_EnableDCache();

  /* MCU Configuration--------------------------------------------------------*/

  /* Reset of all peripherals, Initializes the Flash interface and the Systick. */
  HAL_Init();

  /* Configure the system clock */
  SystemClock_Config();

  /* Initialize all configured peripherals */
  MX_GPIO_Init();
  MX_FMC_Init();
  MX_SAI2_Init();
  MX_SPI5_Init();
  MX_DMA_Init();
  /* USER CODE BEGIN 2 */
  SDRAM_Init(&hsdram1);
  SDRAM_Clear();

  CODEC_Init_TDM(&hspi5);
  for (uint16_t x = 0; x < 2000; x++)
  {
	  HAL_SAI_Receive(&hsai_BlockA2, (uint8_t *)array, 8, 100);
	  HAL_SAI_Transmit(&hsai_BlockB2, (uint8_t *)array, 8, 100);
  }
  HAL_SAI_Receive_DMA(&hsai_BlockA2, (uint8_t *)audio_in, 8);

  /* USER CODE END 2 */

  /* Infinite loop */
  /* USER CODE BEGIN WHILE */
  while (1)
  {


    /* USER CODE END WHILE */

    /* USER CODE BEGIN 3 */
  }
  /* USER CODE END 3 */
}

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
