Tyrsz/Audio_Processor/Code/Pin_check/pin_check.ioc

Mcu.UserName=STM32H743IITx
PA0-WKUP.Signal=ADC1_INP16
PA1.Signal=SAI2_MCLK_B
PA10.GPIO_Label=ANALOG_EN
PA10.Signal=GPIO_Output
PA11.Signal=SPI2_NSS
PA12.Signal=SAI2_FS_B
PA13.Signal=SYS_JTMS-SWDIO
PA14.Signal=SYS_JTCK-SWCLK
PA2.Signal=LTDC_R1
PA3.Signal=USB_OTG_HS_ULPI_D0
PA4.Signal=COMP_DAC11_group
PA5.Signal=USB_OTG_HS_ULPI_CK
PA6.Signal=ADCx_INP3
PA7.Signal=FMC_SDNWE
PA8.Signal=RCC_MCO_1
PA9.Signal=SPI2_SCK
PB0.Signal=USB_OTG_HS_ULPI_D1
PB1.Signal=USB_OTG_HS_ULPI_D2
PB10.Signal=USB_OTG_HS_ULPI_D3
PB11.Signal=USB_OTG_HS_ULPI_D4
PB12.Signal=USB_OTG_HS_ULPI_D5
PB13.Signal=USB_OTG_HS_ULPI_D6
PB14.Signal=SPI2_MISO
PB15.Signal=SPI2_MOSI
PB2.Signal=COMP1_INP
PB3.Signal=SYS_JTDO-SWO
PB5.Signal=USB_OTG_HS_ULPI_D7
PB6.Signal=I2C4_SCL
PB7.Signal=I2C4_SDA
PB8.Signal=I2C1_SCL
PB9.Signal=I2C1_SDA
PC0.Signal=USB_OTG_HS_ULPI_STP
PC1.Signal=ADCx_INP11
PC10.Signal=SDMMC1_D2
PC11.Signal=SDMMC1_D3
PC12.Signal=SDMMC1_CK
PC13.GPIO_Label=TFT_STBYB
PC13.Signal=GPIO_Output
PC14-OSC32_IN.Signal=RCC_OSC32_IN
PC15-OSC32_OUT.Signal=RCC_OSC32_OUT
PC4.Signal=FMC_SDNE0
PC5.Signal=COMP1_OUT
PC6.Signal=USART6_TX
PC7.Signal=USART6_RX
PC8.Signal=SDMMC1_D0
PC9.Signal=SDMMC1_D1
PD0.Signal=FMC_D2_DA2
PD1.Signal=FMC_D3_DA3
PD10.GPIO_Label=CODEC_INT
PD10.Signal=GPIO_Input
PD11.Signal=SAI2_SD_A
PD12.Signal=SAI2_FS_A
PD13.Signal=SAI2_SCK_A
PD14.Signal=FMC_D0_DA0
PD15.Signal=FMC_D1_DA1
PD2.Signal=SDMMC1_CMD
PD4.Signal=HRTIM_FLT3
PD5.Signal=HRTIM_EEV3
PD6.GPIO_Label=RED
PD6.Signal=GPIO_Output
PD7.GPIO_Label=GREEN
PD7.Signal=GPIO_Output
PD8.Signal=SPDIFRX_IN1
PD9.GPIO_Label=CODEC_NRST
PD9.Signal=GPIO_Output
PE0.Signal=FMC_NBL0
PE10.Signal=FMC_D7_DA7
PE11.Signal=SAI2_SD_B
PE12.Signal=SAI2_SCK_B
PE13.Signal=LTDC_DE
PE14.Signal=LTDC_CLK
PE15.Signal=LTDC_R7
PE2.GPIO_Label=TOUCH_NRESET
PE2.Signal=GPIO_Input
PE3.GPIO_Label=TOUCH_NINT
PE3.Signal=GPIO_Output
PE4.GPIO_Label=BACK_CTRL
PE4.Signal=GPIO_Output
PE5.Signal=LTDC_G0
PE6.Signal=LTDC_G1
PE7.Signal=FMC_D4_DA4
PE8.Signal=FMC_D5_DA5
PE9.Signal=FMC_D6_DA6
PF0.Signal=FMC_A0
PF1.Signal=FMC_A1
PF10.Signal=ADC3_INP6
PF11.Signal=FMC_SDNRAS
PF12.Signal=FMC_A6
PF13.Signal=FMC_A7
PF14.Signal=FMC_A8
PF15.Signal=FMC_A9
PF2.Signal=FMC_A2
PF3.Signal=FMC_A3
PF4.Signal=FMC_A4
PF5.Signal=FMC_A5
PF6.Signal=SPI5_NSS
PF7.Signal=SPI5_SCK
PF8.Signal=SPI5_MISO
PF9.Signal=SPI5_MOSI
PG0.Signal=FMC_A10
PG1.Signal=FMC_A11
PG10.Signal=LTDC_B2
PG11.Signal=LTDC_B3
PG12.Signal=LTDC_B1
PG13.Signal=LTDC_R0
PG14.Signal=LTDC_B0
PG15.Signal=FMC_SDNCAS
PG2.Signal=FMC_A12
PG4.Signal=FMC_A14_BA0
PG5.Signal=FMC_A15_BA1
PG6.Signal=HRTIM_CHE1
PG7.GPIO_Label=AUX_POWER
PG7.Signal=GPIO_Input
PG8.Signal=FMC_SDCLK
PG9.GPIO_Label=BLUE
PG9.Signal=GPIO_Output
PH0-OSC_IN.Signal=RCC_OSC_IN
PH1-OSC_OUT.Signal=RCC_OSC_OUT
PH10.Signal=LTDC_R4
PH11.Signal=LTDC_R5
PH12.Signal=LTDC_R6
PH13.Signal=LTDC_G2
PH14.Signal=LTDC_G3
PH15.Signal=LTDC_G4
PH2.Signal=FMC_SDCKE0
PH4.Signal=USB_OTG_HS_ULPI_NXT
PH5.GPIO_Label=SD_DET
PH5.Signal=GPIO_Input
PH8.Signal=LTDC_R2
PH9.Signal=LTDC_R3
PI0.Signal=LTDC_G5
PI1.Signal=LTDC_G6
PI10.Signal=LTDC_HSYNC
PI11.Signal=USB_OTG_HS_ULPI_DIR
PI2.Signal=LTDC_G7
PI4.Signal=LTDC_B4
PI5.Signal=LTDC_B5
PI6.Signal=LTDC_B6
PI7.Signal=LTDC_B7
PI8.GPIO_Label=BAT_POWER
PI8.Signal=GPIO_Input
PI9.Signal=LTDC_VSYNC
