Tyrsz/Audio_Processor/Code/Firmware_v1.0/Inc/CODEC.h

/*
 * CODEC.c
 *
 *  Created on: 7 mei 2018
 *      Author: Jesse Laptop
 */

#ifndef CODEC_C_
#define CODEC_C_



#endif /* CODEC_C_ */
#include "stm32h7xx_hal.h"
#include "main.h"


void CODEC_Init_TDM(SPI_HandleTypeDef *);
void CODEC_Write(SPI_HandleTypeDef *, uint8_t, uint8_t);
