Tyrsz/Audio_Processor/(commit log)

2018-03-23 Schematics Rev 1
    All schematics done - Revision 1
    [CODEC.sch, MCU.sch, MCU_Power.sch, Main board.kicad_pcb, Main board.sch, RAM.sch, SD.sch, Screen.sch]
2018-03-29 Schematics + Footprints Rev.1
    Ready to route.
    [CODEC.sch, MCU.sch, MCU_Power.sch, Main board.sch, RAM.sch, SD.sch, Screen.sch, Supply.sch]
2018-03-30 Schematics & PCB
    Schematics update - ERC error fixing
    PCB - setup & PCB outline
    [CODEC.sch, MCU.sch, MCU_Power.sch, Main board.sch, RAM.sch, SD.sch, Screen.sch, Supply.sch]
2018-03-30 Schematic updates + PCB placement
    [CODEC.sch, Main board.kicad_pcb, Screen.sch]
2018-04-01 Component Placement - RN
    All components placed except for RAM Resistor Networks
    [MCU_Power.sch, Main board.kicad_pcb, SD.sch, Screen.sch]
2018-04-02 RAM Routing - Data
    All RAM routing & matching done, supply still needs to be done
    [MCU.sch, Main board.kicad_pcb, Main board.sch, RAM.sch, Screen.sch]
2018-04-03 RAM + Display
    Ram & display routed + matched-ish
    [MCU.sch, Main board.kicad_pcb, Main board.sch]
2018-04-03 High Speed routing
    High speed routing (USB, SDMMC, CODEC, RAM and Screen) are hooked up
    [Main board.kicad_pcb]
2018-04-04 PCI almost routed
    [Main board.kicad_pcb]
2018-04-05 Almost done routing
    20 connections to be made.
    [Main board.kicad_pcb]
2018-04-05 Routing done Rev 1
    Still need to add some testpoints and art
    [Main board.kicad_pcb, Main board.sch]
2018-04-06 Added Testpoints
    [CODEC.sch, MCU.sch, MCU_Power.sch, Main board.kicad_pcb, Main board.sch, RAM.sch, SD.sch, Screen.sch]
2018-04-08 Added ground fills & art
    [Main board.kicad_pcb]
2018-04-09 Minor updates keepout
    [Main board.kicad_pcb]
2018-04-10 Gerbers created
    [Main board-B.Cu.gbr, Main board-B.Mask.gbr, Main board-B.SilkS.gbr, Main board-Edge.Cuts.gbr, Main board-F.Cu.gbr, Main board-F.Mask.gbr, Main board-F.SilkS.gbr, Main board-In1.Cu.gbr]
2018-04-10 Addedd paste to gerbers
    [Main board.kicad_pcb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]
2018-04-18 Audio board project added
    [Audio board.kicad_pcb, Audio board.sch]
2018-04-18 Inputs done
    [Inputs.sch]
2018-04-19 Schematics without ESP
    [Audio Supplies.sch, Audio board.sch, Battery.sch, IO.sch, Inputs.sch, Supply.sch, outputs.sch]
2018-04-21 Schematics Rev 1.0
    [Audio Supplies.sch, Audio board.sch, Battery.sch, ESP.sch, IO.sch, Inputs.sch, Supply.sch, outputs.sch]
2018-04-21 Component Placement - No pul-up
    ALmost finished component placement expect for pull ups and low pass
    filters for switches etc
    [Audio Supplies.sch, Audio board.sch, Battery.sch, ESP.sch, IO.sch, Inputs.sch, Supply.sch, outputs.sch]
2018-04-22 PCB Backup
    [Audio board.kicad_pcb, Battery.sch, ESP.sch, IO.sch]
2018-04-23 IO board Rev 1.0 RC-1
    Board for inspection by Supervisor
    [Audio board.kicad_pcb, Audio board.sch, ESP.sch]
2018-04-23 Rev 1.0 RC1 gerbers
    [Audio board-B.Cu.gbr, Audio board-B.Mask.gbr, Audio board-B.Paste.gbr, Audio board-B.SilkS.gbr, Audio board-Edge.Cuts.gbr, Audio board-F.Cu.gbr, Audio board-F.Mask.gbr, Audio board-F.Paste.gbr]
2018-04-23 IO Rev 1.0 RC2 + Gerbers
    ESP antenna keepout added
    [Audio board-B.Cu.gbr, Audio board-B.Mask.gbr, Audio board-B.Paste.gbr, Audio board-B.SilkS.gbr, Audio board-Edge.Cuts.gbr, Audio board-F.Cu.gbr, Audio board-F.Mask.gbr, Audio board-F.Paste.gbr]
2018-05-08 SPI + SDRAM working
    No interrupts
    [Audio board.kicad_pcb, Compute_Blink Run.cfg, Firmware_v0.0 Debug.cfg, Main board.kicad_pcb]
2018-05-11 SPI + Audio working in blocking mode
2018-05-11 Revert "TDM Working blocking mod"
    This reverts commit 89f7c79b6d21f6a7bfbc521e90000ab89b4e23d1.
    [CODEC.c, Firmware_v0.0.ioc, main.c]
2018-05-18 DMA Working
    [Main board.kicad_pcb]
2019-11-11 SDRAM + Schematic Plot
    fixed typo in FMC_Play
    replotted schematics
    [SDRAM.c, SDRAM.h]
2019-11-11 SDRAM fix + Firmware v1.0 start
    Fixed hardfault in FMC_play
    Made new project using latest HAL and CubeMX
    MCU now runs at 480MHz, RAM at 120MHz
    [FMC_play.ioc, Firmware_v1.0.ioc, SDRAM.c, SDRAM.h, main.c, main.h]
2019-11-17 SAI attempts
    works in blocking mode
    DMA mode only gets one sample, then stops even though it should still be running
